Vinomakon/6-Axis-Robotarm/Arbeitsjournal.docx

Datum | Zeitaufwand | Abteil | Beschreibung
04.02.2025 | 60 min. | O | - Erstellung eines (Zeit-)Plans für die Durchführung der Arbeit
04.02.2025 | 90 min. | I | - Recherche nach einem passendem Microcontroller
07.02.2025 | 180 min. | D, P | - Testierung und Implementierung eines Motor-Treibers (TMC2130)
07.02.2025 | 180 min. | D | - Programmierung des ESP32
10.02.2025 | 180 min. | D | - Programmierung des ESP32
11.02.2025 | 240 min. | D | - Programmierung des ESP32 - Programmierung von einer Verbindung zwischen PC und ESP32
12.02.2025 | 180 min. | D, P | - Programmierung des ESP32 - Programmierung einer Funktionalität, um die Motoren per PC kontrollieren zu können (Siehe Video (https://youtu.be/VOz3QwY5qU8?si=MYe8dEC4yiWHyUO3))
14.02.2025 | 120 min. | D, P | - Programmierung des ESP32
20.02.2025 | 120 min. | D, P | - Testierung von grösseren Motoren mit einem Getriebegehäuse - Programmierung des ESP32
24.02.2025 | 120 min. | D, P | - Programmierung des ESP32 - Entwurf eines PCBs, das alle nötigen Komponenten halten kann
25.02.2025 | 180 min. | D | - Entwurf einer neuen PCB (v2)
26.02.2025 | 180 min. | D | - Finalisierung des PCB (v2)
26.02.2025 | 30 min. | O, I | - Standort-Besprechung
13.04.2025 | 120 min. | D, P | - Testierung und Bau eines Belt-drives
14.04.2025 | 240 min. | D, P | - Testierung und Bau eines Belt-drives
15.04.2025 | 180 min. | D, P | - Testierung und Bau eines Belt-drives
16.04.2025 | 120 min. | D, P | - Kreierung einer Basis, um die Haupt-PCB zu kühlen - Testierung der PCB mit einem neuen Code und des Belt-drives
26.06.2025 | 180 min. | D, P | - Arbeit an dem 3en Teil (3er Motor) des Roboter-Arms - Übertragung des Projektes von Fusion 360 auf Solidworks
08.07.25 | 180 min. | D, P | - Arbeit an dem 3en Teil (3er Motor) des Roboter-Arms - Übertragung des Projektes von Fusion 360 auf Solidworks
09.07.25 | 300 min. | D, P | - Arbeit an dem 3en Teil (3er Motor) des Roboter-Arms - Übertragung des Projektes von Fusion 360 auf Solidworks
14.07.25 | 240 min. | D, P | - Überarbeitung vom 2en Teil des Roboterarms aufgrund von Instabilität und eigener Wunsch an Verbesserung - Übertragung des 3en Teils von Fusion 360 in Solidworks - Weitere Arbeit am 3en Teil
15.07.2025 | 300 min. | D, P | - Überarbeitung vom 2en Teil des Roboterarms aufgrund von Instabilität und eigener Wunsch an Verbesserung - Übertragung des 3en Teils von Fusion 360 in Solidworks - Weitere Arbeit am 3en Teil
15.07.2025 | 10 min. | I | - Suche nach einem Namen für den Roboter
18.07.2025 | 60 min. | D, P | - Arbeit am 4en Teil des Roboterarms
20.07.2025 | 300 min. | D, P | - Arbeit am 4en Teil des Roboterarms
21.07.2025 | 180 min. | D, P | - Arbeit am 4en Teil des Roboterarms - Arbeit am 5en Teil des Roboterarms
22.07.2025 | 180 min. | D, P | - Arbeit am 6en Teil des Roboterarms - Testierung aller Teile Zusammen (Ausser der Rotationsbasis) - Troubleshooting mit Übergewichtung (Wechseln auf 24V, mehr Stromstärke)
23.07.2025 | 120 min. | D | - Verbesserung des Codes zuständig für die Kontrolle des Roboters (UI, Config Load/Save, Grössere Anzahl an verstellbaren Einstellungen)
24.07.2025 | 180 min. | D | - Verbesserung des Codes zuständig für die Kontrolle des Roboters (UI, Config Load/Save, Grössere Anzahl an verstellbaren Einstellungen, bessere und überblickbarere Interface) - Verbesserung des Codes vom ESP32 (Optimisierung, Anpassung zu den Veränderungen im Python-Code)
25.07.2025 | 180 min. | D, P | - Troubleshooting an inkorrekter Kommunikation zwischen PC und ESP32 - Troubleshooting an der Limitierung der Stromstärke - Bugfixing
29.07.2025 | 120 min. | D, P | - Arbeit am 2en und 1en Teil des Roboters
02.08.2025 | 180 min. | D, P | - Arbeit am 2en und 1en Teil des Roboters - Verbesserung vom 4en Teil vom Roboterarm
03.08.2025 | 300 min. | D, P | - Arbeit am 2en und 1en Teil des Roboters - Weitere Verbesserungen an jeglichen Teilen des Roboterarms - Zusammenstellung einer digitalen Konstruktion von allen Modellen und Teilen in eine übersichtliche und effektive Visualisierung des ganzen Roboterarms
05.08.2025 | 180 min. | D, P | - Überarbeitung des 3en Teils des Roboterarms - Löten und Anfertigung von einer neuen Platte
06.08.2025 | 240 min. | D, P | - Überarbeitung des 3en und 4en Teils des Roboterarms
07.08.2025 | 240 min. | D, P | - Überarbeitung des 3en Teils des Roboterarms - Troubleshooting an C++ code - Zusammenstellung des ersten funktionstüchtigen Prototyps aus allen Teilen und kurzes Testen (MEILENSTEIN)
10.08.2025 | 180 min | D, P | - Anfang an der Implementation von IK (Inverse Kinematics) in das Projekt (1. Schritt: Herausfinden, wie die Winkel anhand von einer Position berechnet werden können)
11.08.2025 | 120 min. | D, P | - (Theoretische und praktische Auseinandersetzung, dazu auch das Verstehen, wie so ein Prozess abläuft) - Programmierung von einem Test-Programm, um das IK-Prinzip vorerst zu testen (Eigene Class «Vector», «Euler’sche» Rotationsmatrix)
12.08.2025 | 90 min. | D, P | - Weiterführung an der Implementation von IK - Programmierung von einem Test-Programm, um das IK-Prinzip vorerst zu testen
14.08.2025 | 40 min. | D, P | - Einsetzung und Testierung des Homings
15.08.2025 | 90 min. | D, P | - Programmierung der Homing-Sequenz und praktische Testung des Homings auf dem Roboter - Überarbeitung des 5en Teils für die Verkabelung
16.08.2025 | 60 min. | D, P | - Überarbeitung des 6en Teils für die Verkabelung
17.08.2025 | 60 min. | D, P | - Zusammensetzung des Roboters mit der besseren Verkabelung - Bessere Verkabelung für eine bessere visuelle Ansicht - Löten der Limit-Switches und deren Anbringung an den Roboter
21.08.2025 | 120 min. | D | - Implementation von des erstellten IK-Porgramms in den UI und in den C++ Code (Kein Praktisches Testen aufgrund von Zusammenbruch vom Labornetzgerät)

Organisation, Informationsbeschaffung, Digitale Arbeit, Praktische Arbeit, Auswertung
