Vinomakon/6-Axis-Robotarm/Documents/Dokumentation/LaTeX Dokumentation/images/KiCAD/Driver Carrier v2_Page_2 cropped.png

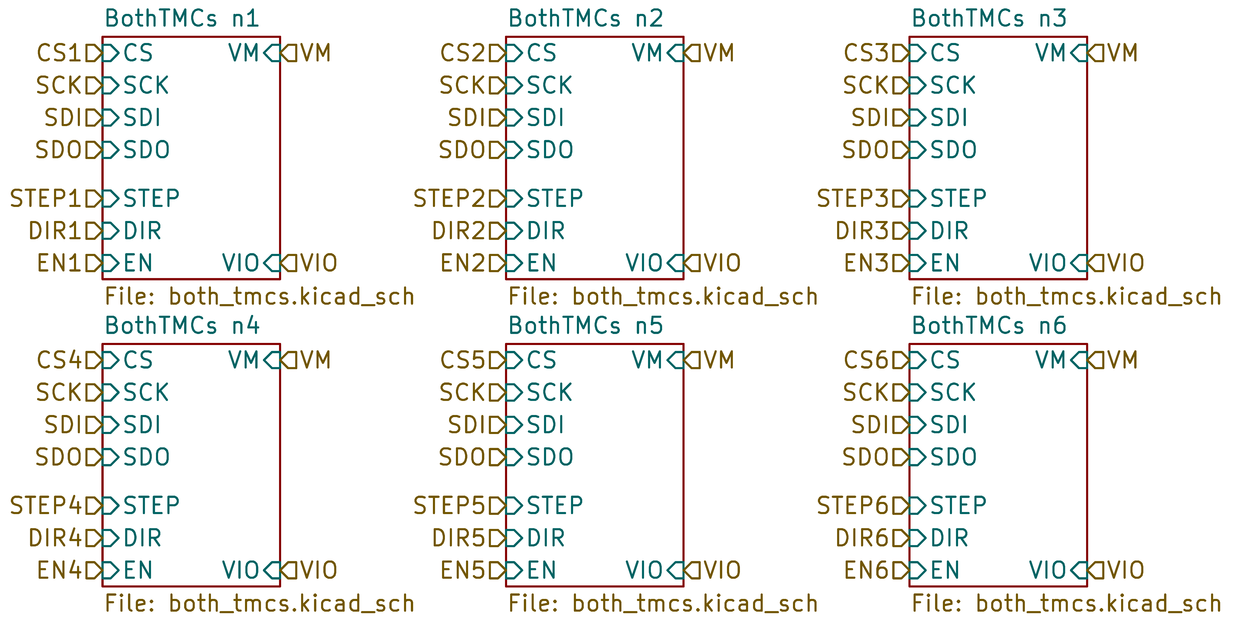
Documents/Dokumentation/LaTeX Dokumentation/images/KiCAD/Driver Carrier v2_Page_2 cropped.png
