Vinomakon/6-Axis-Robotarm/Documents/Dokumentation/LaTeX Dokumentation/images/Online/Phase Stepping.png

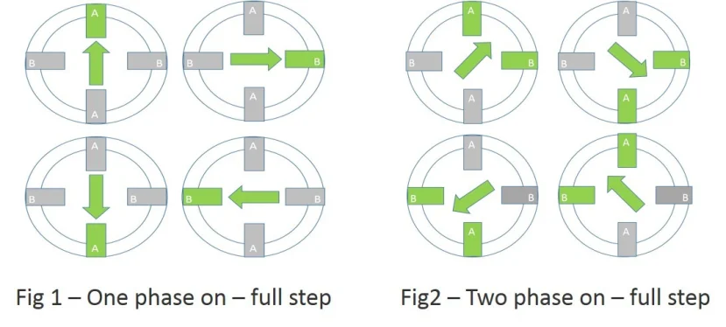
Documents/Dokumentation/LaTeX Dokumentation/images/Online/Phase Stepping.png
