Vinomakon/6-Axis-Robotarm/Documents/Dokumentation/LaTeX Dokumentation/images/Solidworks/Arm1_v3 Front.PNG

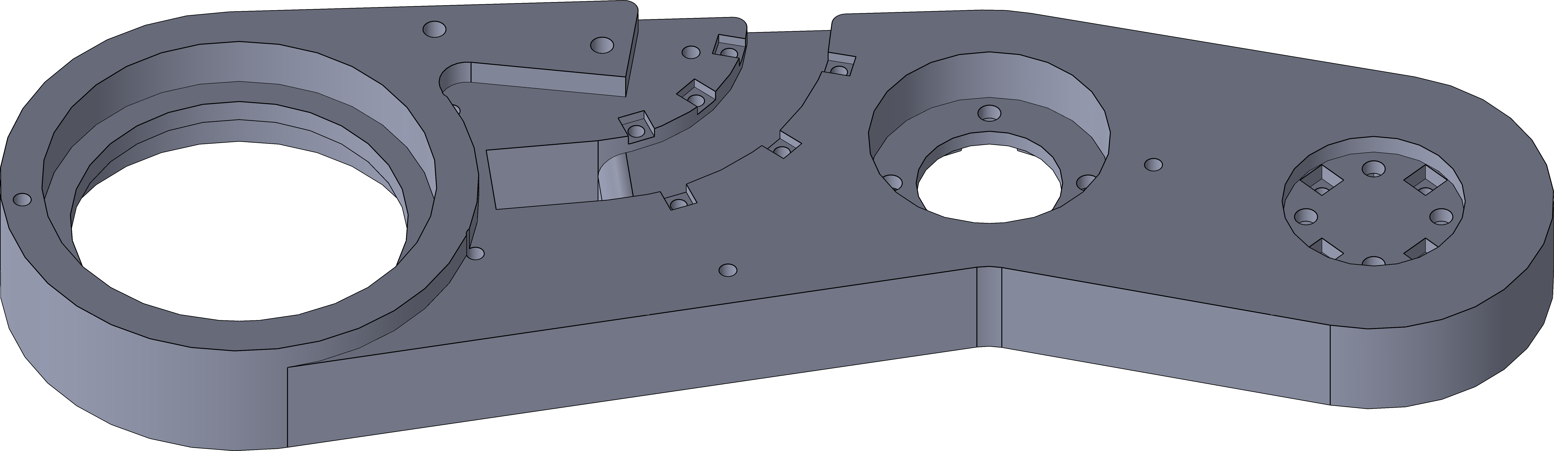
Documents/Dokumentation/LaTeX Dokumentation/images/Solidworks/Arm1_v3 Front.PNG
