Vinomakon/6-Axis-Robotarm/Documents/Dokumentation/LaTeX Dokumentation/images/Solidworks/Arm1Pulley1_v2.PNG

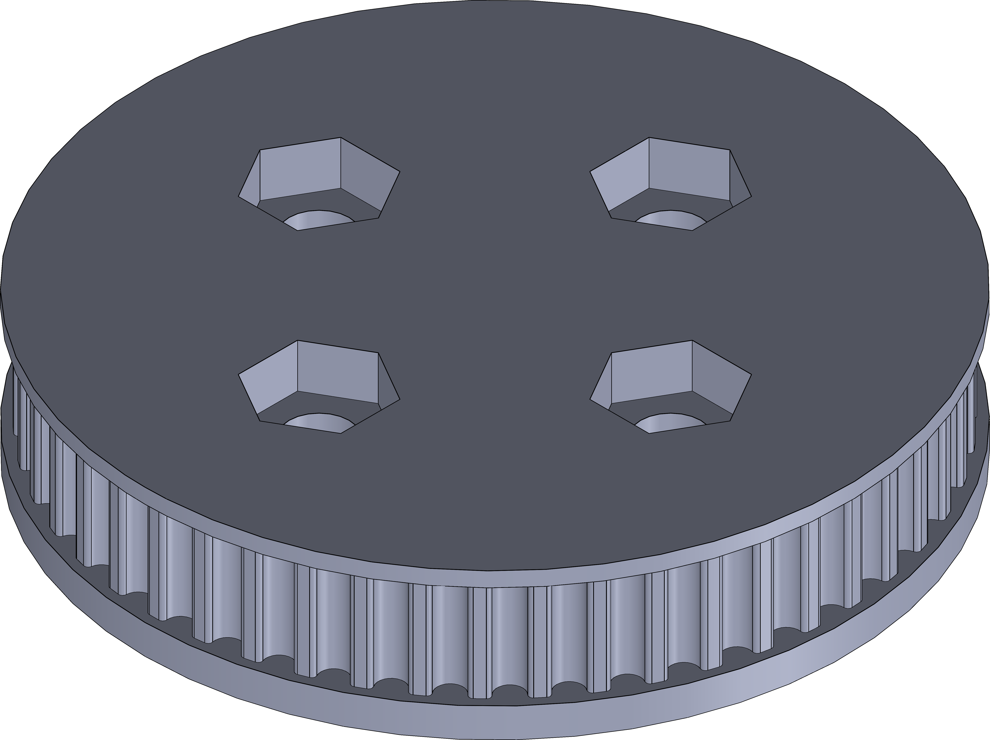
Documents/Dokumentation/LaTeX Dokumentation/images/Solidworks/Arm1Pulley1_v2.PNG
