Vinomakon/6-Axis-Robotarm/Documents/Dokumentation/LaTeX Dokumentation/images/Solidworks/Arm1Pulley2_v1 Front.PNG

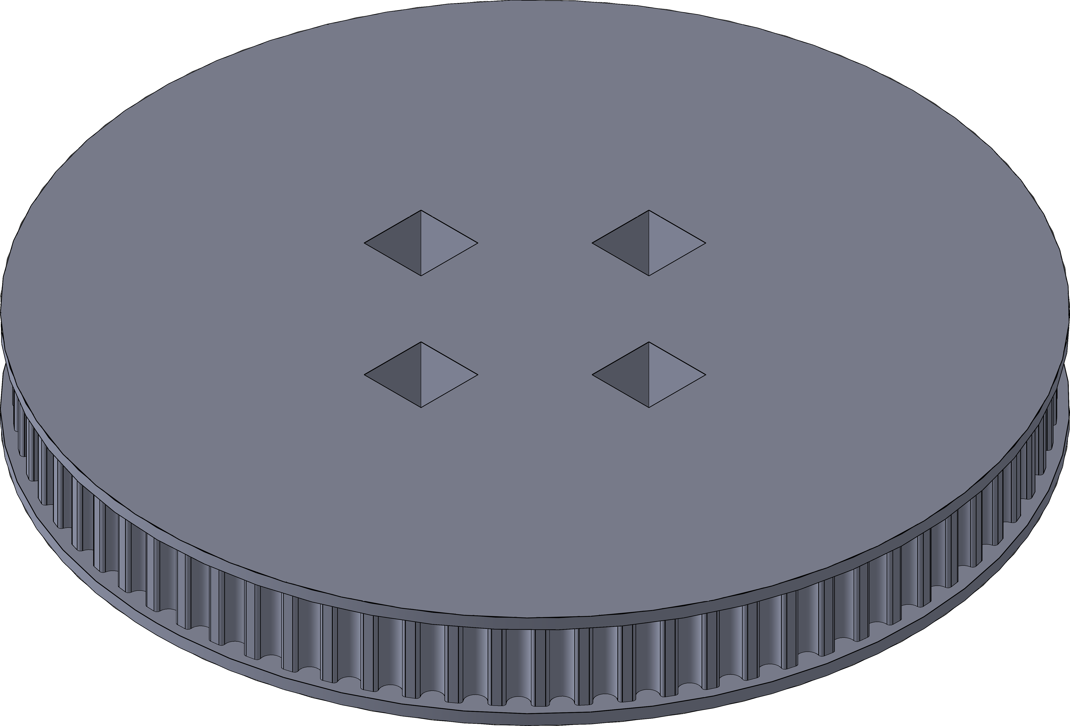
Documents/Dokumentation/LaTeX Dokumentation/images/Solidworks/Arm1Pulley2_v1 Front.PNG
