Vinomakon/6-Axis-Robotarm/Documents/Dokumentation/LaTeX Dokumentation/images/Solidworks/Arm2_v1 Back.PNG

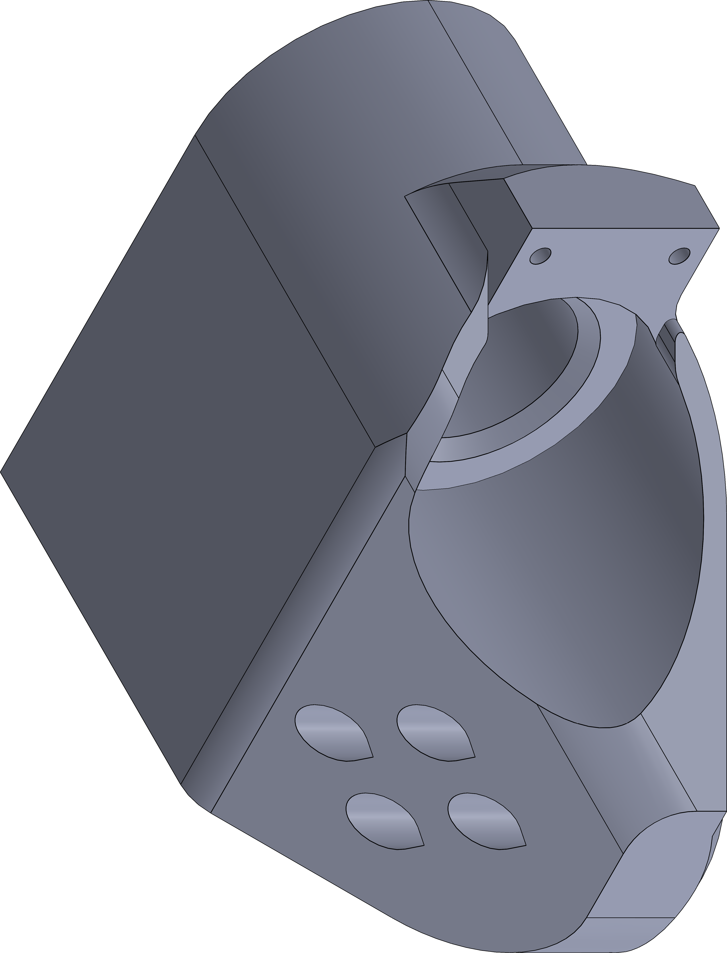
Documents/Dokumentation/LaTeX Dokumentation/images/Solidworks/Arm2_v1 Back.PNG
