Vinomakon/6-Axis-Robotarm/Documents/Dokumentation/LaTeX Dokumentation/images/Solidworks/Arm2_v2 Back.PNG

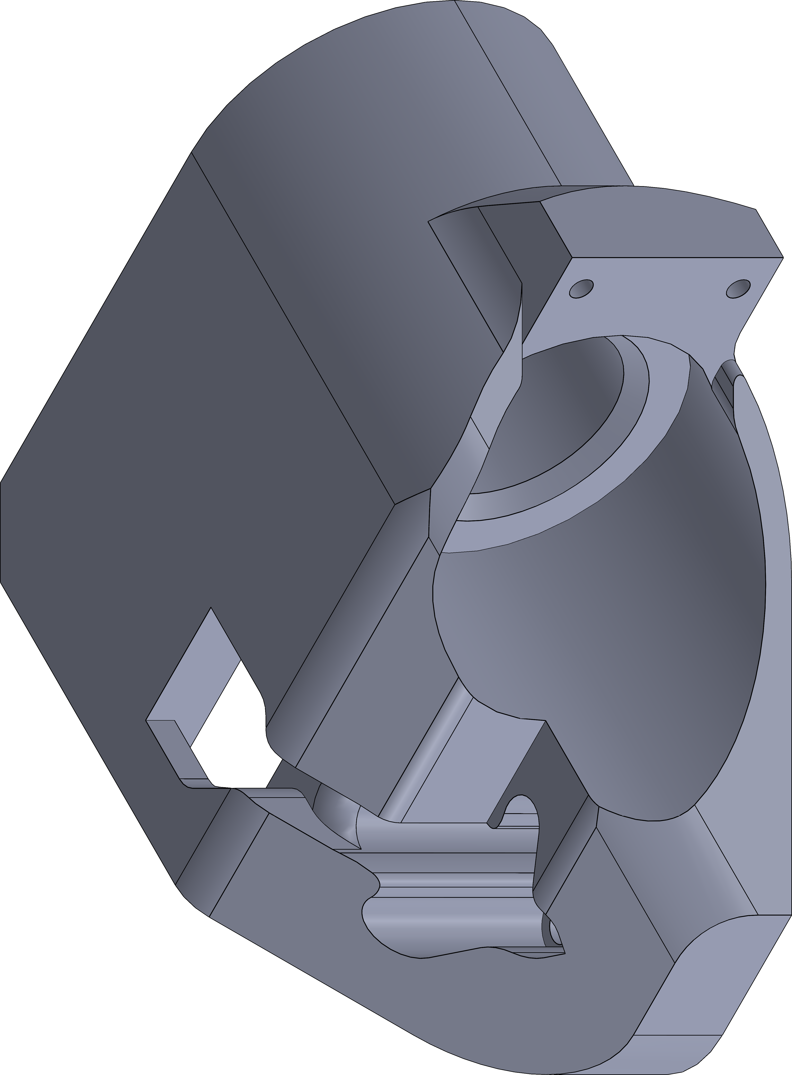
Documents/Dokumentation/LaTeX Dokumentation/images/Solidworks/Arm2_v2 Back.PNG
