Vinomakon/6-Axis-Robotarm/Documents/Dokumentation/LaTeX Dokumentation/images/Solidworks/Arm3_v2 Front.PNG

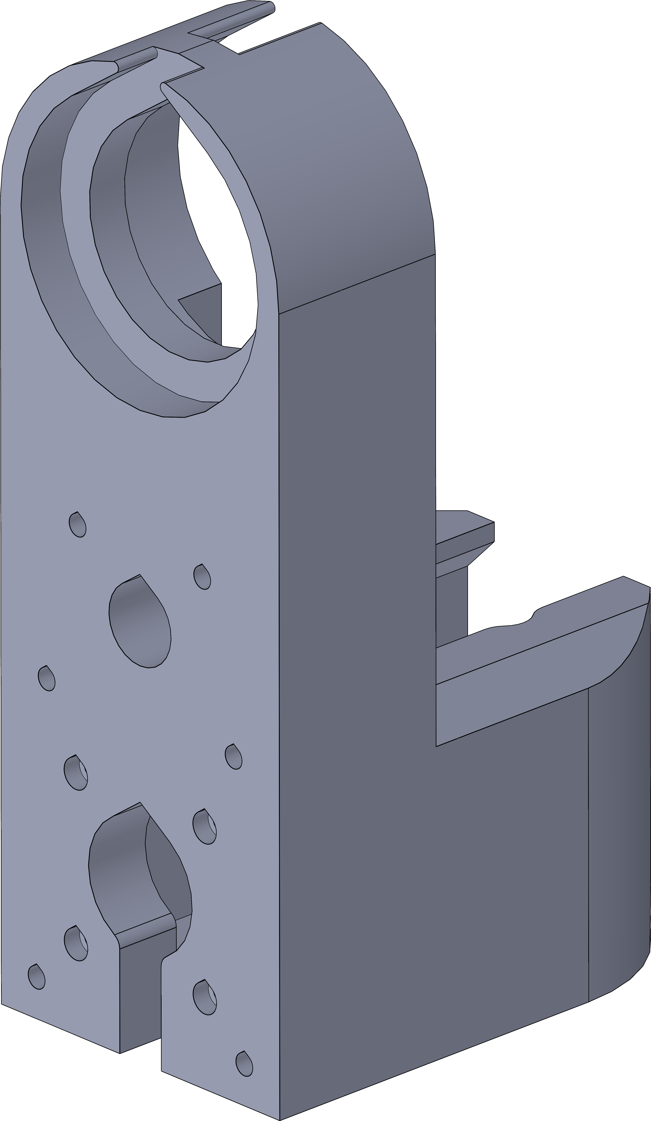
Documents/Dokumentation/LaTeX Dokumentation/images/Solidworks/Arm3_v2 Front.PNG
