Vinomakon/6-Axis-Robotarm/Documents/Dokumentation/LaTeX Dokumentation/images/Solidworks/Arm3Pulley_v1.PNG

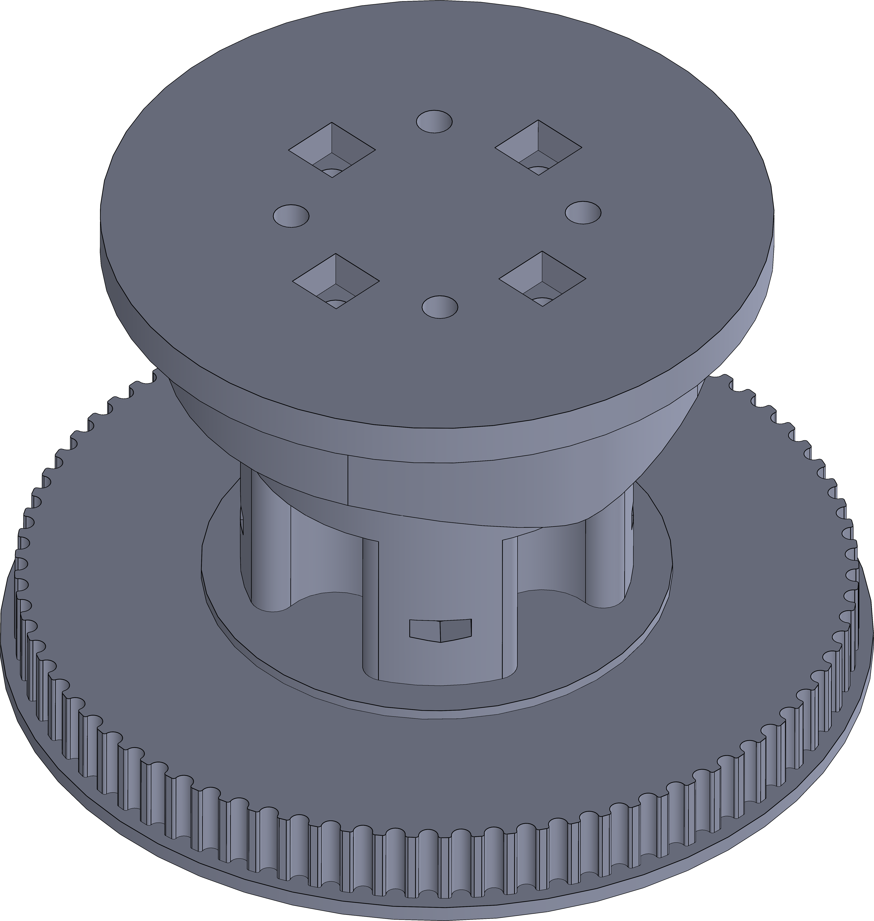
Documents/Dokumentation/LaTeX Dokumentation/images/Solidworks/Arm3Pulley_v1.PNG
