Vinomakon/6-Axis-Robotarm/Documents/Dokumentation/LaTeX Dokumentation/images/Solidworks/Arm4_v2.PNG

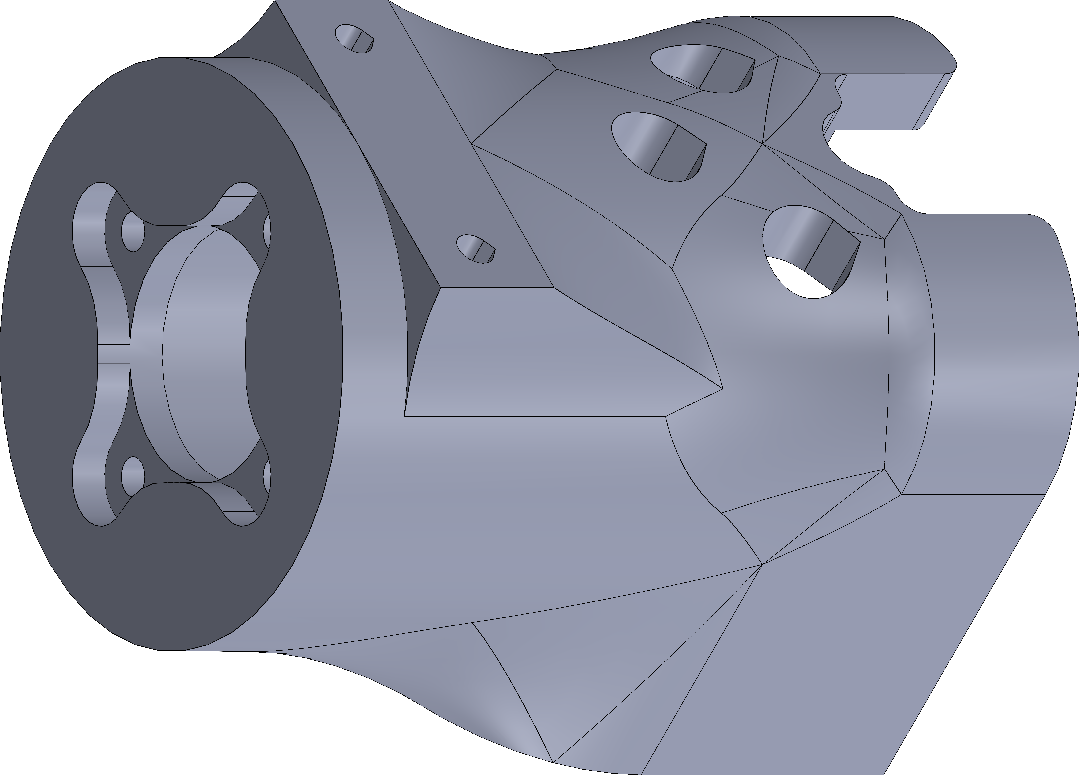
Documents/Dokumentation/LaTeX Dokumentation/images/Solidworks/Arm4_v2.PNG
