Vinomakon/6-Axis-Robotarm/Documents/Dokumentation/LaTeX Dokumentation/images/Solidworks/Base_v1.PNG

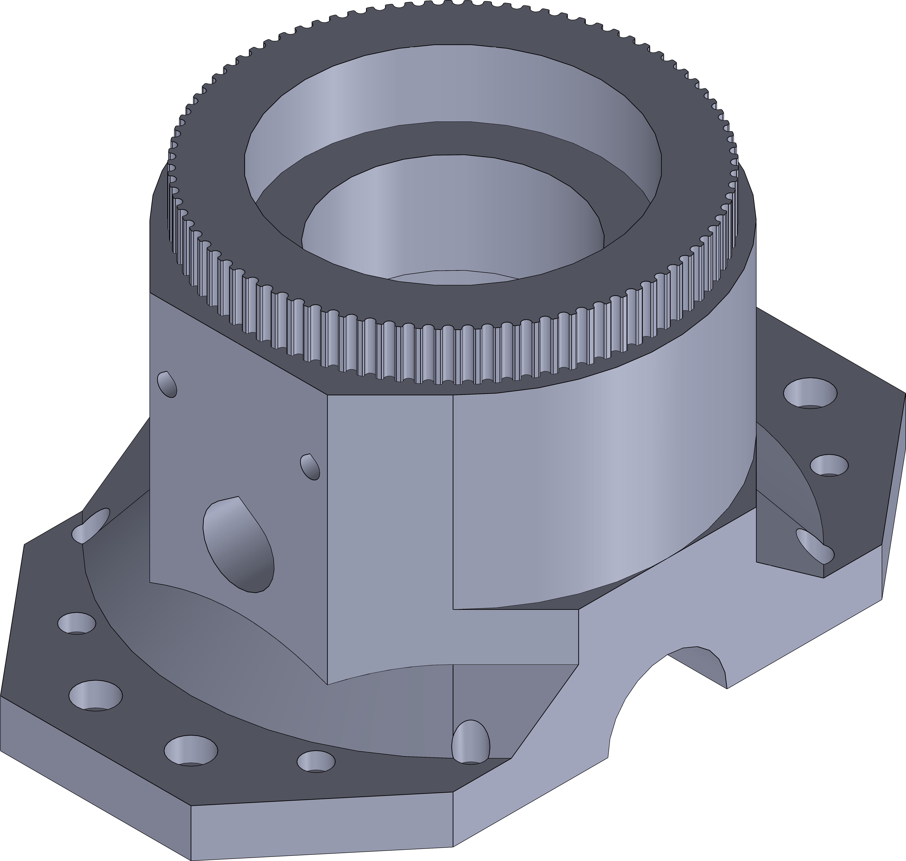
Documents/Dokumentation/LaTeX Dokumentation/images/Solidworks/Base_v1.PNG
