Vinomakon/6-Axis-Robotarm/Pictures/Screenshot 2025-06-26 232931.png

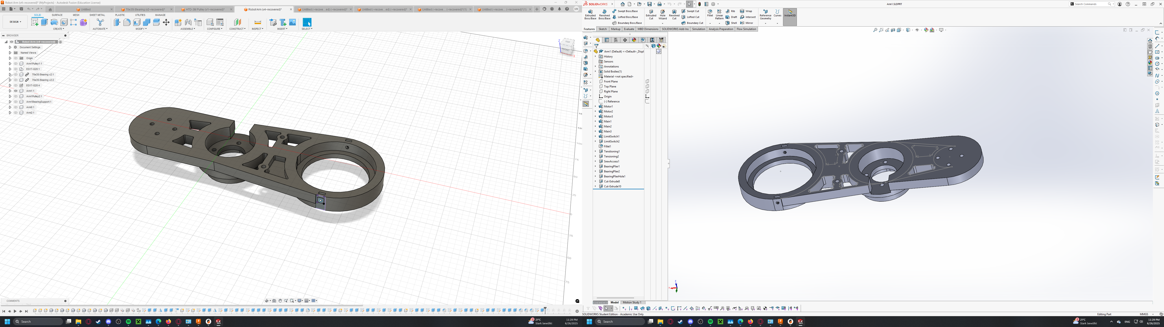
Pictures/Screenshot 2025-06-26 232931.png
