Vinomakon/6-Axis-Robotarm/Pictures/Screenshot 2025-07-10 113203.png

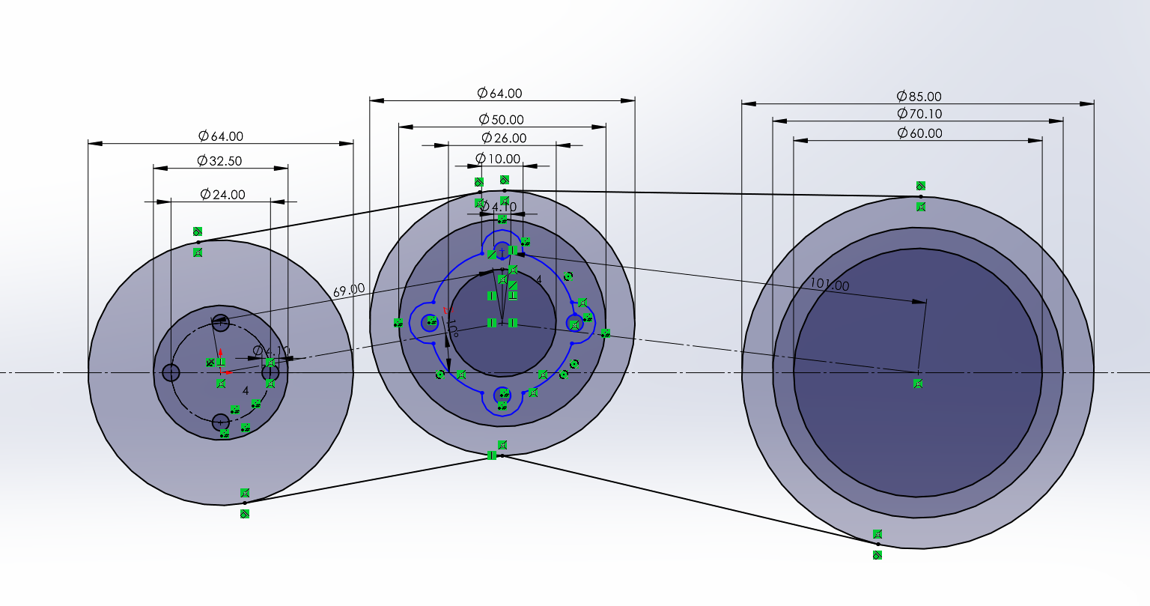
Pictures/Screenshot 2025-07-10 113203.png
