Vinomakon/6-Axis-Robotarm/Pictures/Screenshot 2025-07-20 194154.png

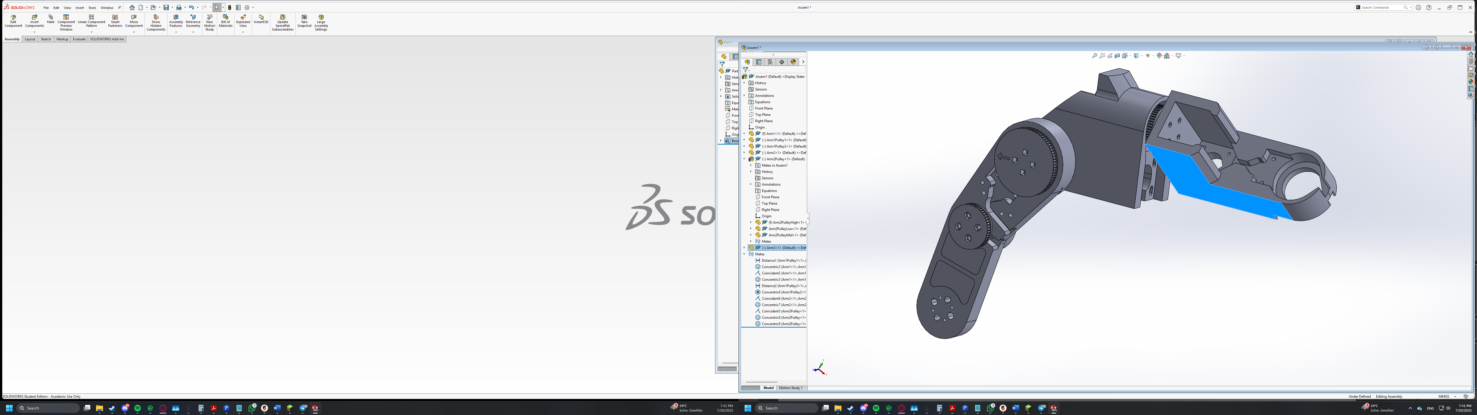
Pictures/Screenshot 2025-07-20 194154.png
