Vinomakon/6-Axis-Robotarm/Pictures/Screenshot 2025-07-26 214147.png

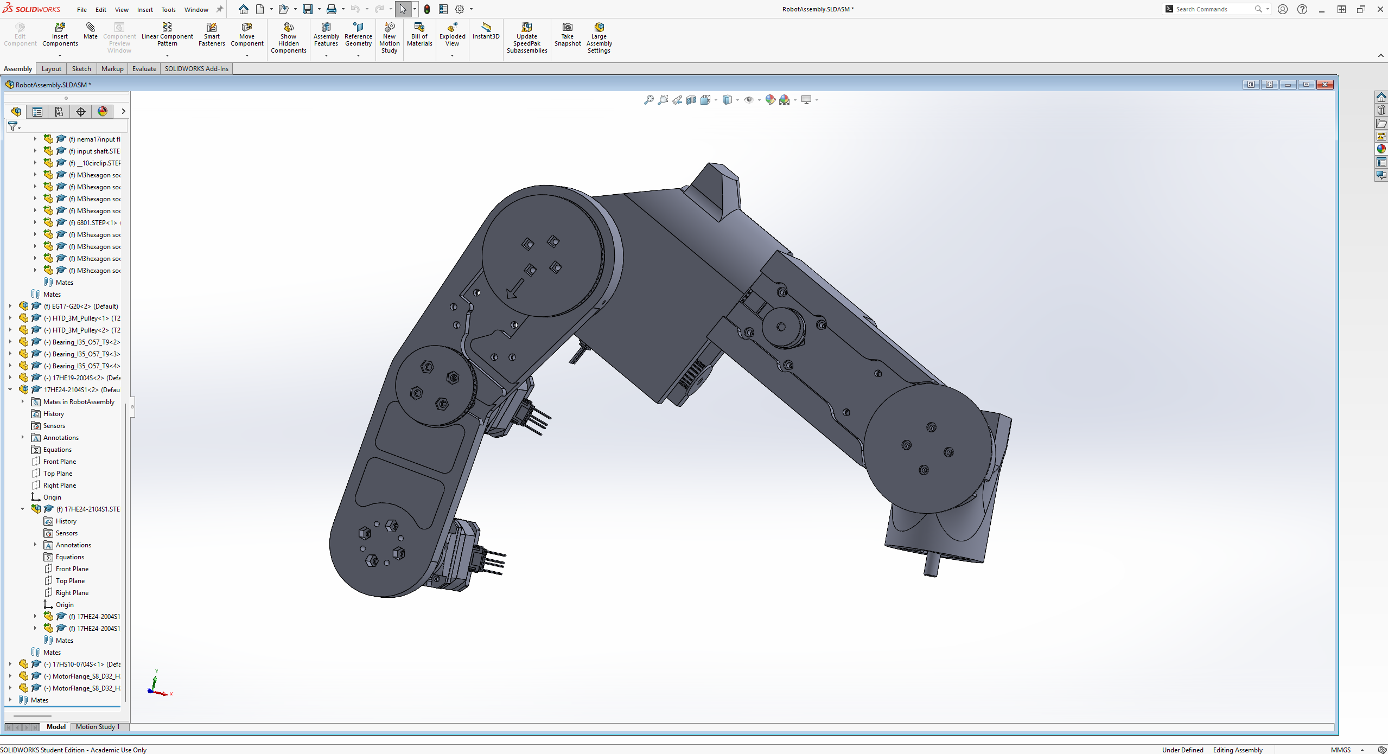
Pictures/Screenshot 2025-07-26 214147.png
