Vinomakon/6-Axis-Robotarm/Pictures/Screenshot 2025-07-31 211233.png

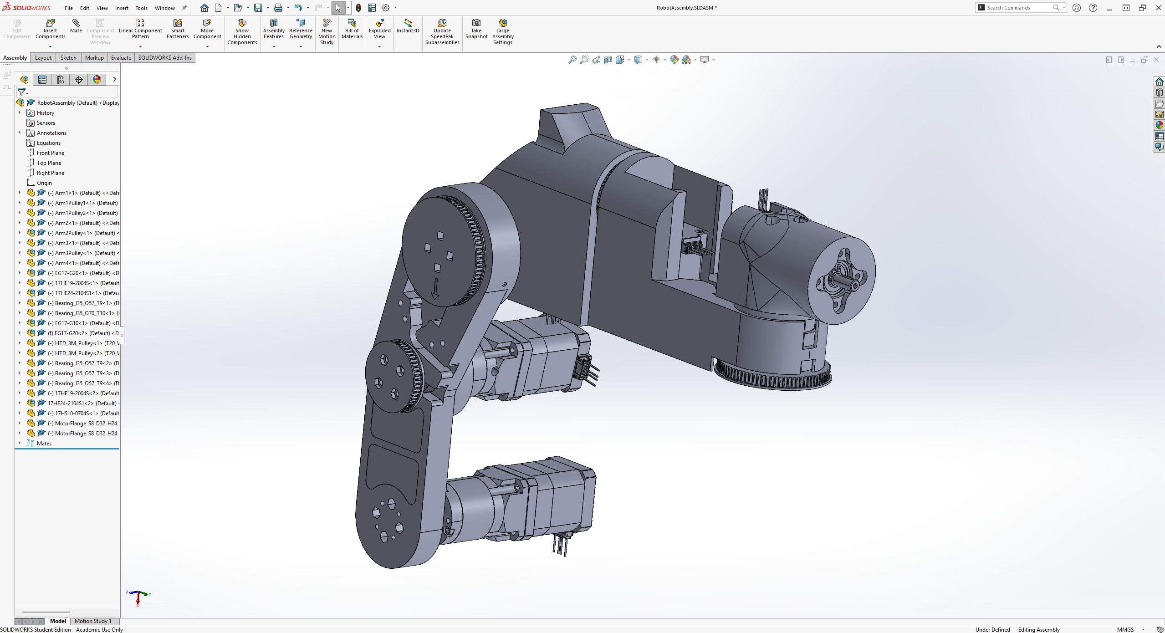
Pictures/Screenshot 2025-07-31 211233.png
