Vinomakon/6-Axis-Robotarm/Pictures/Screenshot 2025-07-31 211432.png

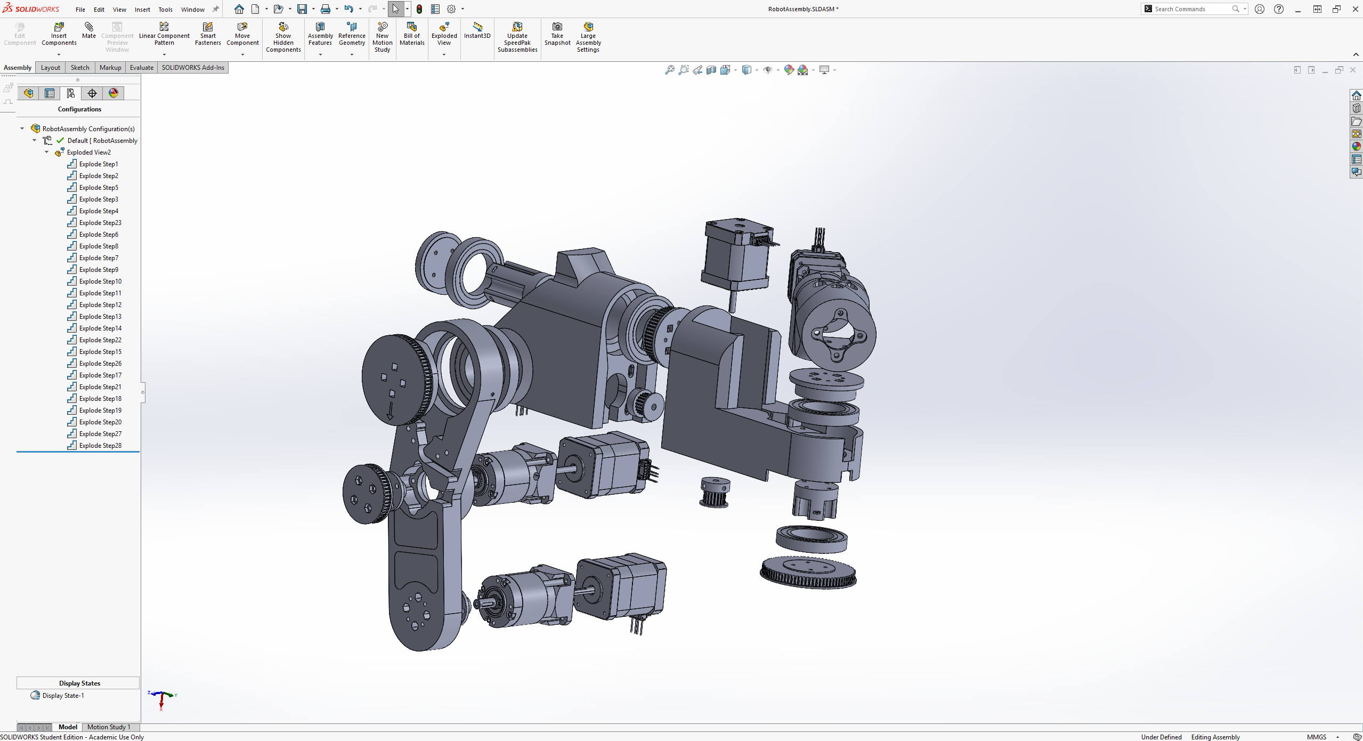
Pictures/Screenshot 2025-07-31 211432.png
