Vinomakon/6-Axis-Robotarm/Poster/Images/EndEffectorRotation.png

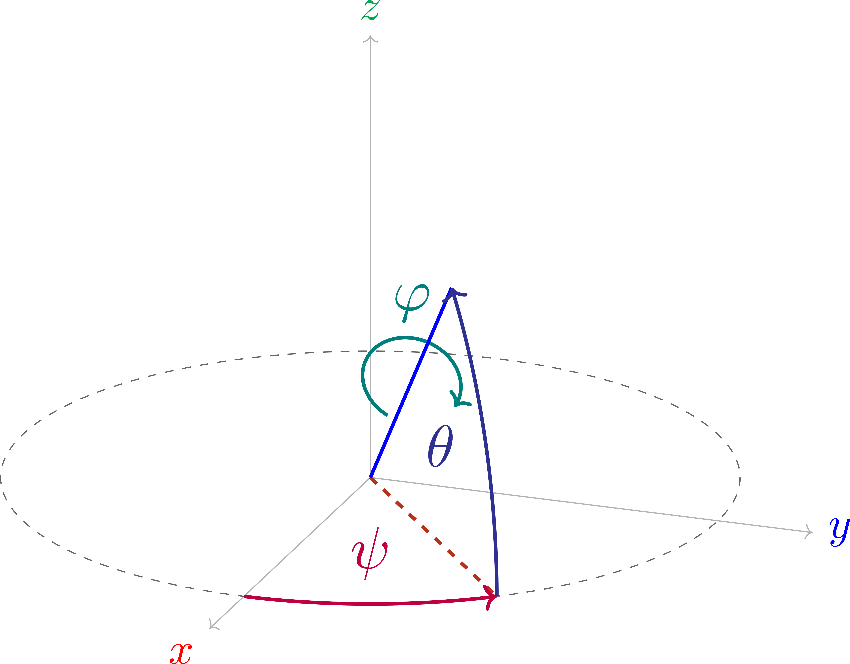
Poster/Images/EndEffectorRotation.png
