Vinomakon/6-Axis-Robotarm/Poster/Tex/FK1.png

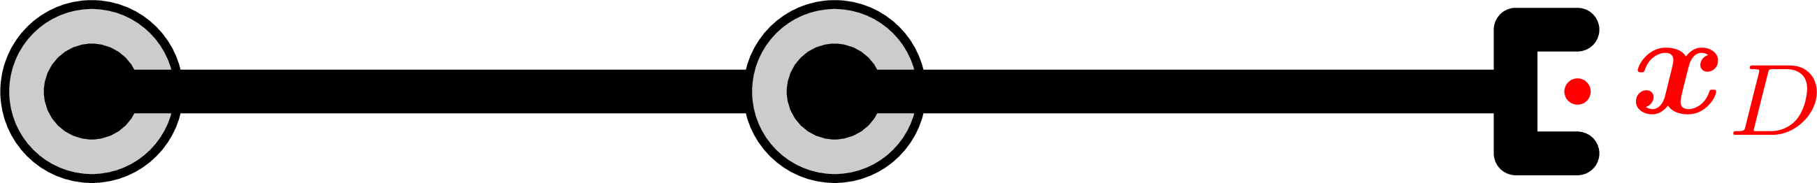
Poster/Tex/FK1.png
