Vinomakon/6-Axis-Robotarm/Poster/Tex/FK2.png

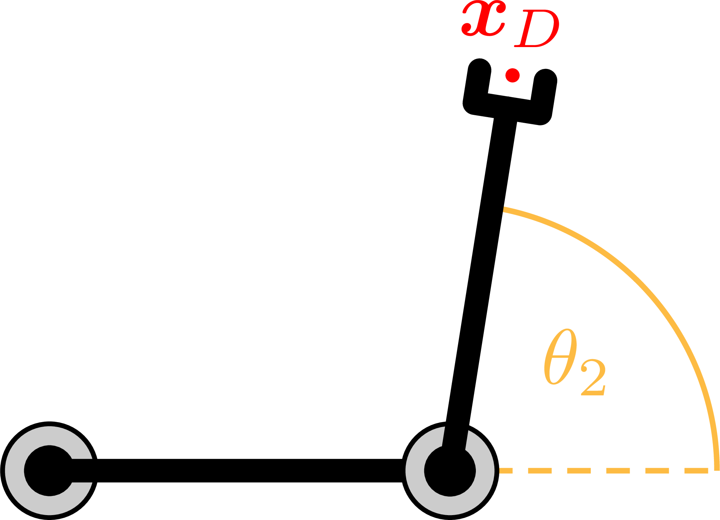
Poster/Tex/FK2.png
