Vinomakon/6-Axis-Robotarm/Poster/Tex/FK3.png

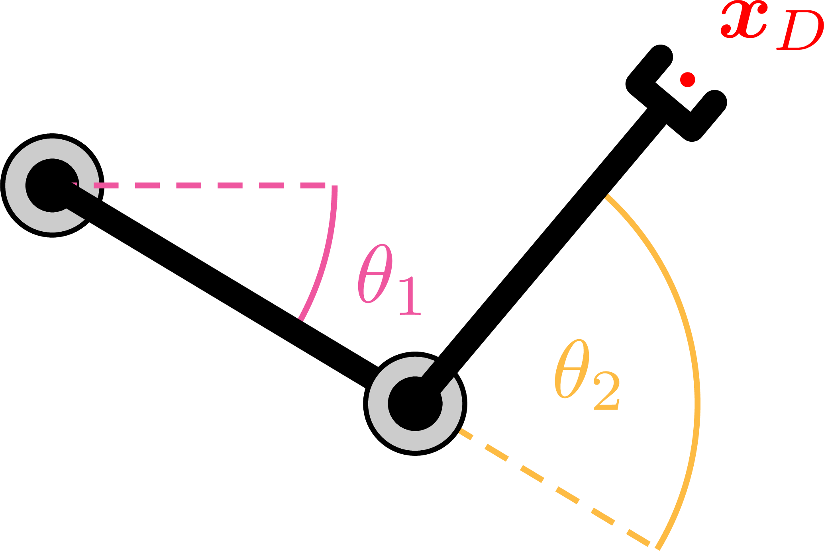
Poster/Tex/FK3.png
