Vinomakon/6-Axis-Robotarm/Poster/Tex/IK1.png

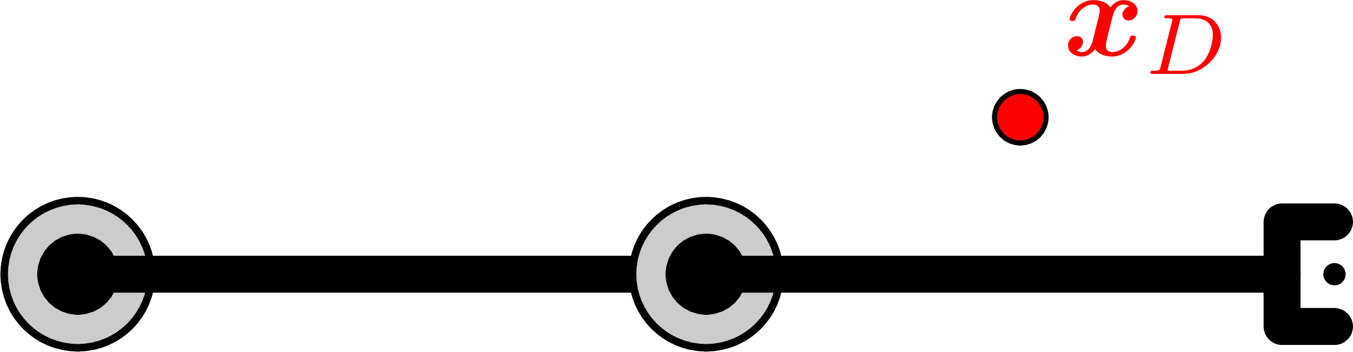
Poster/Tex/IK1.png
