Vinomakon/6-Axis-Robotarm/Poster/Tex/IK2.png

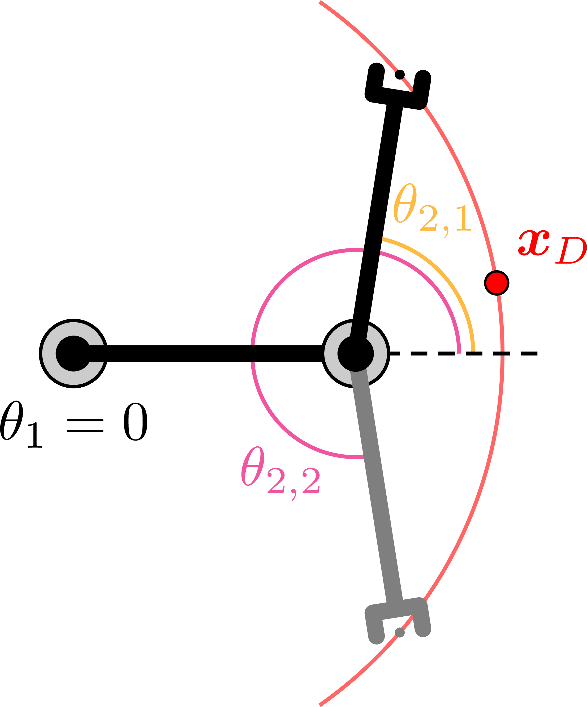
Poster/Tex/IK2.png
