Vinomakon/6-Axis-Robotarm/Poster/Tex/IK3.png

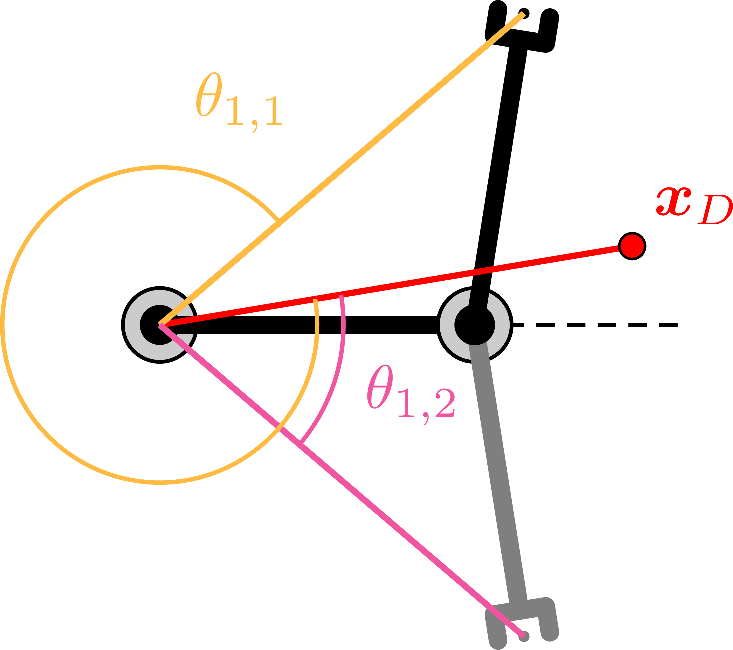
Poster/Tex/IK3.png
