Vinomakon/6-Axis-Robotarm/Poster/Tex/position0.png

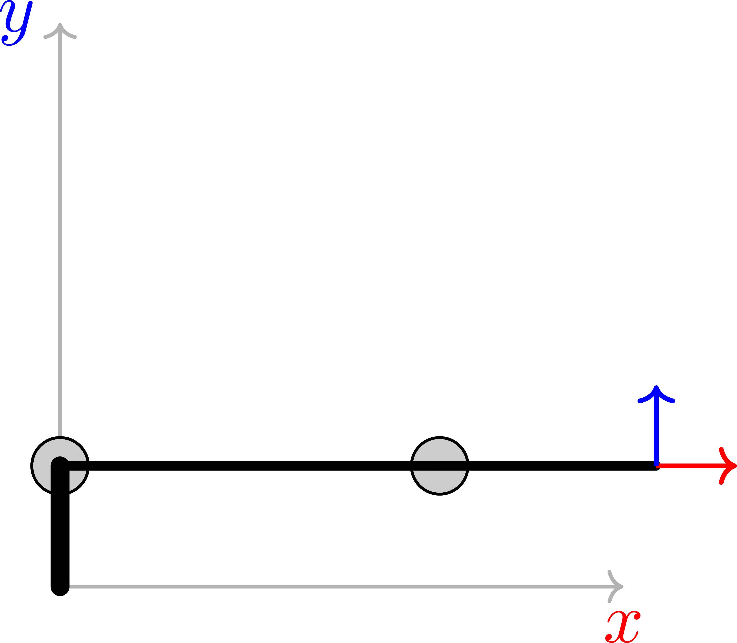
Poster/Tex/position0.png
