Vinomakon/6-Axis-Robotarm/Poster/Tex/position1.png

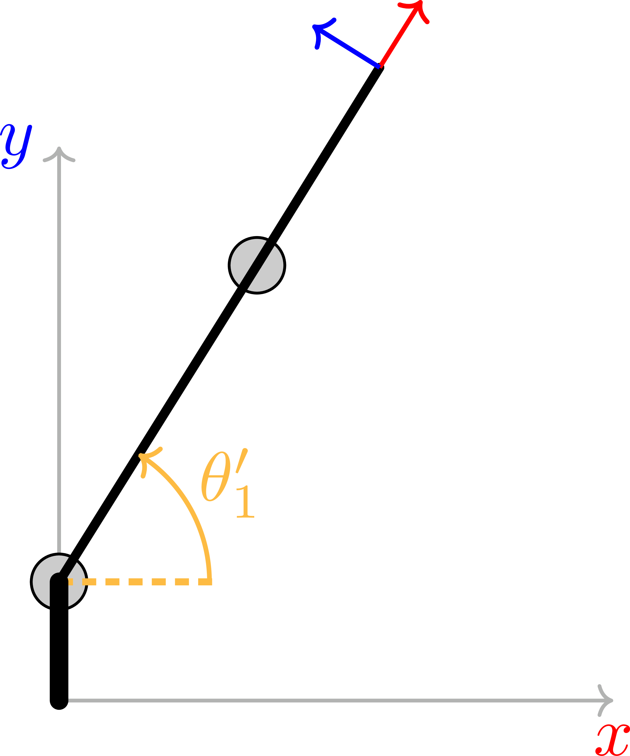
Poster/Tex/position1.png
