Vinomakon/6-Axis-Robotarm/Poster/Tex/position2.png

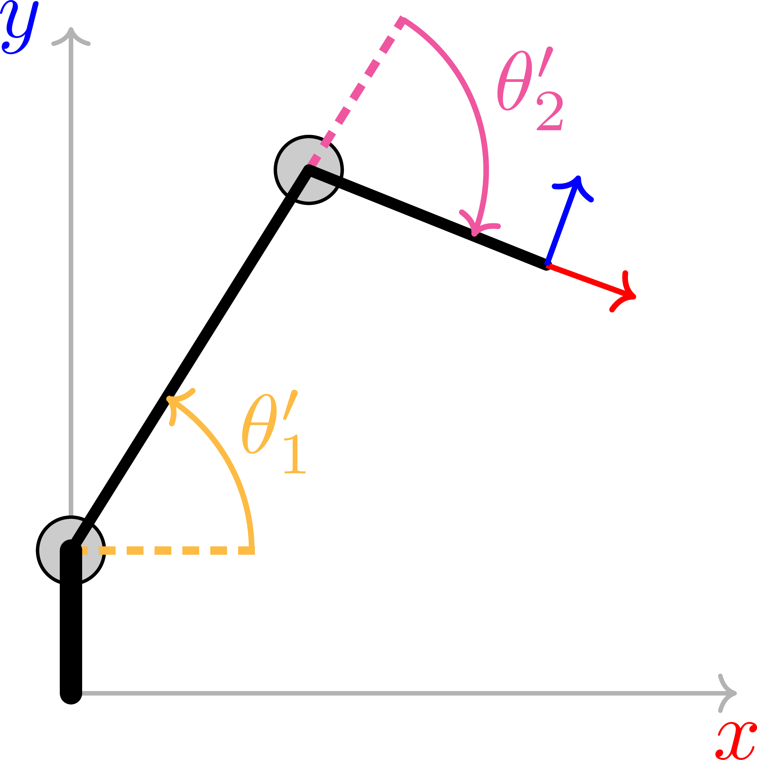
Poster/Tex/position2.png
