Vinomakon/6-Axis-Robotarm/Poster/Tex/position3.png

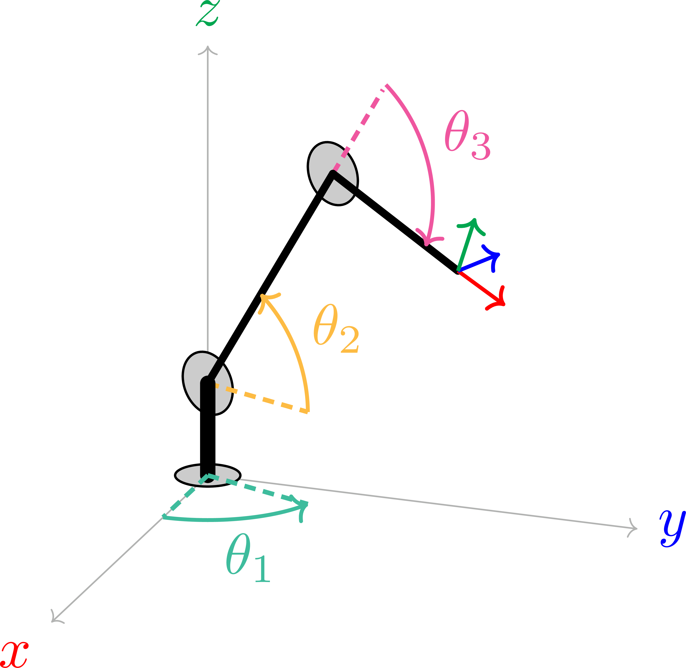
Poster/Tex/position3.png
