Vinomakon/6-Axis-Robotarm/Poster/Tex/rotation1.png

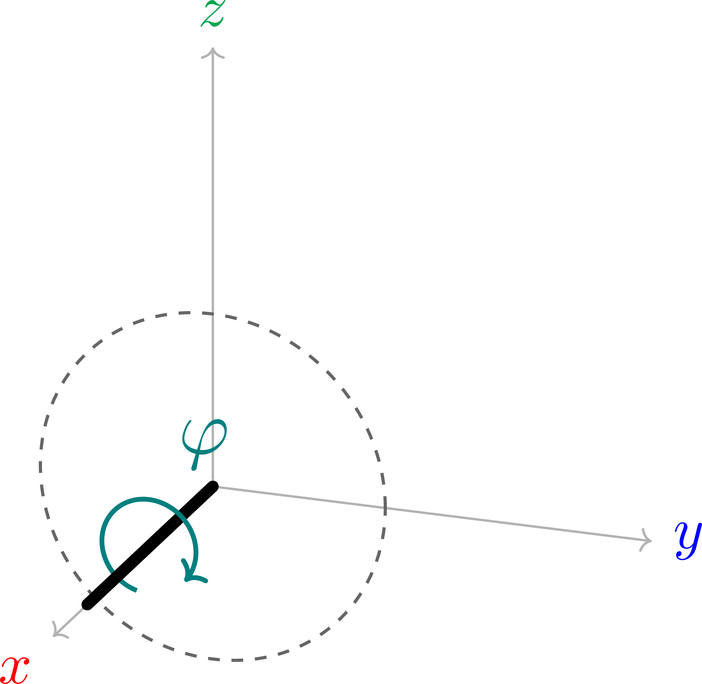
Poster/Tex/rotation1.png
