Vinomakon/6-Axis-Robotarm/Poster/Tex/rotation2.png

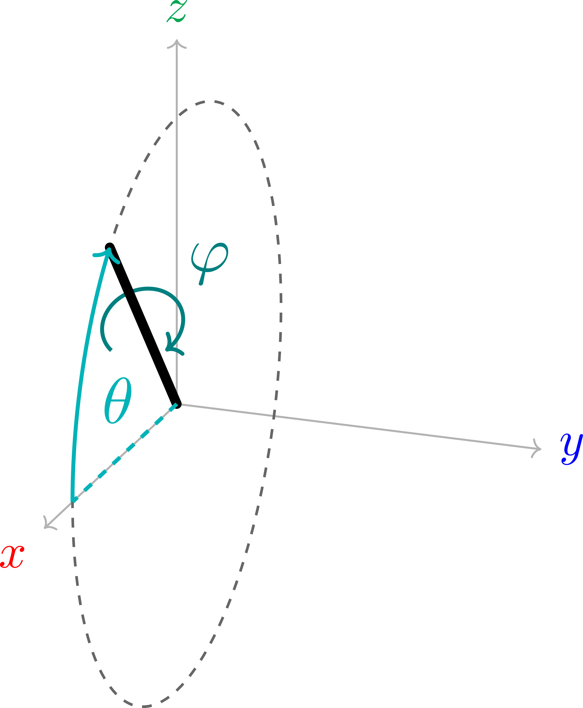
Poster/Tex/rotation2.png
