Vinomakon/6-Axis-Robotarm/Poster/Tex/rotation3.png

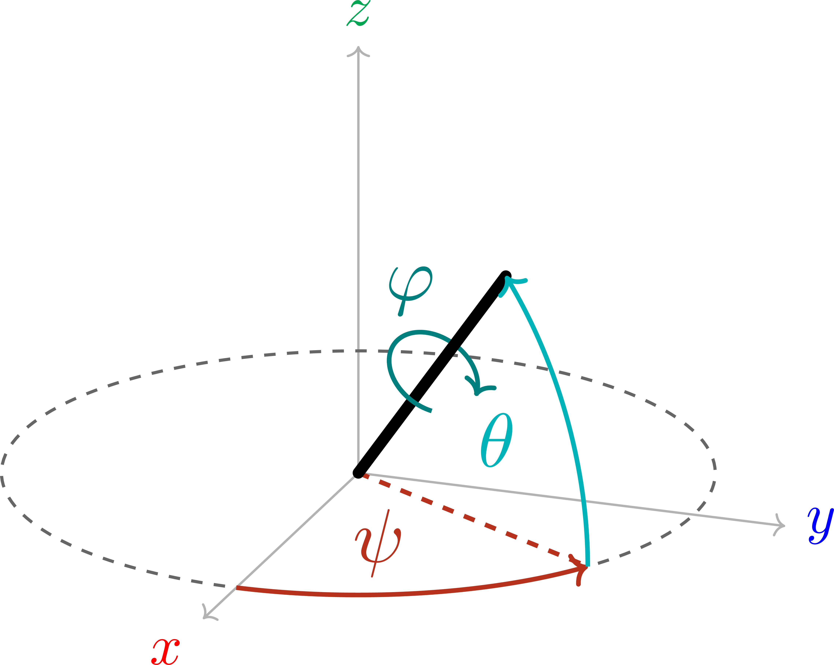
Poster/Tex/rotation3.png
