Vinomakon/6-Axis-Robotarm/Documents/BOM.xlsx

Alternate Name | Type | Quantity | Description | Link | Price pp | Price | Converted Price
NEMA 17 Stepper 23mm | 17HE08-1004S | 1 | E Series Nema 17 Bipolar 1.8deg 17Ncm(24.07oz.in) 1A 42x42x23mm 4 Wires | omc-stepperonline.com (https://www.omc-stepperonline.com/e-series-nema-17-bipolar-1-8deg-17ncm-24-07oz-in-1a-42x42x23mm-4-wires-17he08-1004s) | 4.34 € | 4.34 € | CHF 4.19 | #VALUE! | 0.97 CHF
NEMA 17 Stepper 48mm | 17HE19-2004S | 3 | E Series Nema 17 Bipolar 55Ncm(77.88oz.in) 2A 42x42x48mm 4 Wires w/ 1m Cable & Connector | omc-stepperonline.com (https://www.omc-stepperonline.com/e-series-nema-17-bipolar-55ncm-77-88oz-in-2a-42x48mm-4-wires-w-1m-cable-connector-17he19-2004s) | 6.23 € | 18.69 € | CHF 18.06 | #VALUE! | 0.92 CHF
NEMA 17 Stepper 60mm | 17HE24-2104S1 | 2 | E Series Nema 17 Bipolar 60Ncm(84.97oz.in) 2.1A 42x42x60mm 4 Wires w/ 1m Cable & Connector | omc-stepperonline.com (https://www.omc-stepperonline.com/e-series-nema-17-bipolar-60ncm-84-97oz-in-2-1a-42x42x60mm-4-wires-w-1m-cable-connector-17he24-2104s1) | 8.79 € | 17.58 € | CHF 16.98
Gearbox 10:1 | EG17-G10 | 1 | EG Series Planetary Gearbox Gear Ratio 10:1 Backlash 15arc-min for Nema 17 Stepper Motor | omc-stepperonline.com (https://www.omc-stepperonline.com/eg-series-planetary-gearbox-gear-ratio-10-1-backlash-15-arc-min-for-nema-17-stepper-motor-eg17-g10) | 23.60 € | 23.60 € | CHF 22.80
Gearbox 20:1 | EG17-G20 | 2 | EG Series Planetary Gearbox Gear Ratio 20:1 Backlash 20arc-min for Nema 17 Stepper Motor | omc-stepperonline.com (https://www.omc-stepperonline.com/eg-series-planetary-gearbox-gear-ratio-20-1-backlash-20-arc-min-for-nema-17-stepper-motor-eg17-g20) | 29.32 € | 58.64 € | CHF 56.65
HTD 3M Belt 10mm 396mm | 10mm 3M 396(Teeth132) | 1 | aliexpress.com (https://de.aliexpress.com/item/1005004916376607.html) | aliexpress.com (https://de.aliexpress.com/item/1005004916376607.html) | 4.36 CHF | 4.36 CHF | CHF 4.36
Rolling Limit Switch | ZW12-3 | 1 | aliexpress.com (https://de.aliexpress.com/item/1005002844903085.html) | aliexpress.com (https://de.aliexpress.com/item/1005002844903085.html) | 4.02 CHF | 4.02 CHF | CHF 4.02
 | 8mm Flange | 1 | aliexpress.com (https://de.aliexpress.com/item/4000208248034.html) | aliexpress.com (https://de.aliexpress.com/item/4000208248034.html) | 1.46 CHF | 1.46 CHF | CHF 1.46
3x10x4mm Bearing | 623ZZ | 1 | aliexpress.com (https://de.aliexpress.com/item/560947729.html) | aliexpress.com (https://de.aliexpress.com/item/560947729.html) | 4.84 CHF | 4.84 CHF | CHF 4.84
HTD 3M Belt 6mm 396mm | 6mm 3M 396(Teeth132) | 2 | aliexpress.com (https://de.aliexpress.com/item/1005004916376607.html) | aliexpress.com (https://de.aliexpress.com/item/1005004916376607.html) | 4.99 CHF | 9.98 CHF | CHF 9.98
 | Braid Sleeving 10m 12mm | 1 | aliexpress.com (https://de.aliexpress.com/item/1005007486025295.html) | aliexpress.com (https://de.aliexpress.com/item/1005007486025295.html) | 3.59 CHF | 3.59 CHF | CHF 3.59
 | Braid Sleeving 10m 16mm | 1 | aliexpress.com (https://de.aliexpress.com/item/1005007486025295.html) | aliexpress.com (https://de.aliexpress.com/item/1005007486025295.html) | 5.45 CHF | 5.45 CHF | CHF 5.45
Timing Pulley 5mm with 20 Teeth | Timing Pulley 8mm 10mm 16 Teeth | 1 | aliexpress.com (https://de.aliexpress.com/item/1005006454716533.html) | aliexpress.com (https://de.aliexpress.com/item/1005006454716533.html) | 3.11 CHF | 3.11 CHF | CHF 3.11
Timing Pulley 8mm with 16 Teeth | 3 x Timing Pulley 6mm 10mm 20 Teeth | 1 | aliexpress.com (https://de.aliexpress.com/item/1005007599104994.html) | aliexpress.com (https://de.aliexpress.com/item/1005007599104994.html) | 7.99 CHF | 7.99 CHF | CHF 7.99
HTD 3M Belt 10mm 228mm | 228mm-3M-(66 Teeth) | 1 | aliexpress.com (https://de.aliexpress.com/item/1005007574092279.html) | aliexpress.com (https://de.aliexpress.com/item/1005007574092279.html) | 3.91 CHF | 3.91 CHF | CHF 3.91
Ball Bearing 35x62x14 mm | 6007 2RS C2 ZV3 P5 GS 35x62x14 mm | 4 | Präzisions-Rillenkugellager 6007 2RS C2 ZV3 P5 GS 35x62x14 mm | kugellager-express.de (https://www.kugellager-express.de/praezisions-rillenkugellager-6007-2rs-c2-zv3-p5-gs-35x62x14-mm) | 0.74 € | 2.96 € | CHF 2.86
Ball Bearing 3x10x4 mm | 623 ZZ / 2Z 3x10x4 mm | 4 | Miniatur Kugellager 623 ZZ / 2Z 3x10x4 mm | kugellager-express.de (https://www.kugellager-express.de/miniatur-kugellager-623-zz-3x10x4-mm) | 7.33 € | 29.32 € | CHF 28.33
Big Ball Bearing |  | 2 | Received from school, estimated price 5.- |  | 5.00 CHF | 10.00 CHF | CHF 10.00
Small Ball Bearing |  | 2 | Received from school, estimated price 7.- |  | 7.00 CHF | 14.00 CHF | CHF 14.00
 |  |  |  |  |  | 0.00 CHF
 |  |  |  |  |  | 0.00 CHF
 |  |  |  |  |  | 0.00 CHF
 |  |  |  |  |  | 0.00 CHF
 |  |  |  |  |  | 0.00 CHF
 |  |  |  |  |  | 0.00 CHF
 |  |  |  |  |  | 0.00 CHF
 |  |  |  |  |  | 0.00 CHF
 |  |  |  |  |  | 0.00 CHF
 |  |  |  |  |  | 0.00 CHF
 |  |  |  |  |  | 0.00 CHF
 |  |  |  |  |  | 0.00 CHF
 |  |  |  |  |  | 0.00 CHF
 |  |  |  |  |  | 0.00 CHF
 |  |  |  |  |  | 0.00 CHF
 |  |  |  |  |  | 0.00 CHF
 |  |  |  |  |  | 0.00 CHF
 |  |  |  |  |  | 0.00 CHF
 |  |  |  |  |  | 0.00 CHF
 |  |  |  |  |  |  | CHF 222.58
