Vinomakon/6-Axis-Robotarm/Documents/Driver Carrier Shopping List 21.07.2025.xlsx

Part | Part-number | Link | Amount | Price pP | Price Total | Total Price | Total Price with VAT
100uF 50V Capacitor | EEU-FM1H101 | digikey.ch (https://www.digikey.ch/en/products/detail/panasonic-electronic-components/EEU-FM1H101/613753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) | 10 | 0.241 | 2.41 | 70.01 | 75.68081
Terminal Block 1x02 | 1984617 | digikey.ch (https://www.digikey.ch/en/products/detail/phoenix-contact/1984617/950849?s=N4IgTCBcDaIIwE4AcAWAbHA7CAugXyA) | 3 | 0.7 | 2.1
Male Pin Header 1x04 | G800W304018EU | digikey.ch (https://www.digikey.ch/en/products/detail/amphenol-cs-commercial-products/G800W304018EU/13682993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) | 10 | 0.053 | 0.53
Male Pin Header 1x02 | M20-9990245 | digikey.ch (https://www.digikey.ch/en/products/detail/harwin-inc/M20-9990245/3728225) | 5 | 0.1 | 0.5
Female Socket Header 1x08 | PPTC081LFBN-RC | digikey.ch (https://www.digikey.ch/en/products/detail/sullins-connector-solutions/PPTC081LFBN-RC/810147) | 20 | 0.352 | 7.04
Male Pin Header 1x03 | 61300311121 | digikey.ch (https://www.digikey.ch/en/products/detail/würth-elektronik/61300311121/4846825) | 10 | 0.083 | 0.83
Female Pin Header 1x22 | PPPC221LFBN-RC | digikey.ch (https://www.digikey.ch/en/products/detail/sullins-connector-solutions/PPPC221LFBN-RC/810194) | 2 | 1 | 2
Driver TMC5160 | TMC5160SILENTSTEPSTICK | digikey.ch (https://www.digikey.ch/en/products/detail/analog-devices-inc-maxim-integrated/TMC5160SILENTSTEPSTICK/9990281) | 5 | 10.38 | 51.9
Driver Heatsink | 201835 | digikey.ch (https://www.digikey.ch/en/products/detail/watterott-electronic-gmbh/201835/10071146) | 3 | 0.9 | 2.7
 |  |  |  |  | 0
 |  |  |  |  | 0
 |  |  |  |  | 0
 |  |  |  |  | 0
 |  |  |  |  | 0
 |  |  |  |  | 0
 |  |  |  |  | 0
 |  |  |  |  | 0
 |  |  |  |  | 0
 |  |  |  |  | 0
 |  |  |  |  | 0
 |  |  |  |  | 0
 |  |  |  |  | 0
 |  |  |  |  | 0
