Vinomakon/6-Axis-Robotarm/Documents/Driver Carrier Shopping List 26.02.2025.xlsx

Part | Part-number | Link | Amount | Price pP | Price Total | Total Price | Total Price with VAT
CANbus Transceiver | 5708 | digikey.ch (https://www.digikey.ch/en/products/detail/adafruit-industries-llc/5708/18716420) | 2 | 3.56 | 7.12 | 32.73 | 35.38113
100uF 50V Capacitor | EEU-FM1H101 | digikey.ch (https://www.digikey.ch/en/products/detail/panasonic-electronic-components/EEU-FM1H101/613753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) | 20 | 0.254 | 5.08
Terminal Block 1x02 | 1984617 | digikey.ch (https://www.digikey.ch/en/products/detail/phoenix-contact/1984617/950849?s=N4IgTCBcDaIIwE4AcAWAbHA7CAugXyA) | 3 | 0.56 | 1.68
Male Pin Header 1x04 | G800W304018EU | digikey.ch (https://www.digikey.ch/en/products/detail/amphenol-cs-commercial-products/G800W304018EU/13682993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) | 20 | 0.059 | 1.18
Male Pin Header 1x02 | M20-9990245 | digikey.ch (https://www.digikey.ch/en/products/detail/harwin-inc/M20-9990245/3728225) | 5 | 0.11 | 0.55
Female Socket Header 1x08 | PPTC081LFBN-RC | digikey.ch (https://www.digikey.ch/en/products/detail/sullins-connector-solutions/PPTC081LFBN-RC/810147) | 20 | 0.428 | 8.56
Male Pin Header 1x03 | 61300311121 | digikey.ch (https://www.digikey.ch/en/products/detail/würth-elektronik/61300311121/4846825) | 20 | 0.092 | 1.84
Female Pin Header 1x22 | PPPC221LFBN-RC | digikey.ch (https://www.digikey.ch/en/products/detail/sullins-connector-solutions/PPPC221LFBN-RC/810194) | 6 | 1.12 | 6.72
 |  |  |  |  | 0
 |  |  |  |  | 0
 |  |  |  |  | 0
 |  |  |  |  | 0
 |  |  |  |  | 0
 |  |  |  |  | 0
 |  |  |  |  | 0
 |  |  |  |  | 0
 |  |  |  |  | 0
 |  |  |  |  | 0
 |  |  |  |  | 0
 |  |  |  |  | 0
 |  |  |  |  | 0
 |  |  |  |  | 0
 |  |  |  |  | 0
 |  |  |  |  | 0
