Vinomakon/6-Axis-Robotarm/Documents/Shopping List 12.02.2025 .xlsx

Part | Part-number | Link | Amount | Price pP | Price pP with VAT | Price Total | Total Price | Total Price with VAT
Driver Heatsink | 201835 | digikey.com (https://www.digikey.ch/en/products/detail/watterott-electronic-gmbh/201835/10071146) | 6 | 1 | 1.081 | 6 | 30.25 | 32.70025
Driver TMC5160 | TMC5160SILENTSTEPSTICK | digikey.com (https://www.digikey.ch/en/products/detail/analog-devices-inc-maxim-integrated/TMC5160SILENTSTEPSTICK/9990281) | 2 | 11.54 | 12.47474 | 23.08
Capacitor 100uF 50V | EEU-FM1H101 | digikey.com (https://www.digikey.ch/en/products/detail/panasonic-electronic-components/EEU-FM1H101/613753) | 3 | 0.39 | 0.42159 | 1.17
Part | Link | Amount | Price (in $) | Price |  | Price Total
Stepper Motor 60Ncm | omc-stepperonline.com (https://www.omc-stepperonline.com/e-series-nema-17-bipolar-60ncm-84-97oz-in-2-1a-42x42x60mm-4-wires-w-1m-cable-connector-17he24-2104s1) | 3 | 8.97 | 8.073 |  | 35.001
Gearbox 20:1 Nema 17 | www.omc-stepperonline.com (https://www.omc-stepperonline.com/eg-series-planetary-gearbox-gear-ratio-20-1-backlash-20-arc-min-for-nema-17-stepper-motor-eg17-g20) | 1 | 29.92 | 26.928
