Vinomakon/6-Axis-Robotarm/Documents/TMC-Carrier-Board 03.02.2025 .xlsx

Part | Amount | Part-number | Price pP | Price Total | Total Price
Terminal Block 1x02 | 4 | 1984617 (https://www.digikey.ch/de/products/detail/phoenix-contact/1984617/950849?s=N4IgTCBcDaIIwE4AcAWAbHA7CAugXyA) | 0.56 | 2.24 | 29.97
Male Pin Headers 1x04 | 7 | G800W304018EU (https://www.digikey.ch/de/products/detail/amphenol-cs-commercial-products/G800W304018EU/13682993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) | 0.09 | 0.63
Male Pin Headers 2x04 | 7 | PR20204VBDN (https://www.digikey.ch/en/products/detail/metz-connect-usa-inc/PR20204VBDN/12342882) | 0.11 | 0.77
Male Pin Headers 1x02 | 3 | M20-9990245 (https://www.digikey.ch/en/products/detail/harwin-inc/M20-9990245/3728225) | 0.11 | 0.33
Female Socket Headers 1x08 | 15 | PPTC081LFBN-RC (https://www.digikey.ch/en/products/detail/sullins-connector-solutions/PPTC081LFBN-RC/810147) | 0.5 | 7.5
TMC2130 Driver | 2 | TMCSILENTSTEPSTICK SPI (https://www.digikey.ch/de/products/detail/analog-devices-inc-maxim-integrated/TMCSILENTSTEPSTICK-SPI/6572861) | 9.25 | 18.5
