Vinomakon/6-Axis-Robotarm/Solidworks/2nd Prototype/Arm2/Arm2Pulley_v1.SLDASM

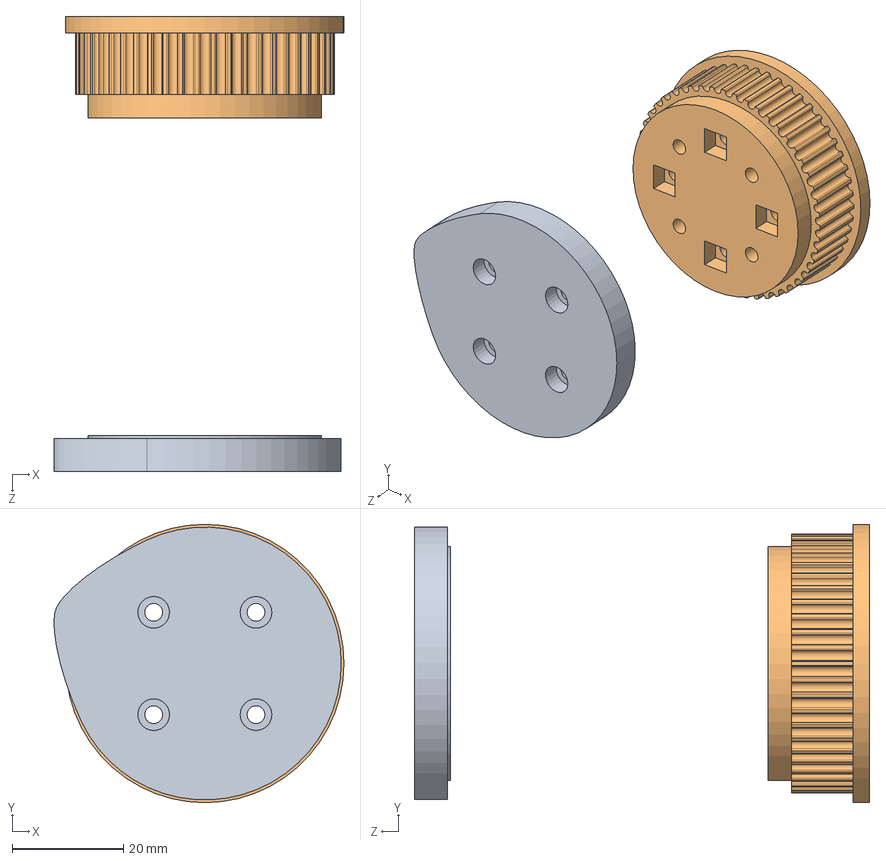
[picture p85: CAD file, 2025-10-08]
Solidworks/2nd Prototype/Arm2/Arm2Pulley_v1.SLDASM
52.1 x 50.0 x 81.8 mm
Arm2PulleyHigh_v1
Arm2PulleyLow_v1
