Vinomakon/6-Axis-Robotarm/Solidworks/2nd Prototype/Arm3/Arm3Pulley_v2.SLDASM

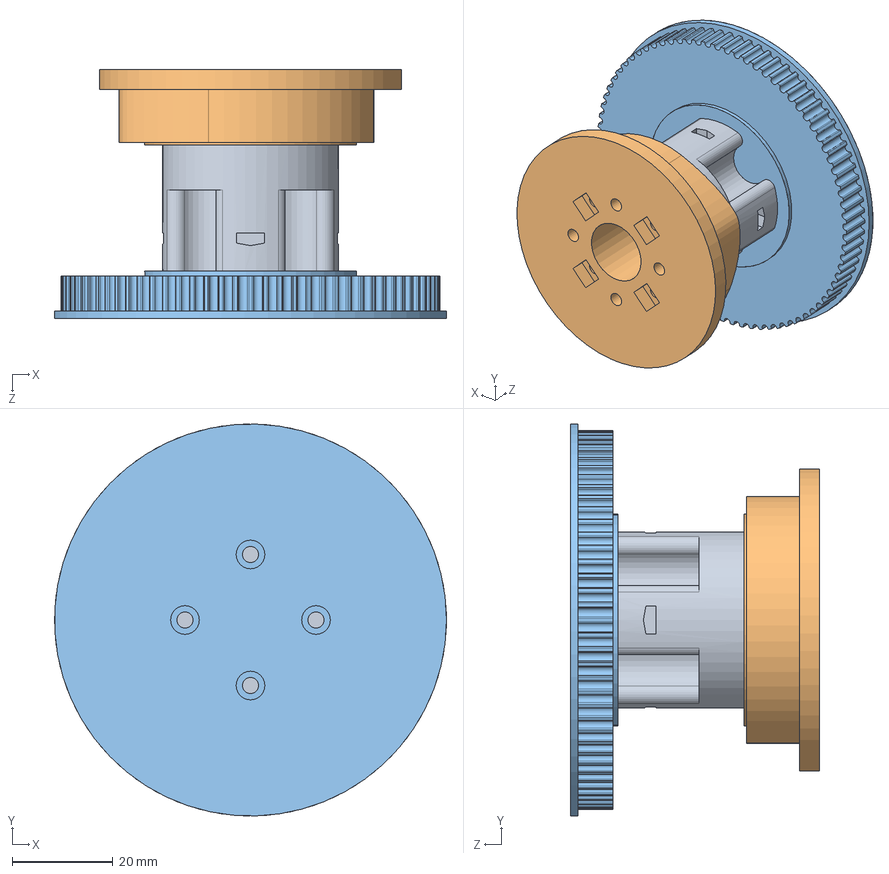
[picture p86: CAD file, 2025-10-08]
Solidworks/2nd Prototype/Arm3/Arm3Pulley_v2.SLDASM
77.8 x 77.7 x 49.5 mm
Arm3PulleyHigh_v2
Arm3PulleyLow_v2
Arm3PulleyMid_v2
