Vinomakon/6-Axis-Robotarm/Solidworks/Arm2/Arm2Pulley_v2.SLDASM

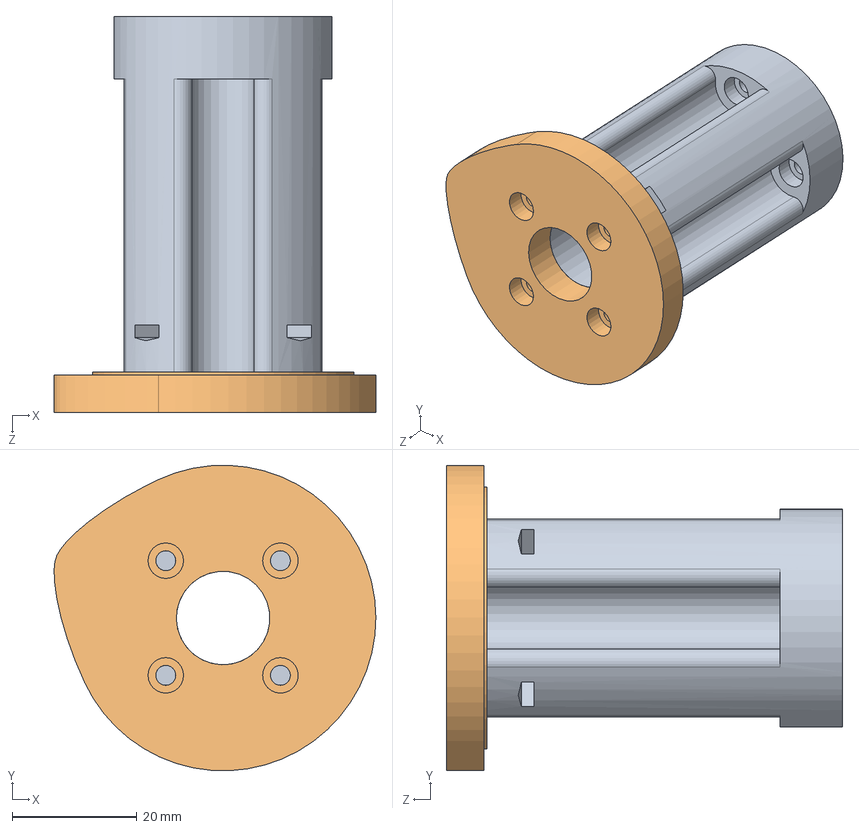
[picture p87: CAD file, 2025-10-10]
Solidworks/Arm2/Arm2Pulley_v2.SLDASM
51.6 x 49.0 x 63.5 mm
Arm2PulleyLow_v2
Arm2PulleyMid_v2
