Vinomakon/6-Axis-Robotarm/Solidworks/2nd Prototype/Arm0/Arm0_v1.SLDPRT

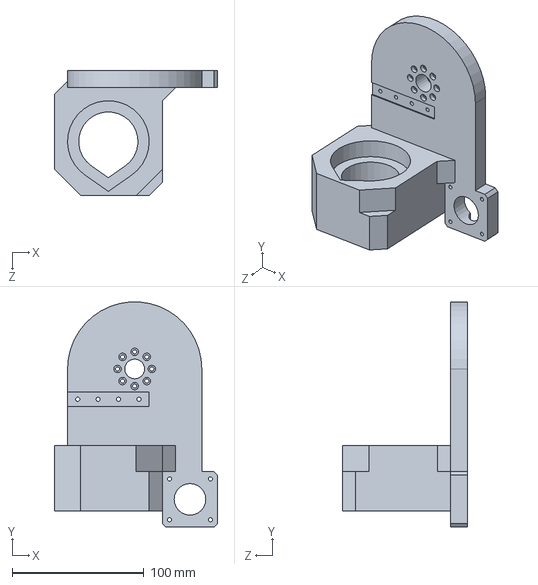
[picture p88: CAD file, 2025-07-31]
Solidworks/2nd Prototype/Arm0/Arm0_v1.SLDPRT
124.0 x 170.9 x 95.0 mm
