Vinomakon/6-Axis-Robotarm/Solidworks/2nd Prototype/Arm2/Arm2PulleyAssembly/Arm2PulleyLow_v1.SLDPRT

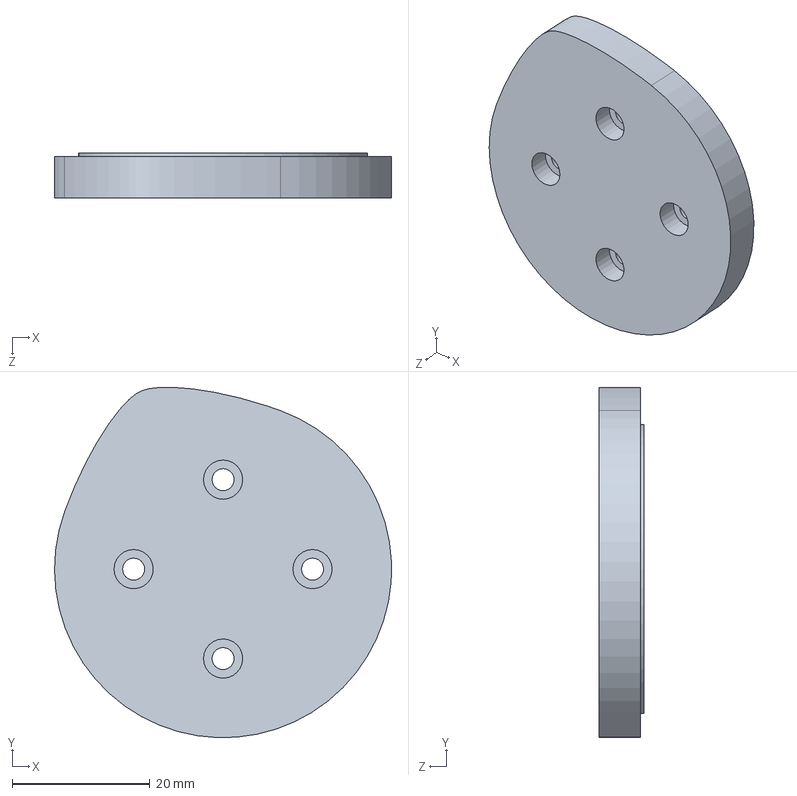
[picture p89: CAD file, 2025-07-22]
Solidworks/2nd Prototype/Arm2/Arm2PulleyAssembly/Arm2PulleyLow_v1.SLDPRT
49.0 x 50.9 x 6.50 mm
