Vinomakon/6-Axis-Robotarm/Solidworks/2nd Prototype/Arm3/Arm3Pulley_v1/Arm3PulleyMid_v2.SLDPRT

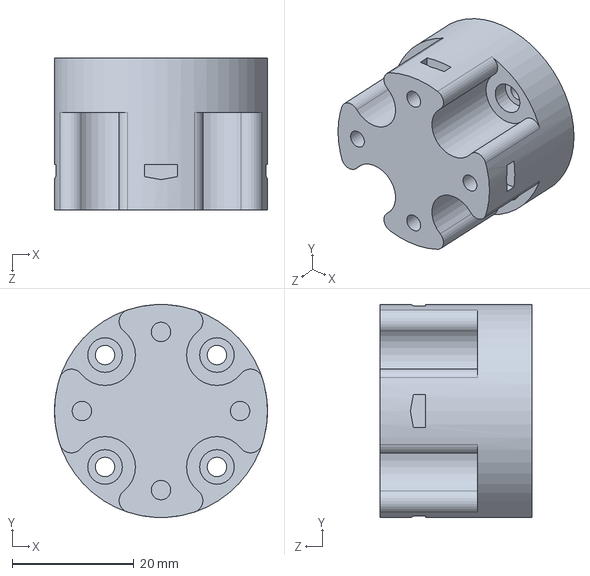
[picture p90: CAD file, 2025-07-22]
Solidworks/2nd Prototype/Arm3/Arm3Pulley_v1/Arm3PulleyMid_v2.SLDPRT
35.0 x 35.0 x 25.0 mm
