Vinomakon/6-Axis-Robotarm/Solidworks/2nd Prototype/Arm4/Arm4_v2.SLDPRT

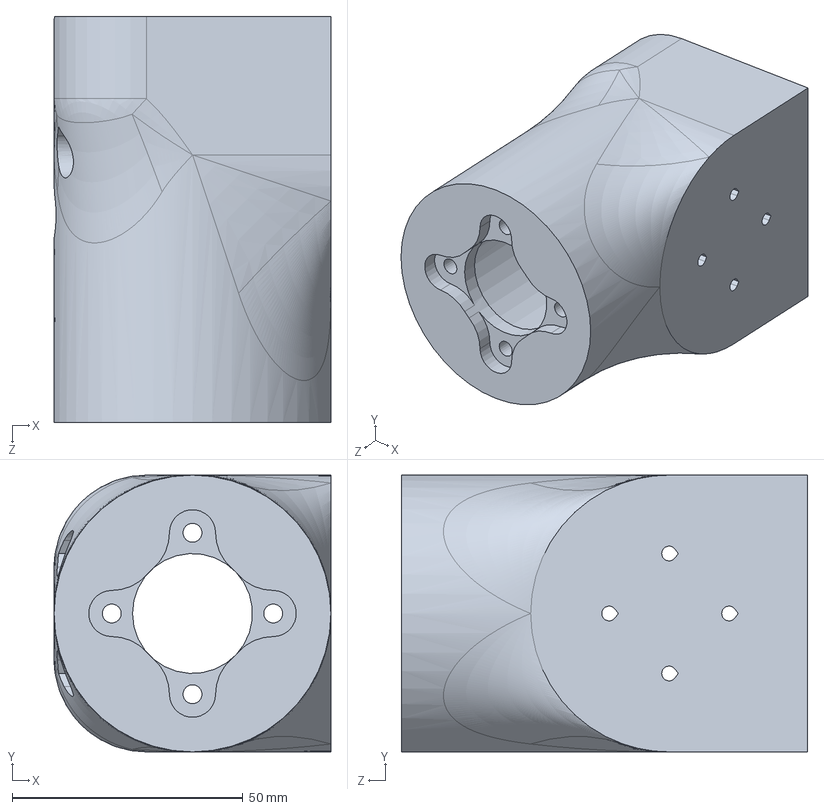
[picture p91: CAD file, 2025-07-31]
Solidworks/2nd Prototype/Arm4/Arm4_v2.SLDPRT
60.0 x 60.0 x 88.0 mm
