Vinomakon/6-Axis-Robotarm/Solidworks/2nd Prototype/General/M3_SquareNut.SLDPRT

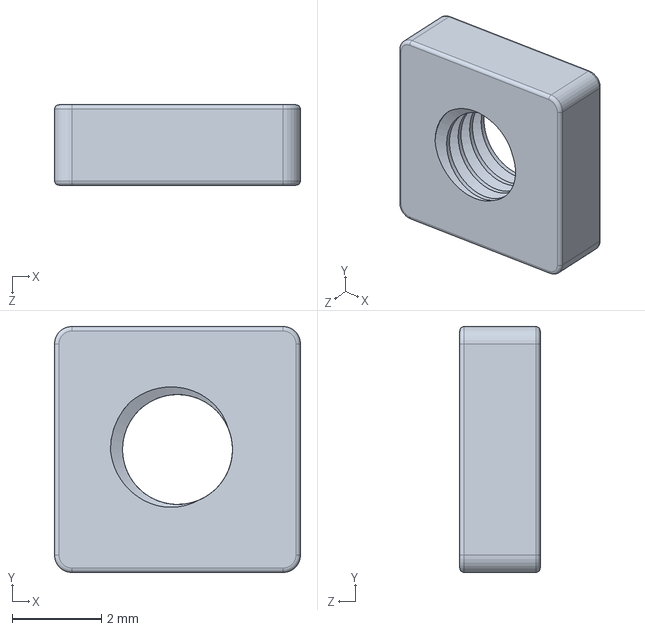
[picture p92: CAD file, 2025-07-31]
Solidworks/2nd Prototype/General/M3_SquareNut.SLDPRT
5.50 x 5.50 x 1.80 mm
