Vinomakon/6-Axis-Robotarm/Solidworks/3rd Prototype/Arm1/Arm1CableHolder_v3.SLDPRT

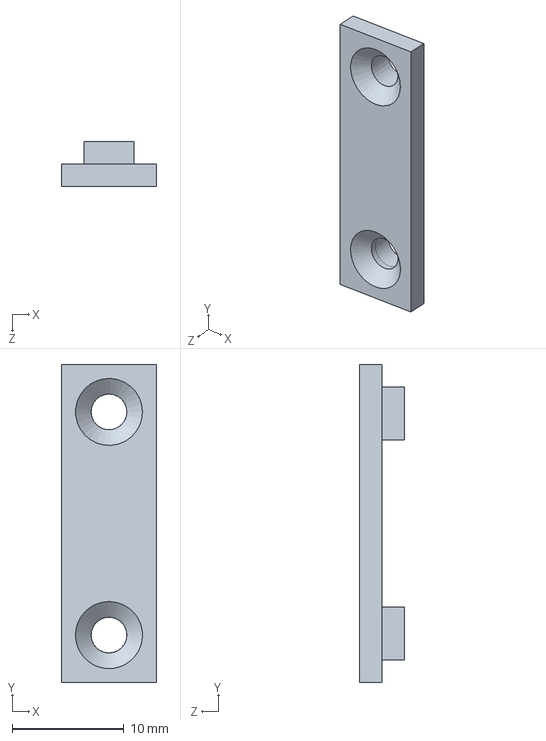
[picture p93: CAD file, 2025-08-18]
Solidworks/3rd Prototype/Arm1/Arm1CableHolder_v3.SLDPRT
8.50 x 28.5 x 4.00 mm
