Vinomakon/6-Axis-Robotarm/Solidworks/3rd Prototype/Arm2/Arm2PulleyAssembly/Arm2PulleyHigh.STEP

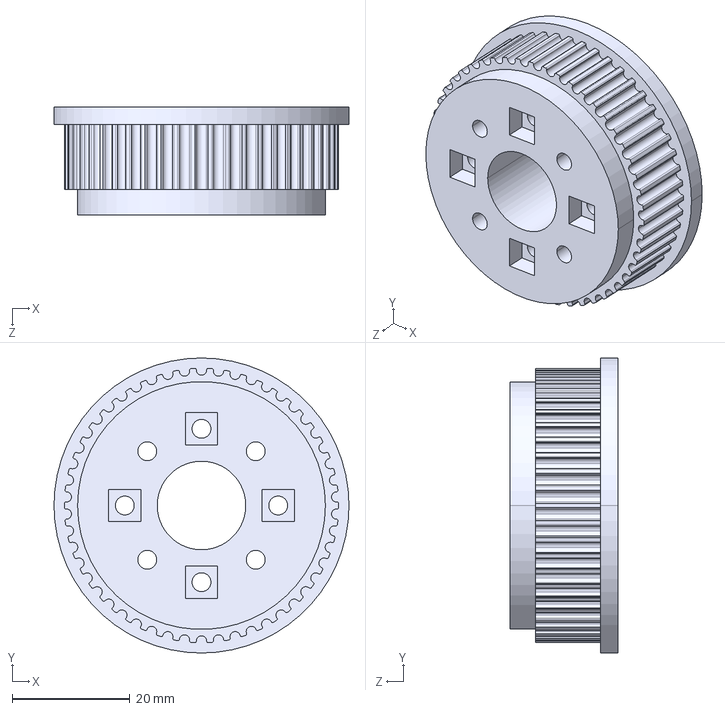
[picture p94: CAD file, 2025-09-21]
Solidworks/3rd Prototype/Arm2/Arm2PulleyAssembly/Arm2PulleyHigh.STEP
50.0 x 50.0 x 18.3 mm
