Vinomakon/6-Axis-Robotarm/Solidworks/3rd Prototype/Arm3/Arm3Pulley/Arm3PulleyHigh_v3.SLDPRT

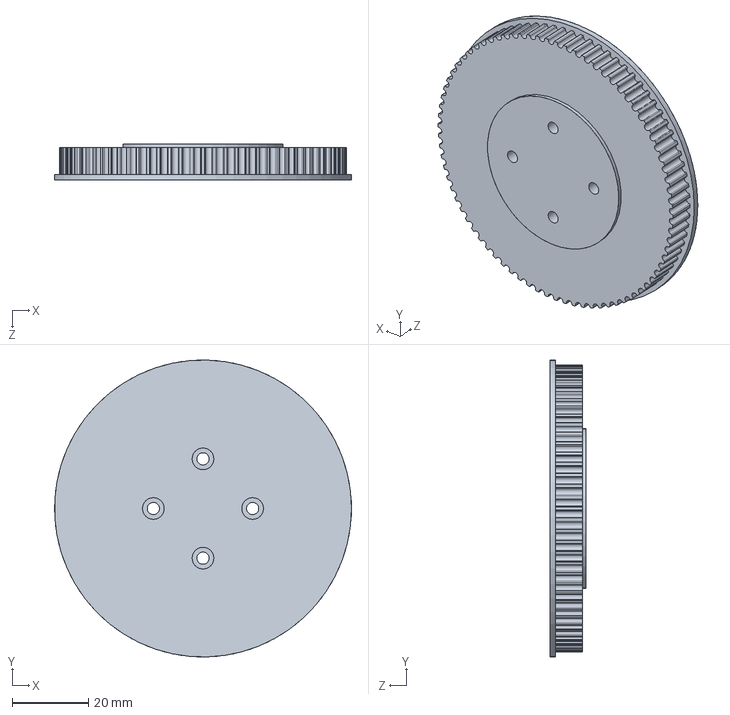
[picture p95: CAD file, 2025-07-22]
Solidworks/3rd Prototype/Arm3/Arm3Pulley/Arm3PulleyHigh_v3.SLDPRT
77.8 x 77.7 x 9.50 mm
