Vinomakon/6-Axis-Robotarm/Solidworks/Arm0/Arm0SwitchActuator_v1.SLDPRT

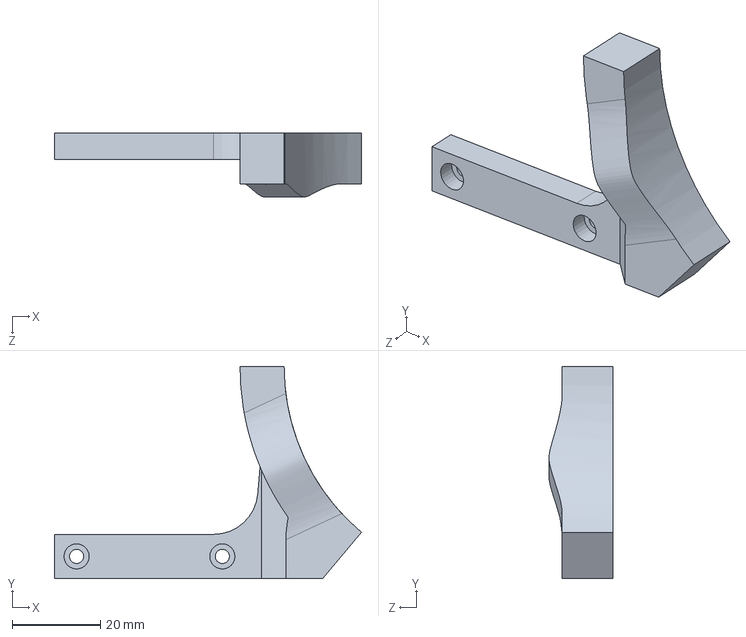
[picture p96: CAD file, 2025-10-08]
Solidworks/Arm0/Arm0SwitchActuator_v1.SLDPRT
69.5 x 48.0 x 14.5 mm
