Vinomakon/6-Axis-Robotarm/Solidworks/Arm1/Arm1_v3.SLDPRT

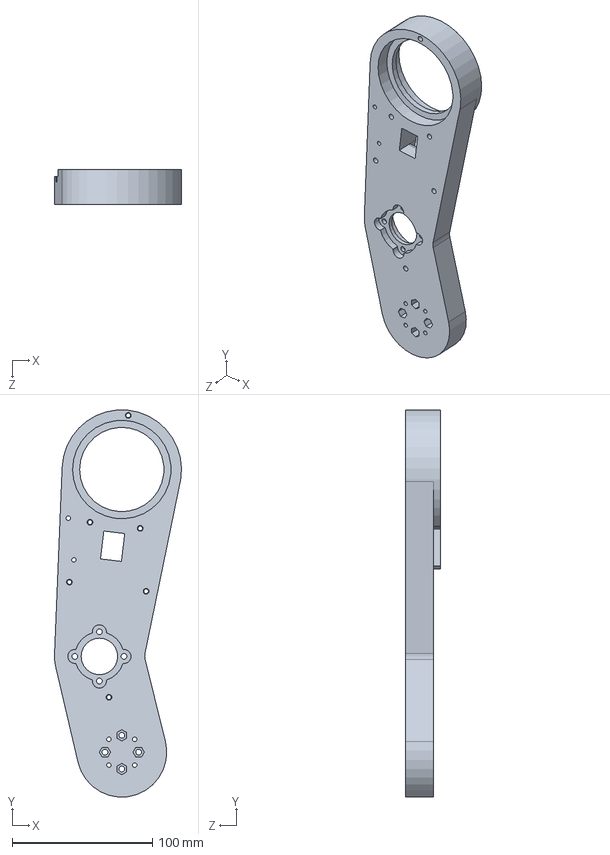
[picture p97: CAD file, 2026-01-07]
Solidworks/Arm1/Arm1_v3.SLDPRT
90.4 x 275.5 x 25.0 mm
