Vinomakon/6-Axis-Robotarm/Solidworks/Arm3/Arm3CableCrimp.SLDPRT

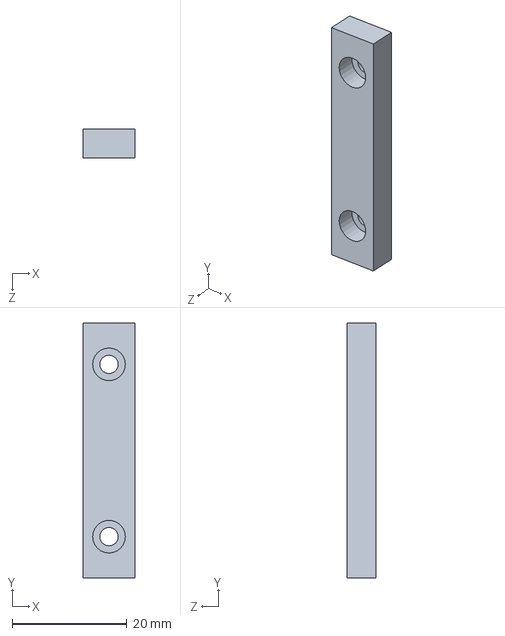
[picture p98: CAD file, 2025-10-08]
Solidworks/Arm3/Arm3CableCrimp.SLDPRT
9.00 x 44.4 x 5.00 mm
