Vinomakon/6-Axis-Robotarm/Solidworks/Arm3/Arm3Pulley_v2/Arm3PulleyMid_v2.SLDPRT

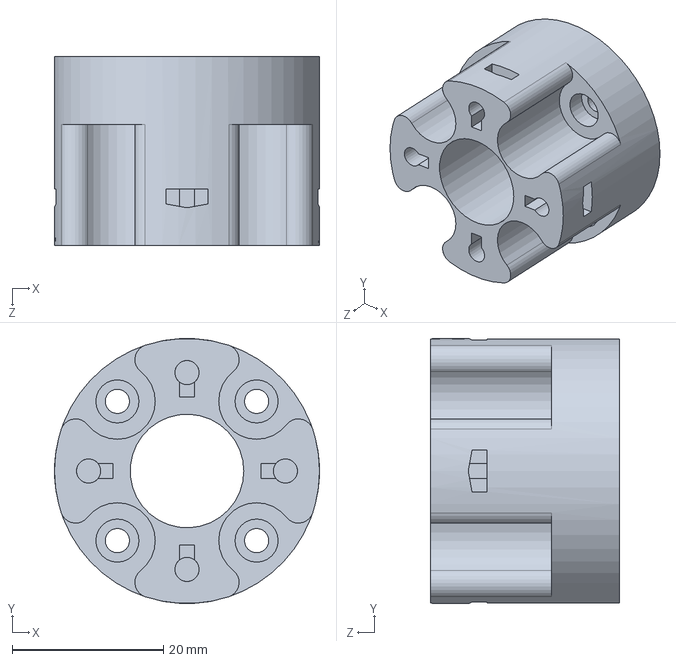
[picture p99: CAD file, 2025-10-08]
Solidworks/Arm3/Arm3Pulley_v2/Arm3PulleyMid_v2.SLDPRT
35.0 x 35.0 x 25.0 mm
