Vinomakon/6-Axis-Robotarm/Solidworks/Arm4/Arm4_v2.SLDPRT

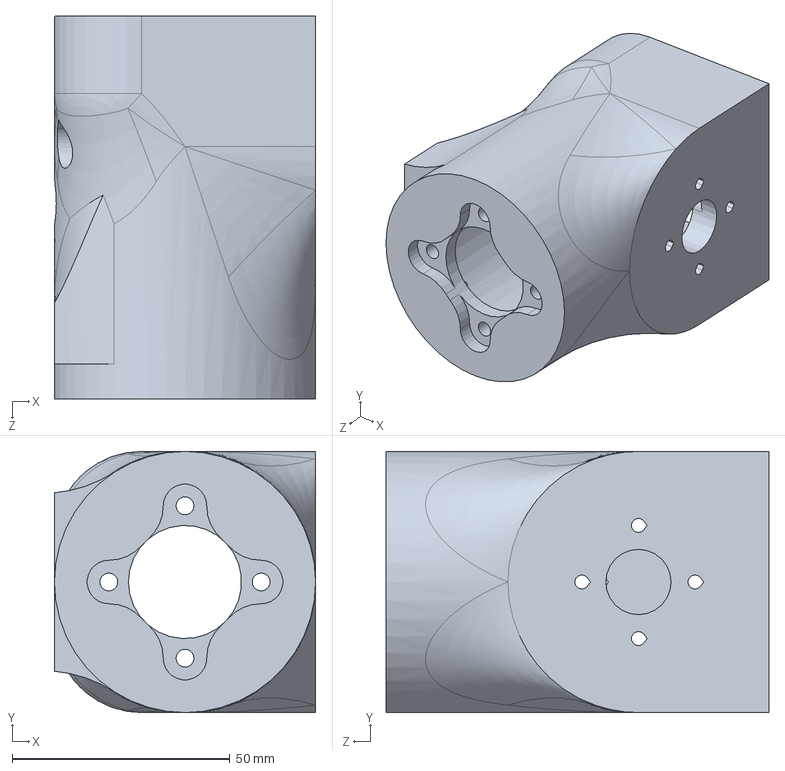
[picture p100: CAD file, 2025-10-08]
Solidworks/Arm4/Arm4_v2.SLDPRT
60.0 x 60.0 x 88.0 mm
