Vinomakon/6-Axis-Robotarm/Solidworks/Attachments/Simple Pen Holder/Cap.SLDPRT

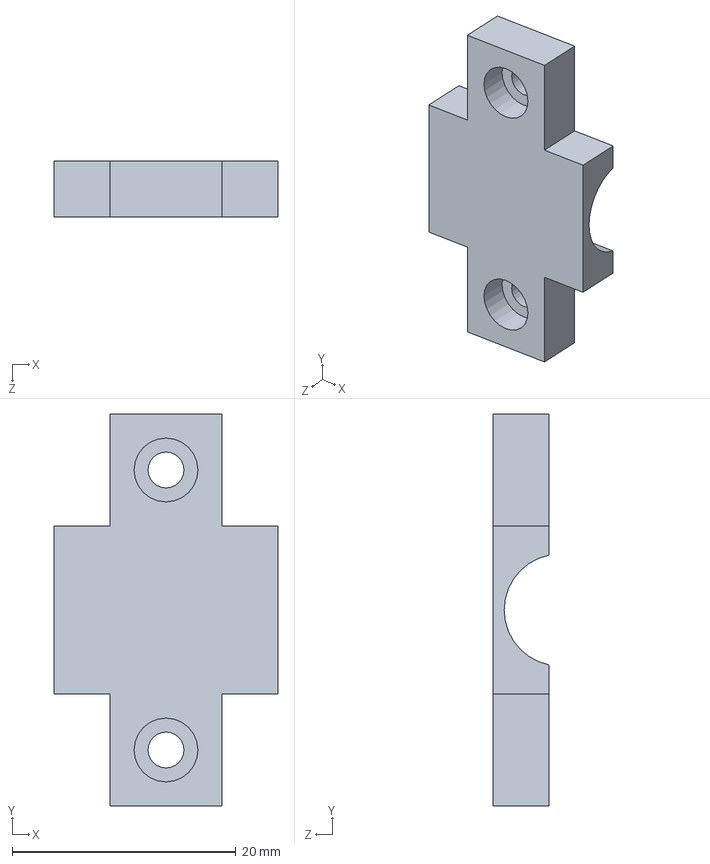
[picture p101: CAD file, 2025-10-10]
Solidworks/Attachments/Simple Pen Holder/Cap.SLDPRT
20.0 x 35.0 x 5.00 mm
