Vinomakon/6-Axis-Robotarm/Solidworks/Base/BaseSideHolder.SLDPRT

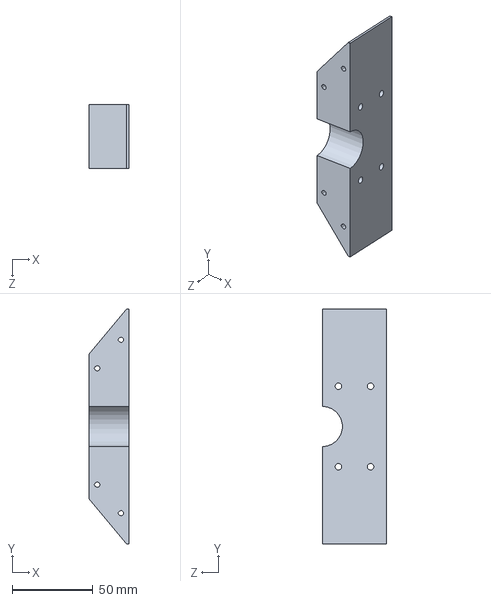
[picture p102: CAD file, 2025-10-08]
Solidworks/Base/BaseSideHolder.SLDPRT
24.8 x 146.0 x 40.0 mm
