Vinomakon/6-Axis-Robotarm/Solidworks/General/LimitSwitchHolder.SLDPRT

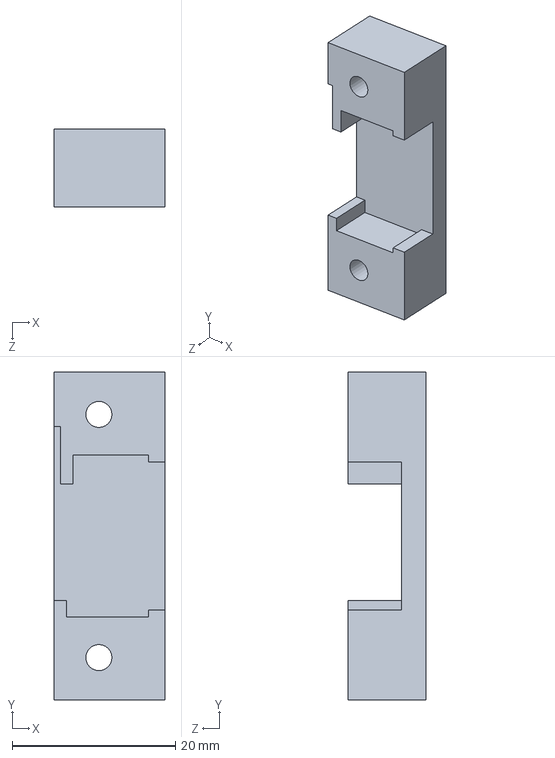
[picture p103: CAD file, 2025-10-08]
Solidworks/General/LimitSwitchHolder.SLDPRT
13.6 x 40.2 x 9.50 mm
