Vinomakon/6-Axis-Robotarm/Solidworks/PCB Holders/V3/DriverCarrierV3_PCBHolder.SLDPRT

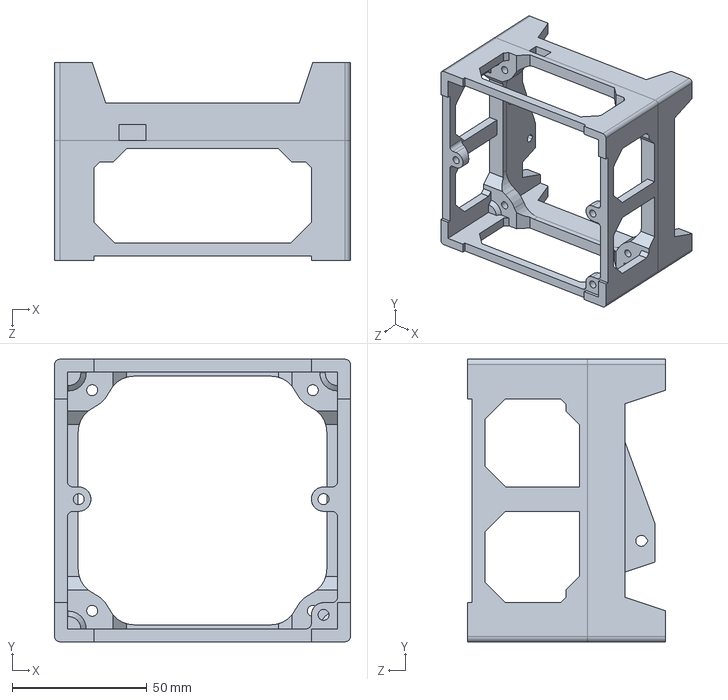
[picture p104: CAD file, 2025-12-26]
Solidworks/PCB Holders/V3/DriverCarrierV3_PCBHolder.SLDPRT
110.0 x 105.0 x 73.6 mm
