Vinomakon/6-Axis-Robotarm/Solidworks/2nd Prototype/Arm0/Arm0MotorHolder_v1.SLDPRT

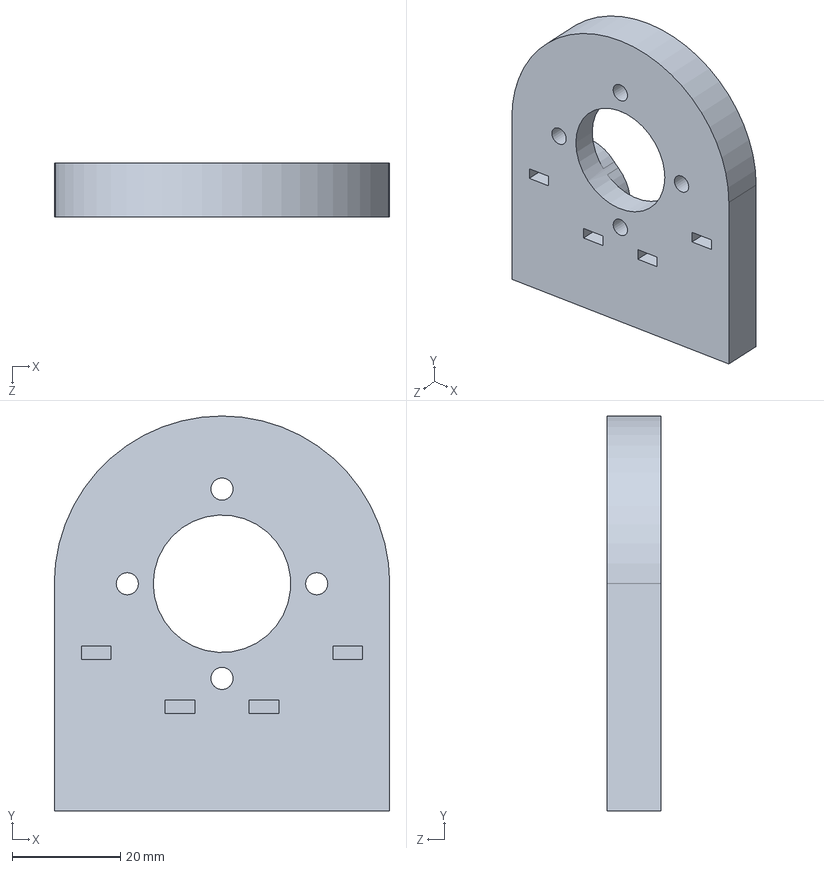
[picture p105: CAD file, 2025-07-31]
Solidworks/2nd Prototype/Arm0/Arm0MotorHolder_v1.SLDPRT
62.0 x 73.0 x 10.0 mm
