Vinomakon/6-Axis-Robotarm/Solidworks/2nd Prototype/Arm2/Arm2_v1.SLDPRT

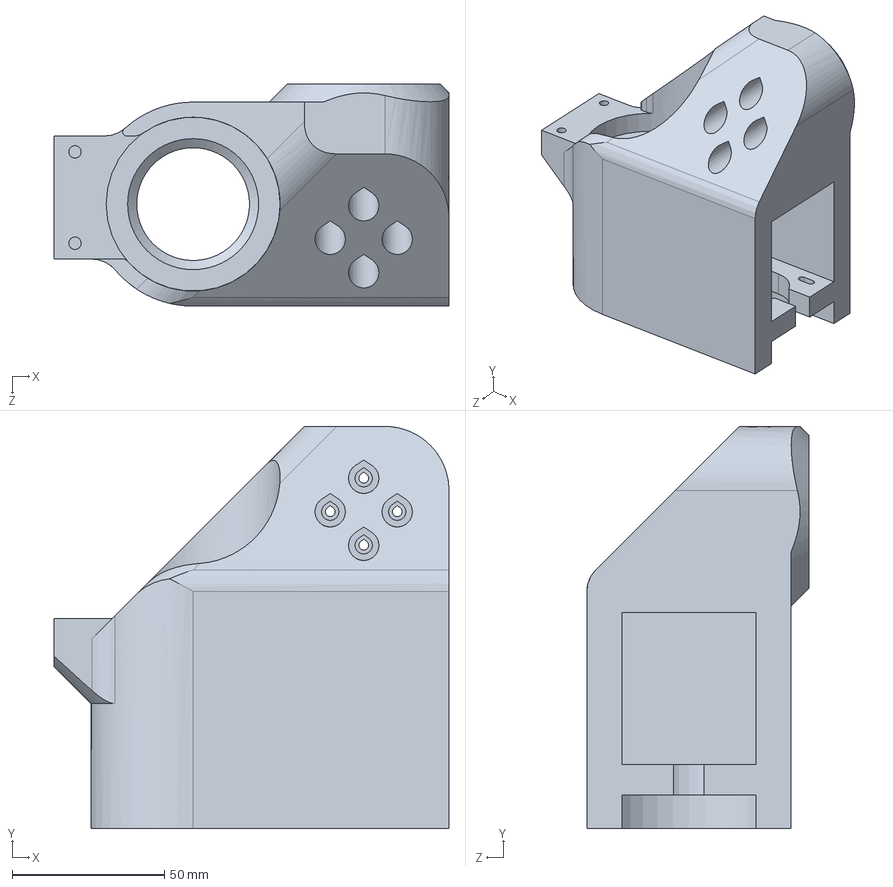
[picture p106: CAD file, 2025-07-31]
Solidworks/2nd Prototype/Arm2/Arm2_v1.SLDPRT
129.7 x 132.0 x 73.0 mm
