Vinomakon/6-Axis-Robotarm/Solidworks/2nd Prototype/Arm2/Arm2PulleyAssembly/Arm2PulleyHigh_v1.SLDPRT

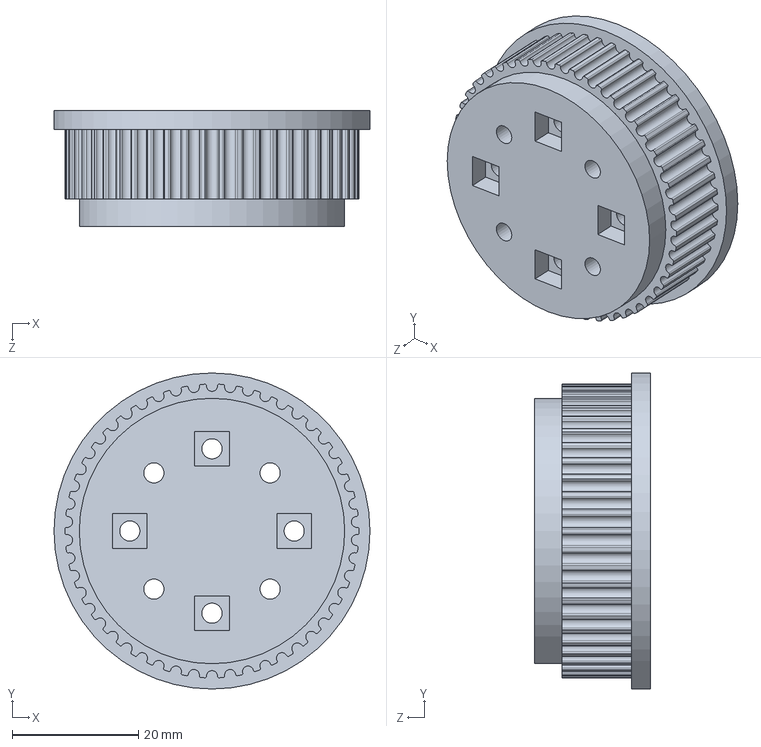
[picture p107: CAD file, 2025-07-22]
Solidworks/2nd Prototype/Arm2/Arm2PulleyAssembly/Arm2PulleyHigh_v1.SLDPRT
50.0 x 50.0 x 18.3 mm
