Vinomakon/6-Axis-Robotarm/Solidworks/2nd Prototype/Arm3/Arm3_v2.SLDPRT

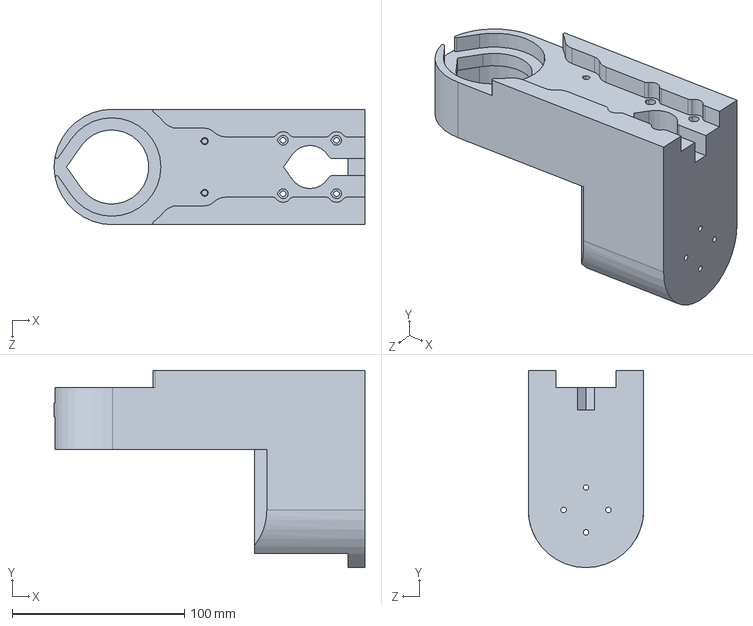
[picture p108: CAD file, 2025-07-22]
Solidworks/2nd Prototype/Arm3/Arm3_v2.SLDPRT
180.5 x 114.5 x 67.0 mm
