Vinomakon/6-Axis-Robotarm/Solidworks/2nd Prototype/General/MotorFlange_S8_D32_H24_.SLDPRT

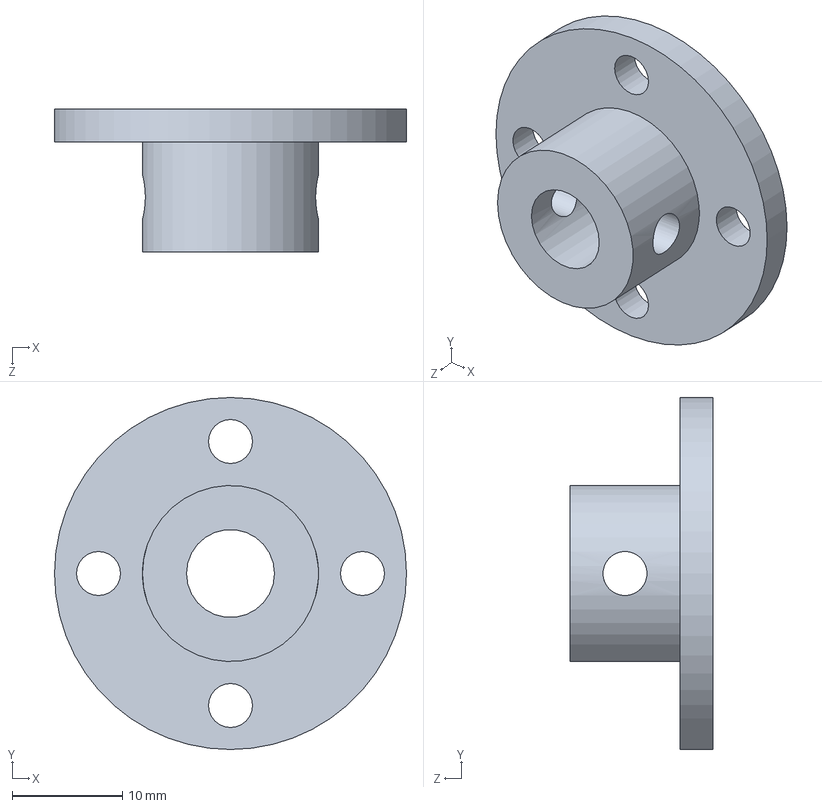
[picture p109: CAD file, 2025-07-31]
Solidworks/2nd Prototype/General/MotorFlange_S8_D32_H24_.SLDPRT
32.0 x 32.0 x 13.0 mm
