Vinomakon/6-Axis-Robotarm/Solidworks/3rd Prototype/Arm1/Arm1_v3.SLDPRT

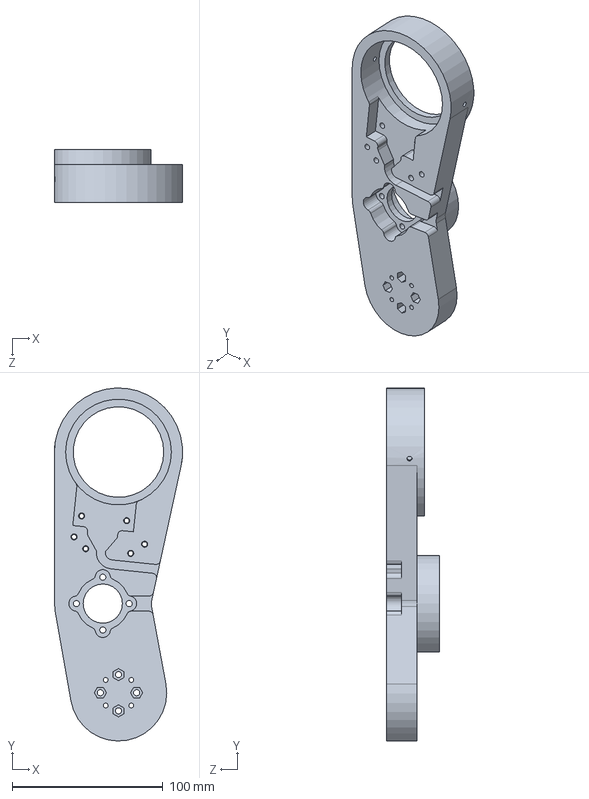
[picture p110: CAD file, 2025-07-31]
Solidworks/3rd Prototype/Arm1/Arm1_v3.SLDPRT
85.0 x 234.0 x 35.0 mm
