Vinomakon/6-Axis-Robotarm/Solidworks/3rd Prototype/Arm3/Arm3_v3.SLDPRT

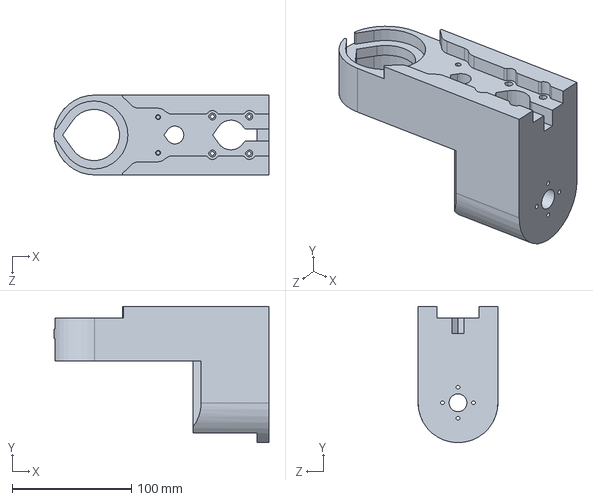
[picture p111: CAD file, 2025-08-18]
Solidworks/3rd Prototype/Arm3/Arm3_v3.SLDPRT
180.5 x 114.5 x 67.0 mm
