Vinomakon/6-Axis-Robotarm/Solidworks/3rd Prototype/General/Bearing_I35_O70_T10.SLDPRT

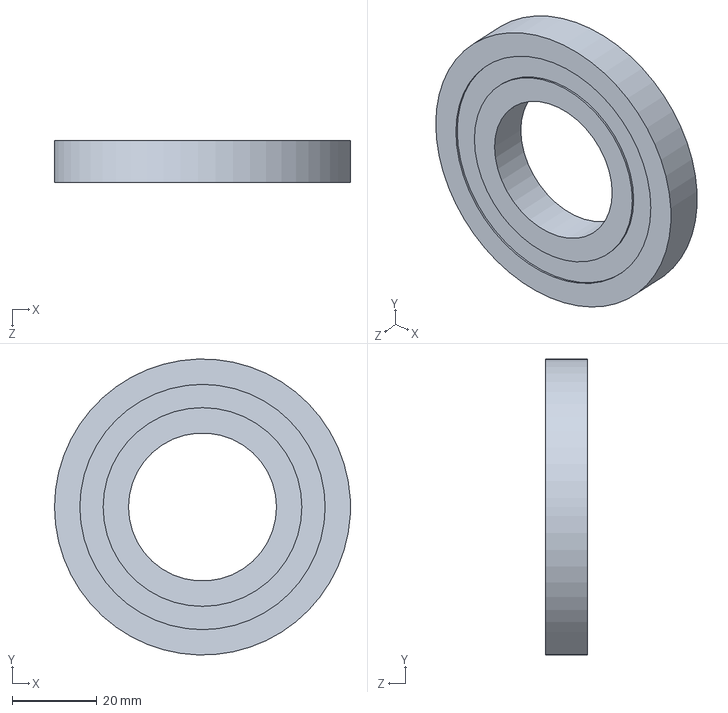
[picture p112: CAD file, 2025-07-31]
Solidworks/3rd Prototype/General/Bearing_I35_O70_T10.SLDPRT
70.0 x 70.0 x 10.0 mm
