Vinomakon/6-Axis-Robotarm/Solidworks/Arm0/Arm0_v1.SLDPRT

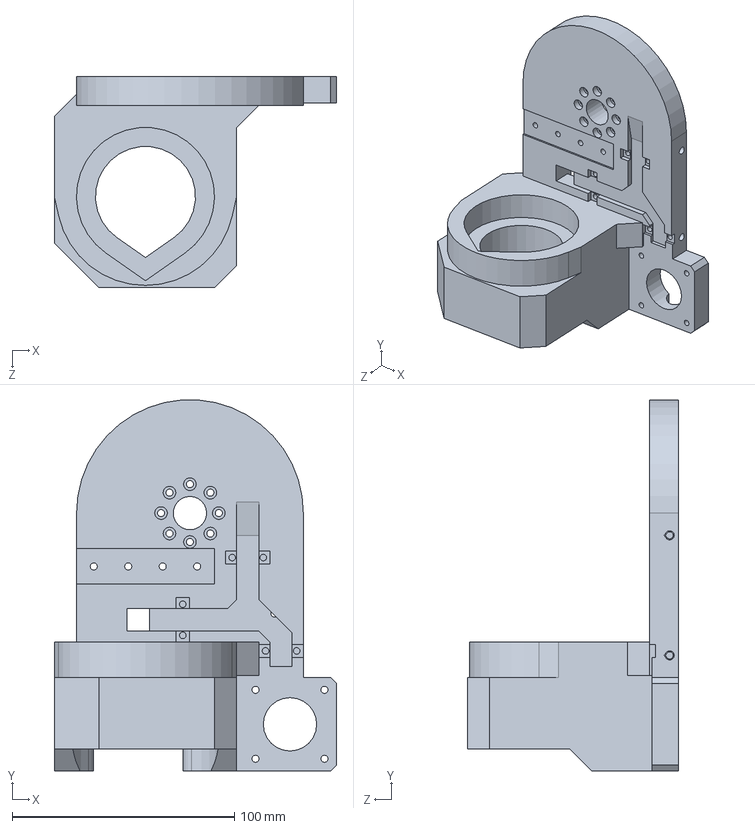
[picture p113: CAD file, 2025-10-08]
Solidworks/Arm0/Arm0_v1.SLDPRT
127.0 x 166.9 x 95.0 mm
