Vinomakon/6-Axis-Robotarm/Solidworks/Arm1/Arm1FlangeSpacer.SLDPRT

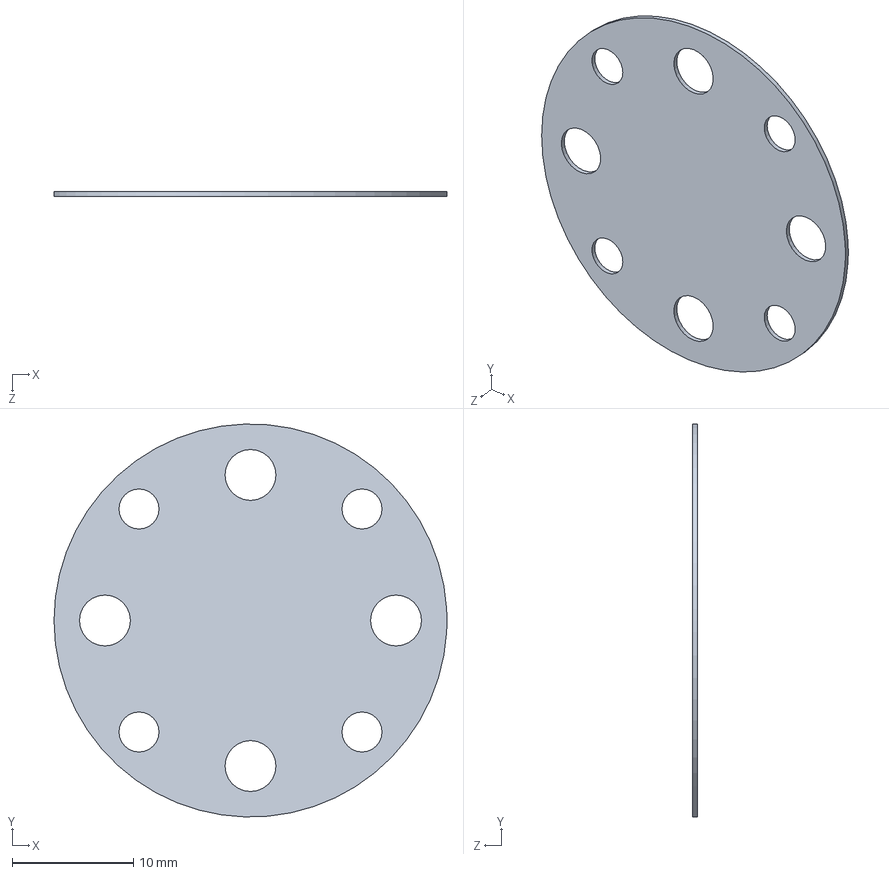
[picture p114: CAD file, 2025-10-08]
Solidworks/Arm1/Arm1FlangeSpacer.SLDPRT
32.4 x 32.4 x 0.4 mm
