Vinomakon/6-Axis-Robotarm/Solidworks/Arm2/Arm2PulleyAssembly_v2/Arm2PulleyMid_v2.SLDPRT

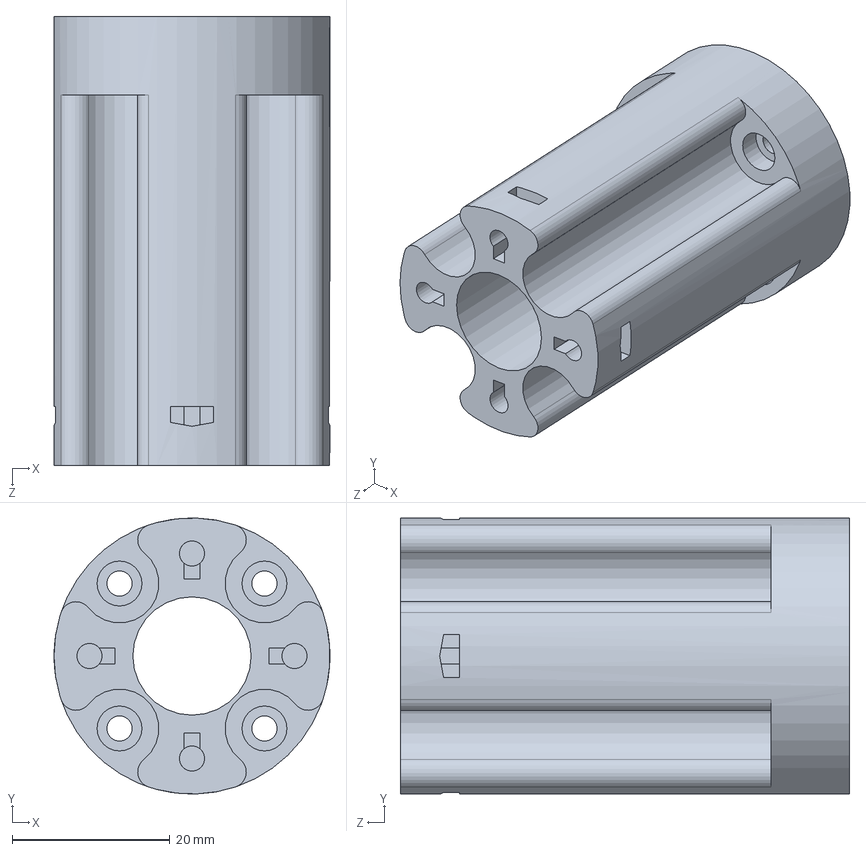
[picture p115: CAD file, 2025-10-08]
Solidworks/Arm2/Arm2PulleyAssembly_v2/Arm2PulleyMid_v2.SLDPRT
35.0 x 35.0 x 57.0 mm
