Vinomakon/6-Axis-Robotarm/Solidworks/Arm2/Arm3MotorSpacer.SLDPRT

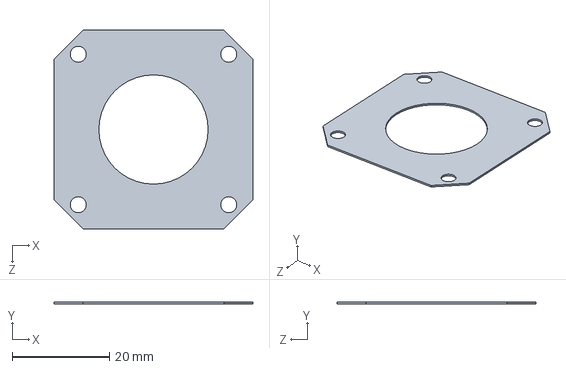
[picture p116: CAD file, 2025-10-08]
Solidworks/Arm2/Arm3MotorSpacer.SLDPRT
41.0 x 0.4 x 41.0 mm
