Vinomakon/6-Axis-Robotarm/Solidworks/Arm3/Arm3_v2.SLDPRT

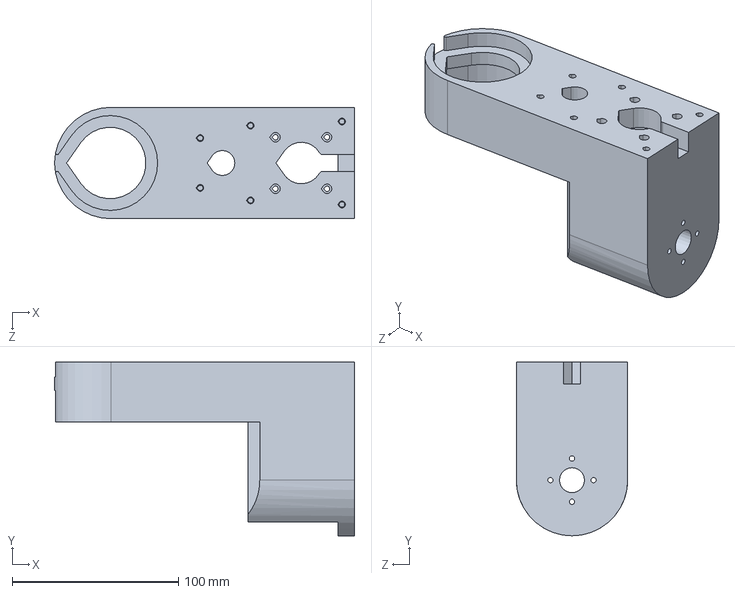
[picture p117: CAD file, 2025-10-08]
Solidworks/Arm3/Arm3_v2.SLDPRT
180.5 x 104.5 x 67.0 mm
