Vinomakon/6-Axis-Robotarm/Solidworks/Arm3/Arm3Pulley_v2/Arm3PulleyLow_v2.SLDPRT

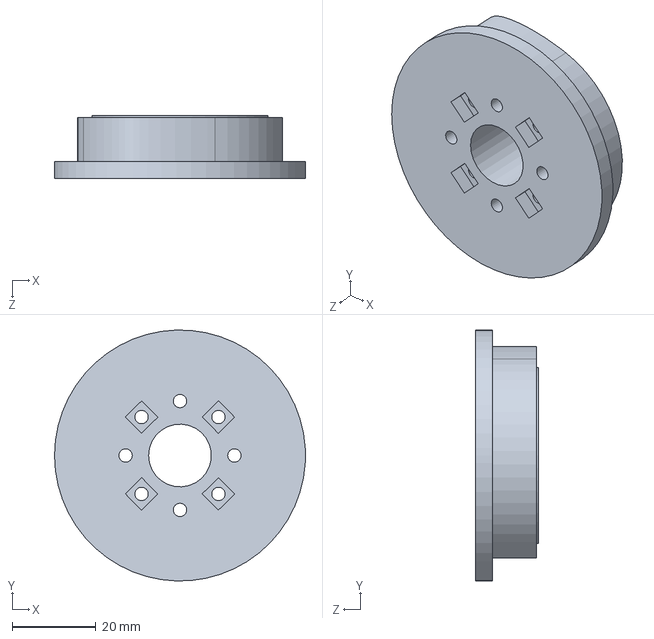
[picture p118: CAD file, 2025-10-08]
Solidworks/Arm3/Arm3Pulley_v2/Arm3PulleyLow_v2.SLDPRT
60.0 x 60.0 x 15.0 mm
