Vinomakon/6-Axis-Robotarm/Solidworks/Attachments/Simple Pen Holder/Base.SLDPRT

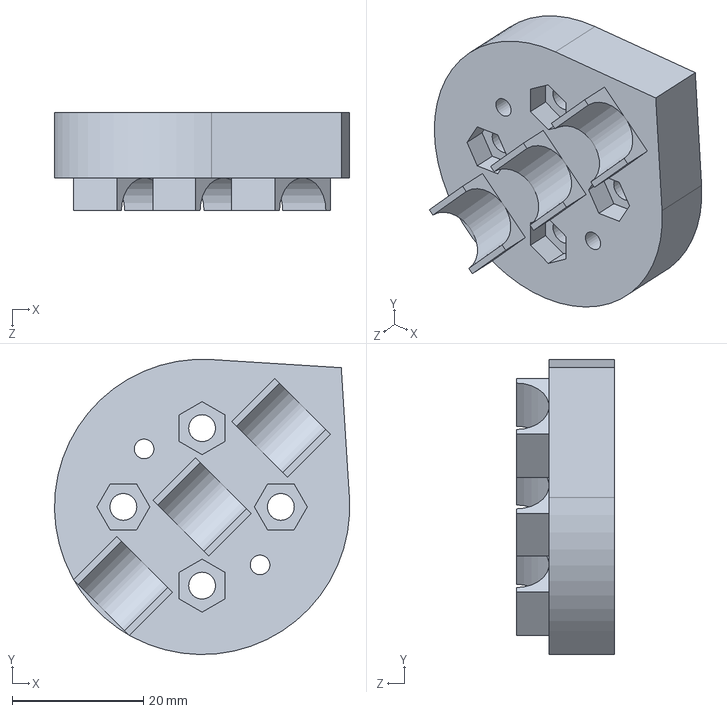
[picture p119: CAD file, 2025-10-10]
Solidworks/Attachments/Simple Pen Holder/Base.SLDPRT
45.0 x 45.0 x 15.0 mm
