Vinomakon/6-Axis-Robotarm/Solidworks/Base/BaseHolderMid_v2.SLDPRT

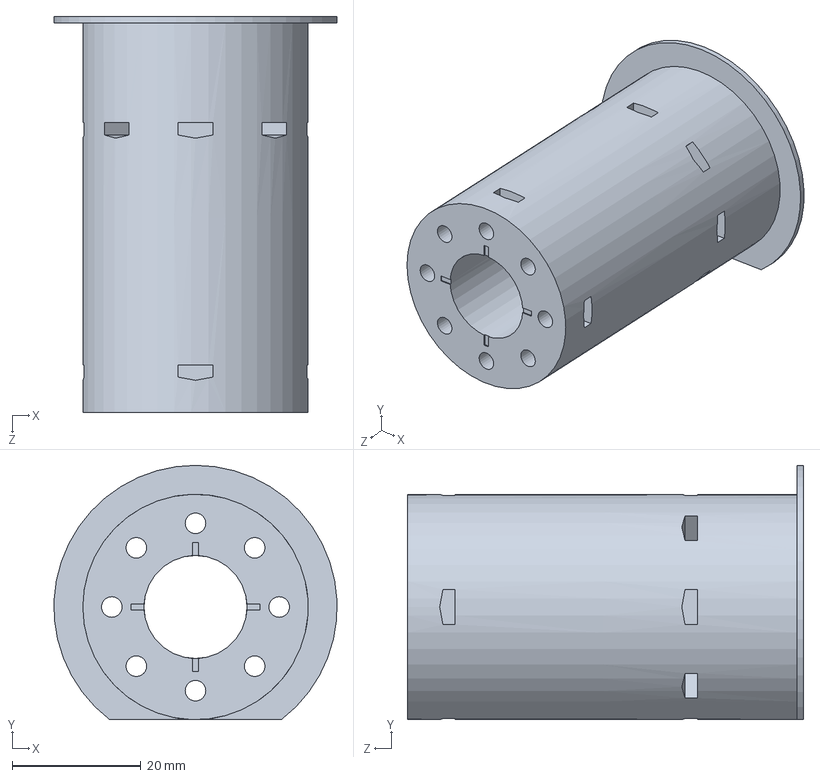
[picture p120: CAD file, 2025-10-08]
Solidworks/Base/BaseHolderMid_v2.SLDPRT
43.9 x 39.5 x 61.5 mm
