Vinomakon/6-Axis-Robotarm/Solidworks/General/HTD_3M_Pulley.SLDPRT

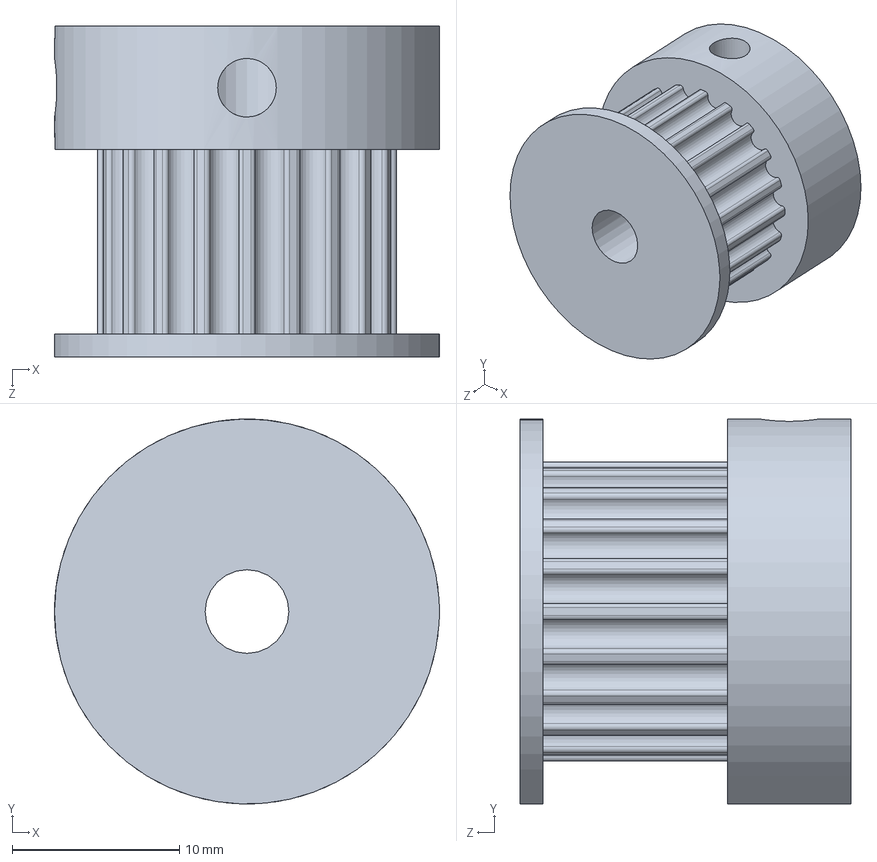
[picture p121: CAD file, 2025-10-08]
Solidworks/General/HTD_3M_Pulley.SLDPRT
23.0 x 23.0 x 19.8 mm
