Vinomakon/6-Axis-Robotarm/Solidworks/2nd Prototype/Arm2/1mmSpacer_fv1.SLDPRT

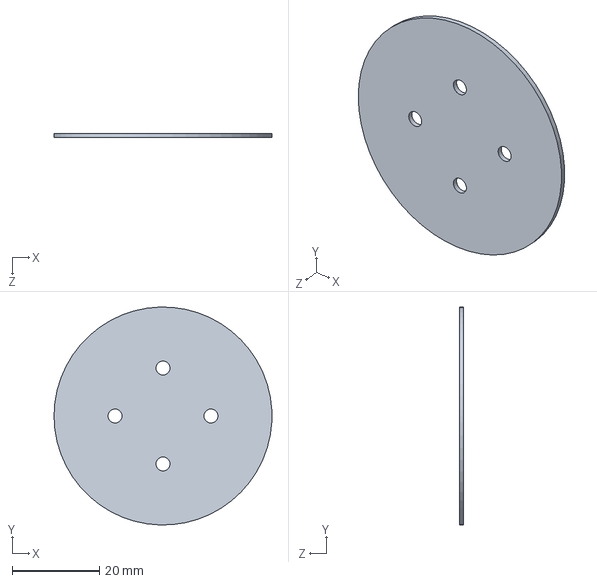
[picture p122: CAD file, 2025-07-22]
Solidworks/2nd Prototype/Arm2/1mmSpacer_fv1.SLDPRT
50.0 x 50.0 x 1.00 mm
