Vinomakon/6-Axis-Robotarm/Solidworks/2nd Prototype/Arm2/Arm2PulleyAssembly/Arm2PulleyMid_v1.SLDPRT

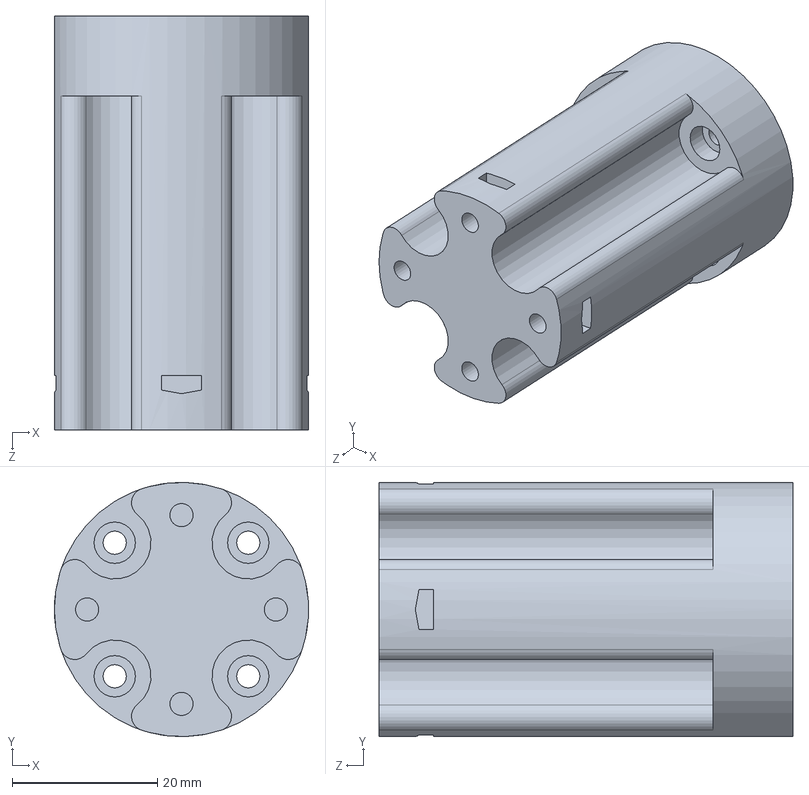
[picture p123: CAD file, 2025-07-22]
Solidworks/2nd Prototype/Arm2/Arm2PulleyAssembly/Arm2PulleyMid_v1.SLDPRT
35.0 x 35.0 x 57.0 mm
