Vinomakon/6-Axis-Robotarm/Solidworks/2nd Prototype/Arm3/Arm3Pulley_v1/Arm3PulleyLow_v2.SLDPRT

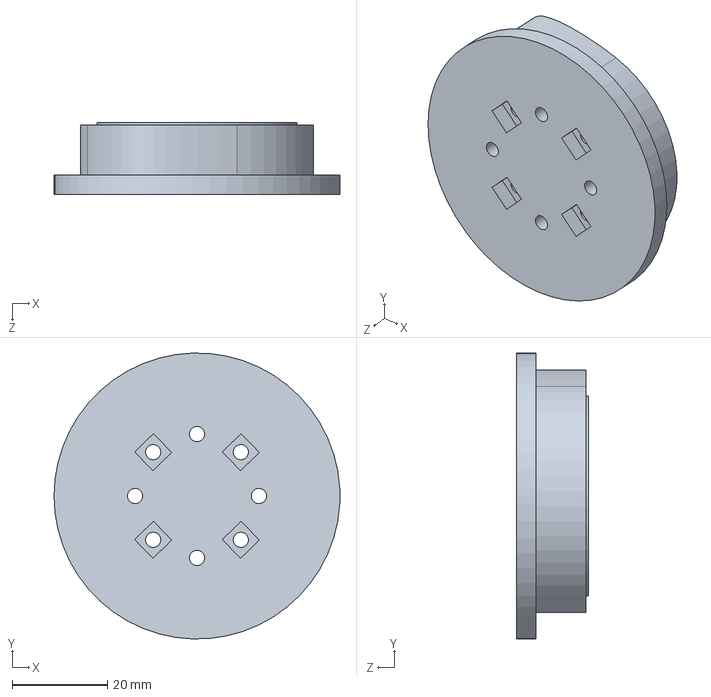
[picture p124: CAD file, 2025-07-22]
Solidworks/2nd Prototype/Arm3/Arm3Pulley_v1/Arm3PulleyLow_v2.SLDPRT
60.0 x 60.0 x 15.0 mm
