Vinomakon/6-Axis-Robotarm/Solidworks/Arm0/Arm0MotorHolder_v1.SLDPRT

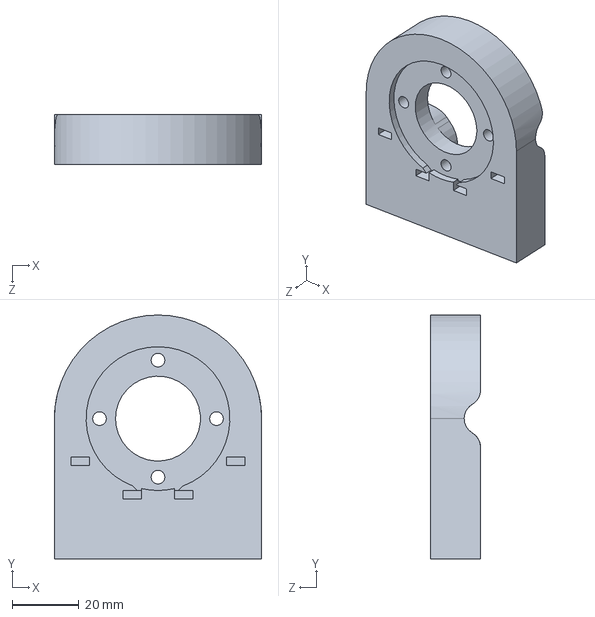
[picture p125: CAD file, 2025-10-08]
Solidworks/Arm0/Arm0MotorHolder_v1.SLDPRT
62.0 x 73.0 x 15.0 mm
