Vinomakon/6-Axis-Robotarm/Solidworks/Arm2/Arm2_v2.SLDPRT

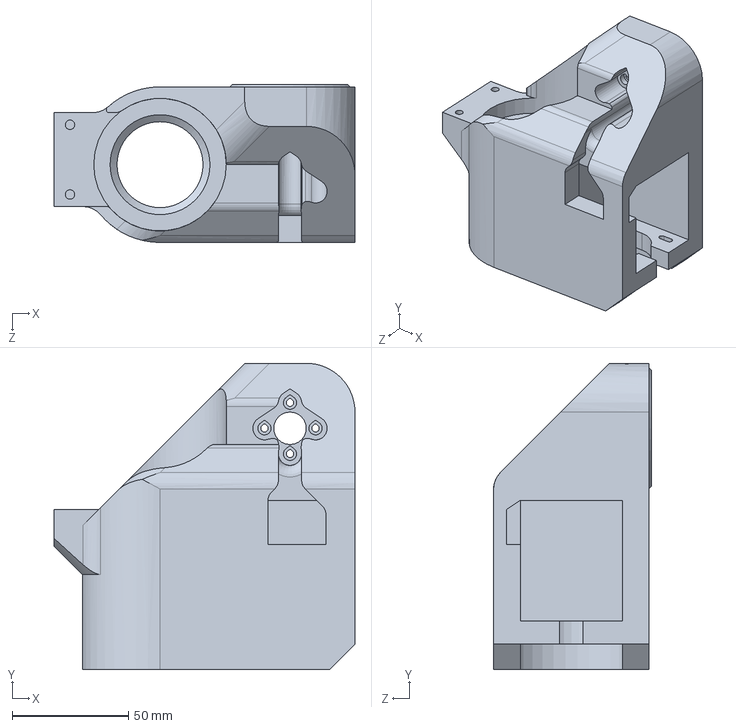
[picture p126: CAD file, 2025-10-08]
Solidworks/Arm2/Arm2_v2.SLDPRT
129.7 x 132.0 x 68.0 mm
