Vinomakon/6-Axis-Robotarm/Solidworks/Base/Base_v2.SLDPRT

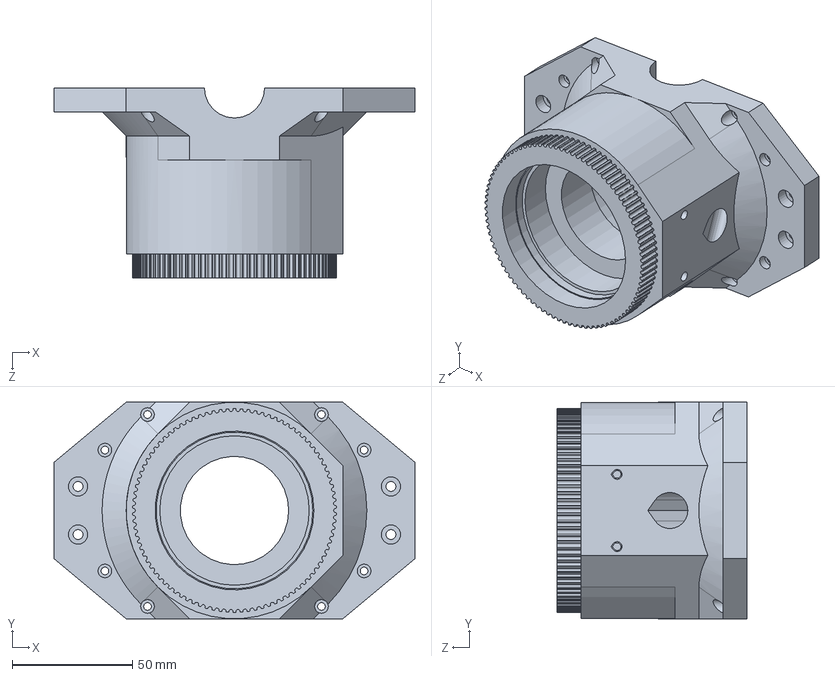
[picture p127: CAD file, 2025-10-08]
Solidworks/Base/Base_v2.SLDPRT
150.0 x 90.0 x 79.0 mm
