Vinomakon/6-Axis-Robotarm/Solidworks/General/AluminiumExtrusion.SLDPRT

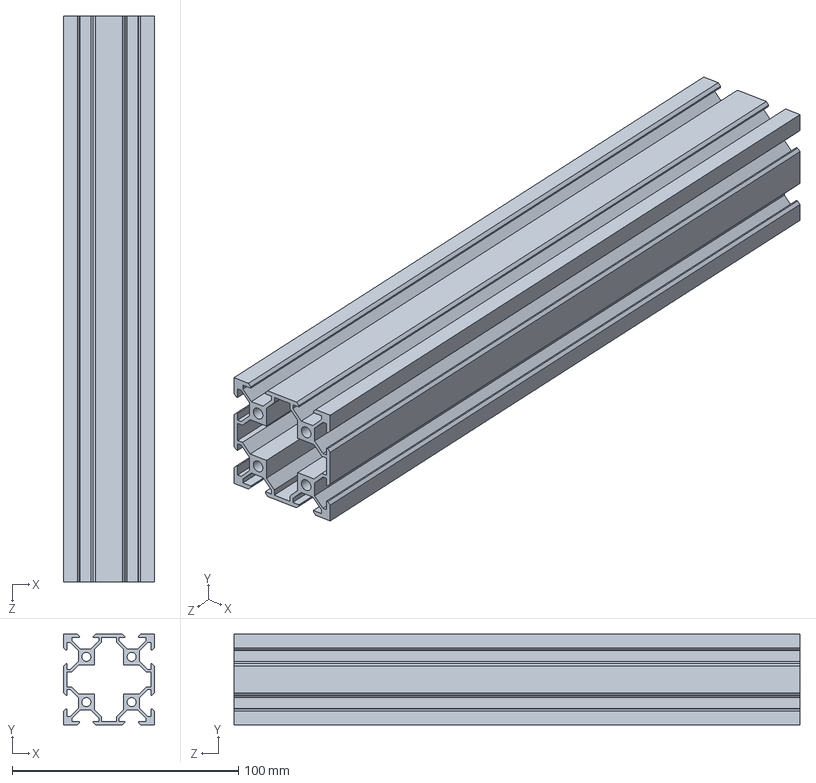
[picture p128: CAD file, 2025-09-03]
Solidworks/General/AluminiumExtrusion.SLDPRT
40.0 x 40.0 x 250.0 mm
