Vinomakon/6-Axis-Robotarm/Solidworks/3rd Prototype/General/Bearing_I35_O62_T14.SLDPRT

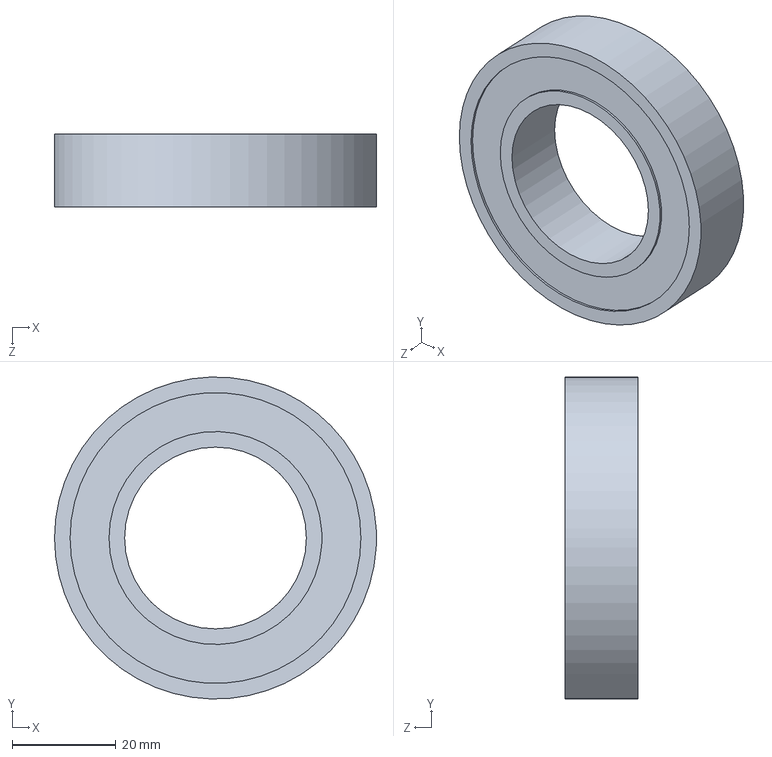
[picture p129: CAD file, 2025-07-31]
Solidworks/3rd Prototype/General/Bearing_I35_O62_T14.SLDPRT
62.0 x 62.0 x 14.0 mm
