Vinomakon/6-Axis-Robotarm/Solidworks/Arm0/Arm0HolderHigh_v1.SLDPRT

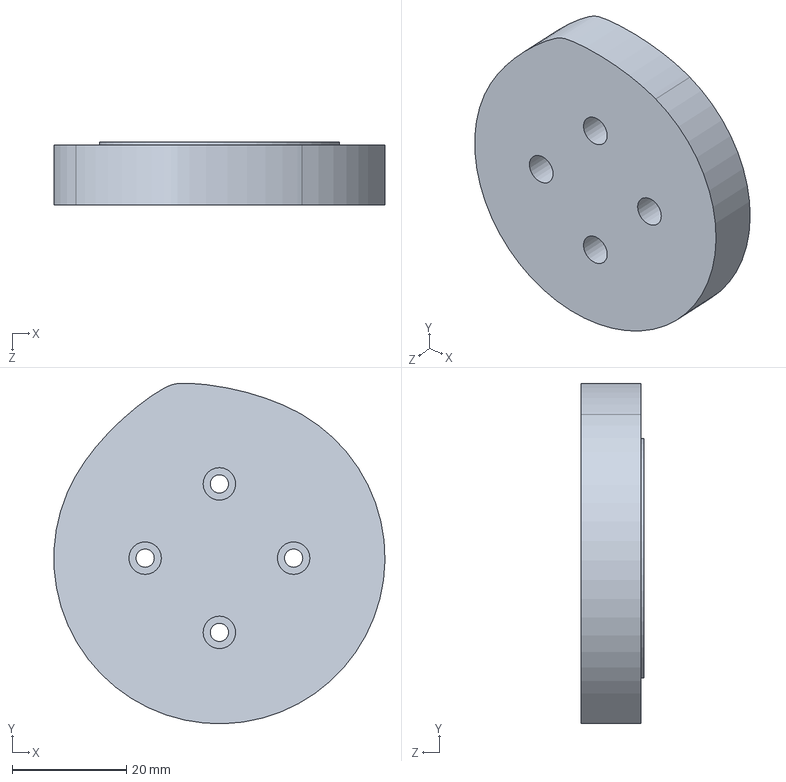
[picture p130: CAD file, 2025-10-08]
Solidworks/Arm0/Arm0HolderHigh_v1.SLDPRT
58.0 x 59.6 x 11.0 mm
