Vinomakon/6-Axis-Robotarm/Solidworks/2nd Prototype/General/17HS10-0704S.SLDPRT

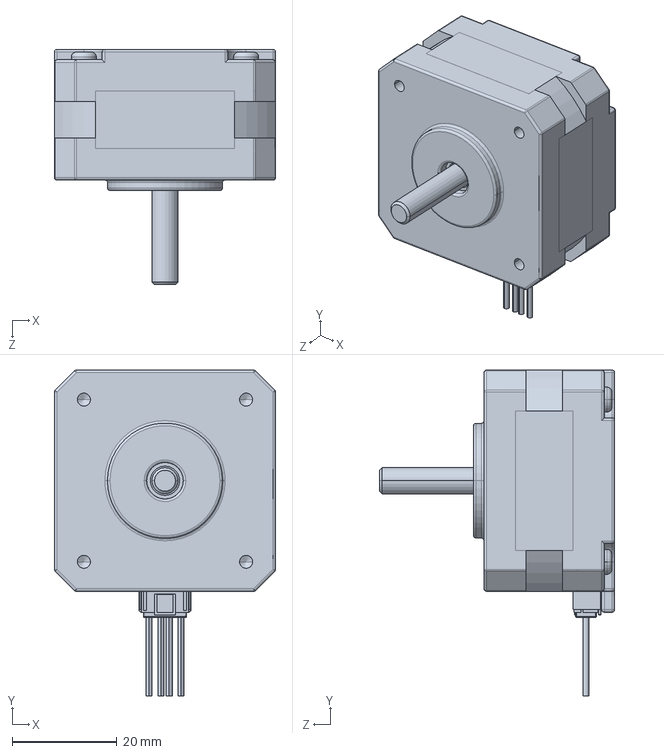
[picture p131: CAD file, 2025-07-31]
Solidworks/2nd Prototype/General/17HS10-0704S.SLDPRT
42.3 x 62.3 x 45.0 mm
