Vinomakon/6-Axis-Robotarm/Solidworks/3rd Prototype/General/17HE19-2004S.SLDPRT

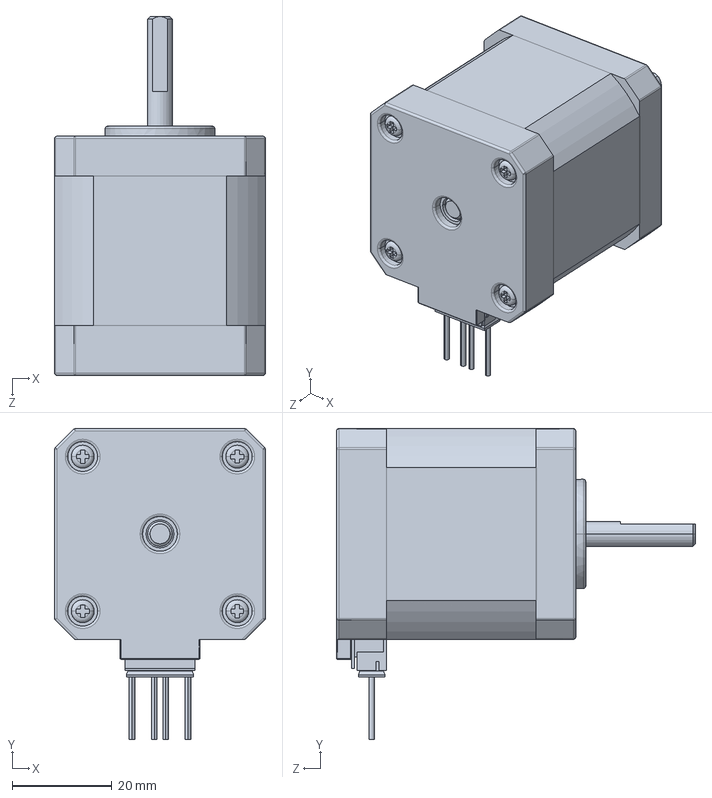
[picture p132: CAD file, 2025-07-31]
Solidworks/3rd Prototype/General/17HE19-2004S.SLDPRT
42.3 x 62.4 x 72.0 mm
