Vinomakon/6-Axis-Robotarm/Solidworks/Arm0/Arm0CableCrimp.SLDPRT

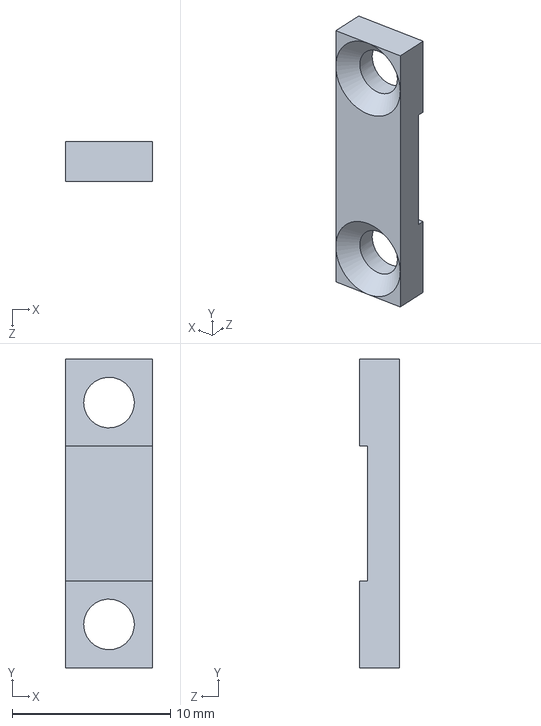
[picture p133: CAD file, 2025-10-08]
Solidworks/Arm0/Arm0CableCrimp.SLDPRT
5.50 x 19.5 x 2.50 mm
