Vinomakon/6-Axis-Robotarm/Solidworks/Arm0/Arm0HolderMid_v1.SLDPRT

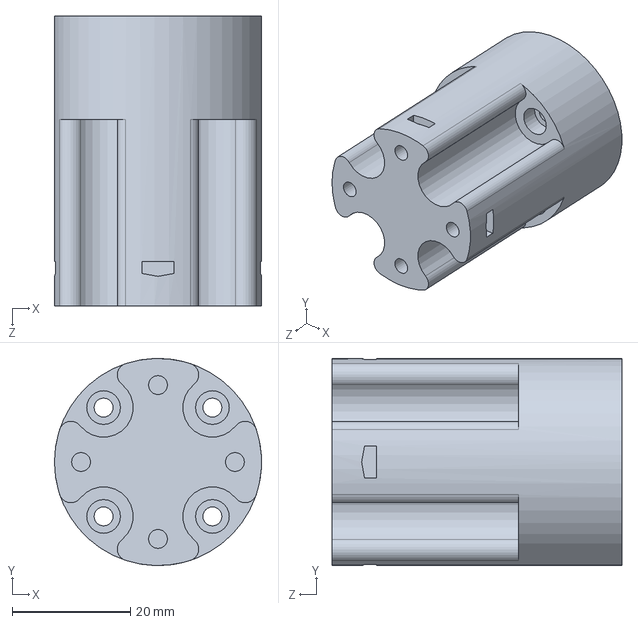
[picture p134: CAD file, 2025-08-08]
Solidworks/Arm0/Arm0HolderMid_v1.SLDPRT
35.0 x 35.0 x 49.0 mm
