Vinomakon/6-Axis-Robotarm/Solidworks/Arm1/Arm1MotorSpacer.SLDPRT

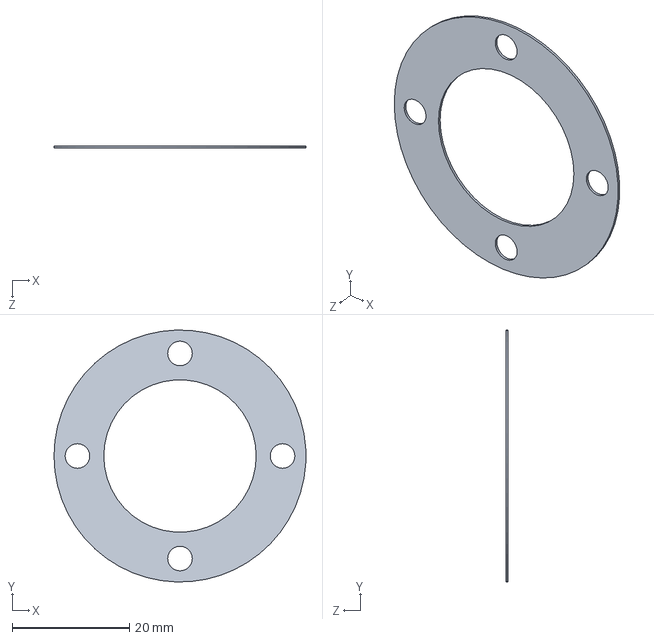
[picture p135: CAD file, 2025-10-08]
Solidworks/Arm1/Arm1MotorSpacer.SLDPRT
43.0 x 43.0 x 0.4 mm
