Vinomakon/6-Axis-Robotarm/Solidworks/Base/BaseHolderCap_v1.SLDPRT

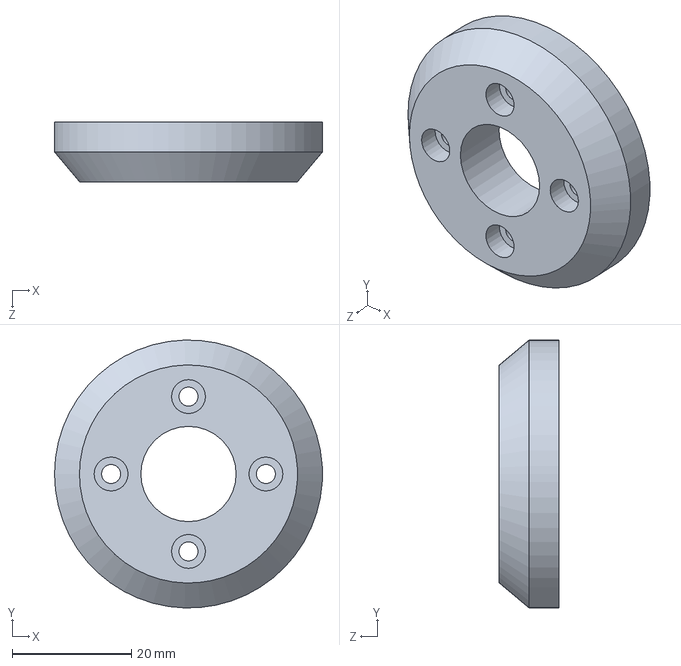
[picture p136: CAD file, 2025-08-08]
Solidworks/Base/BaseHolderCap_v1.SLDPRT
45.0 x 45.0 x 10.0 mm
