Vinomakon/6-Axis-Robotarm/Solidworks/Arm1/Arm1Pulley2_v3.SLDPRT

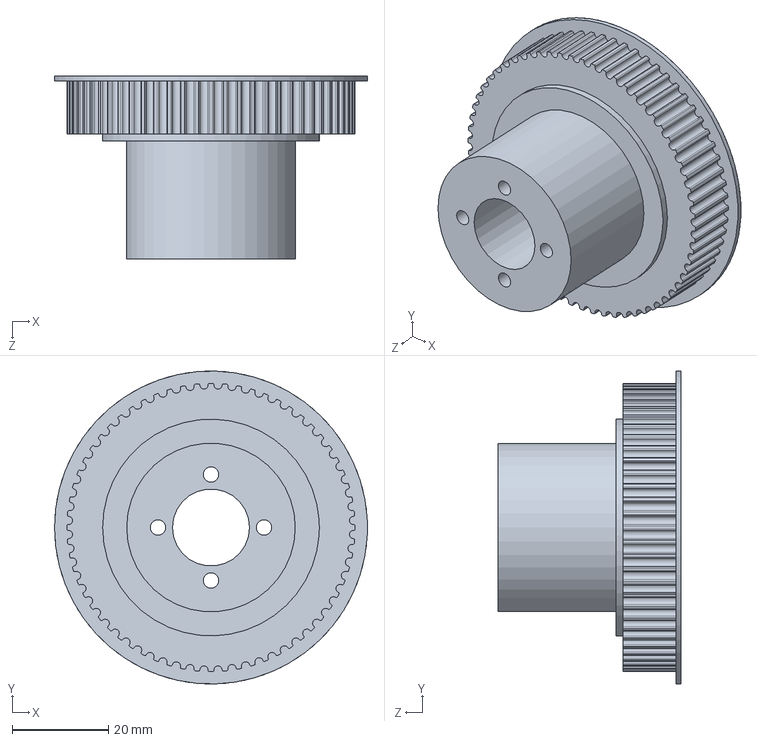
[picture p137: CAD file, 2025-10-08]
Solidworks/Arm1/Arm1Pulley2_v3.SLDPRT
65.0 x 65.0 x 38.0 mm
