Vinomakon/6-Axis-Robotarm/Solidworks/Arm1/Arm1Pulley1_v2.SLDPRT

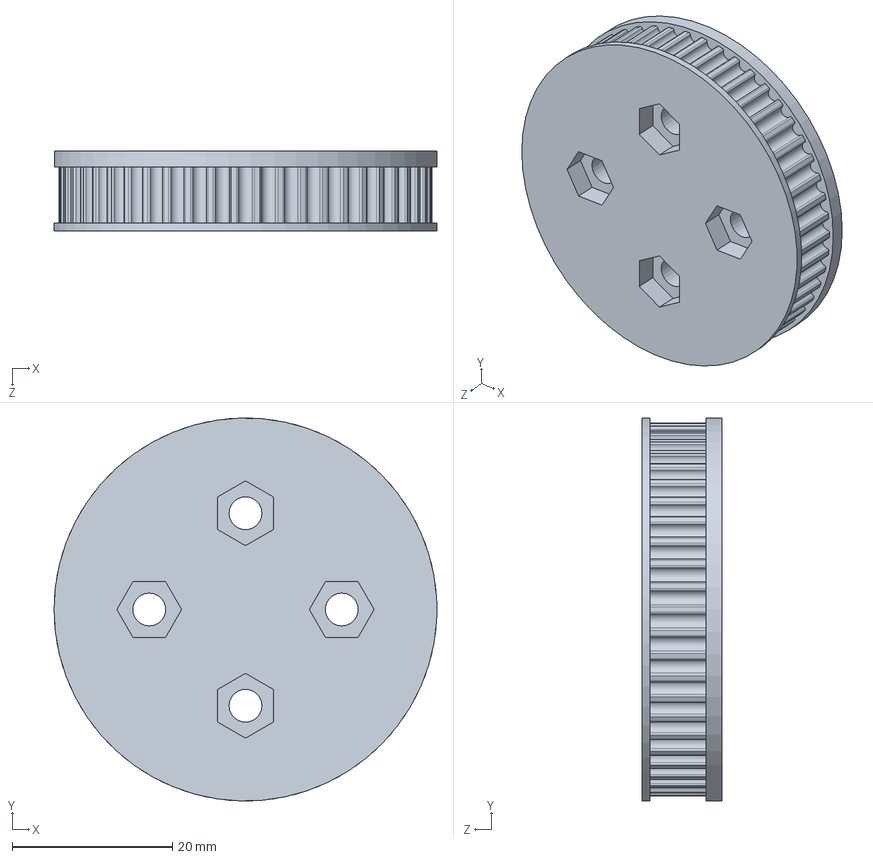
[picture p138: CAD file, 2025-10-08]
Solidworks/Arm1/Arm1Pulley1_v2.SLDPRT
47.8 x 47.7 x 10.0 mm
