Vinomakon/6-Axis-Robotarm/Solidworks/2nd Prototype/General/Bearing_I35_O57_T9.SLDPRT

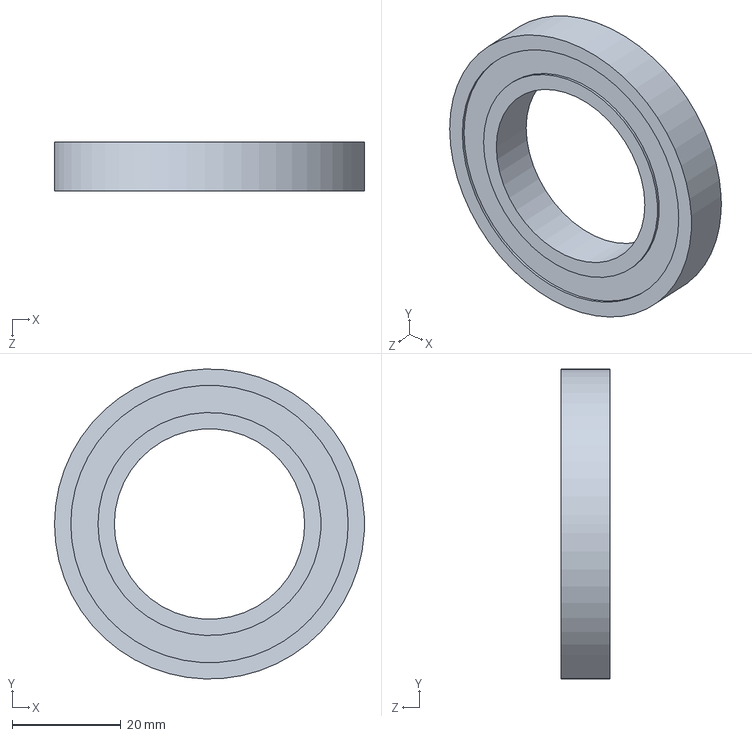
[picture p139: CAD file, 2025-07-31]
Solidworks/2nd Prototype/General/Bearing_I35_O57_T9.SLDPRT
57.0 x 57.0 x 9.00 mm
