Vinomakon/6-Axis-Robotarm/Solidworks/General/BearingSpacer.SLDPRT

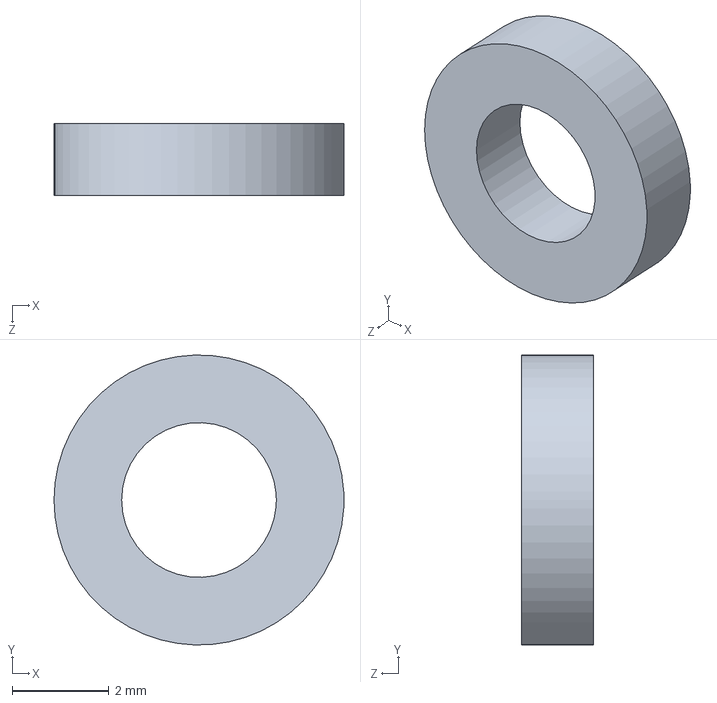
[picture p140: CAD file, 2025-07-22]
Solidworks/General/BearingSpacer.SLDPRT
6.00 x 6.00 x 1.50 mm
