Vinomakon/6-Axis-Robotarm/Solidworks/2nd Prototype/RobotAssembly.SLDASM

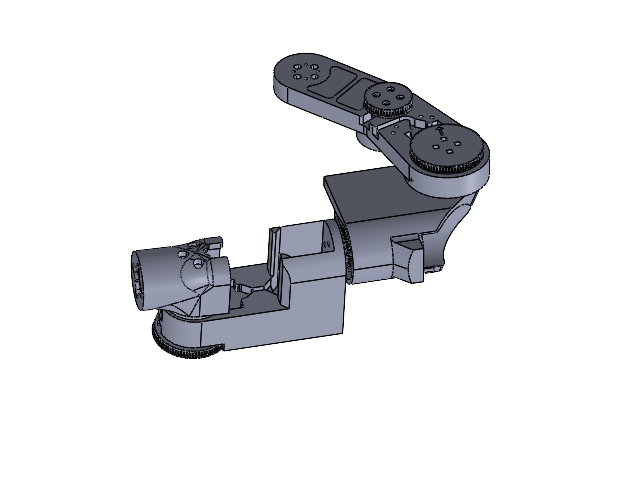
[picture p141: CAD file, 2025-07-23]
Solidworks/2nd Prototype/RobotAssembly.SLDASM
Arm1
Arm1Pulley1
Arm1Pulley2
Arm2
Arm2PulleyHigh
Arm2PulleyLow
Arm2PulleyMid
Arm3
Arm3PulleyHigh
Arm3PulleyLow
Arm3PulleyMid
Arm4
