Vinomakon/6-Axis-Robotarm/Solidworks/3rd Prototype/Arm2/Arm2Pulley_v3.SLDASM

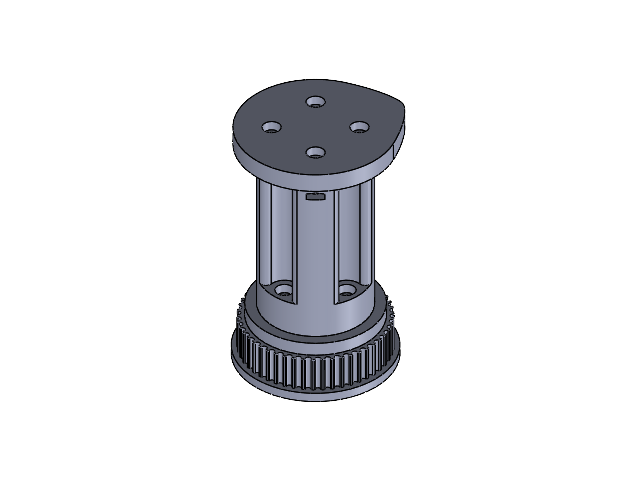
[picture p142: CAD file, 2025-08-18]
Solidworks/3rd Prototype/Arm2/Arm2Pulley_v3.SLDASM
Arm2PulleyHigh
Arm2PulleyLow
Arm2PulleyMid
