Vinomakon/6-Axis-Robotarm/Solidworks/3rd Prototype/General/EG17-G10.SLDASM

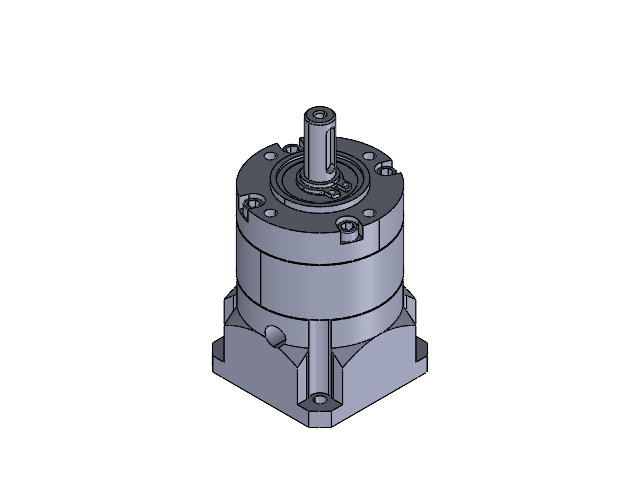
[picture p143: CAD file, 2025-07-31]
Solidworks/3rd Prototype/General/EG17-G10.SLDASM
EG17 shaft.STEP
nema17input flange.STEP
input shaft.STEP
__10circlip.STEP
M3hexagon socket head cap screw.STEP x 8
6801.STEP
