Vinomakon/6-Axis-Robotarm/Solidworks/Full Assemblies/FullAssembly_wo_Fasteners.SLDASM

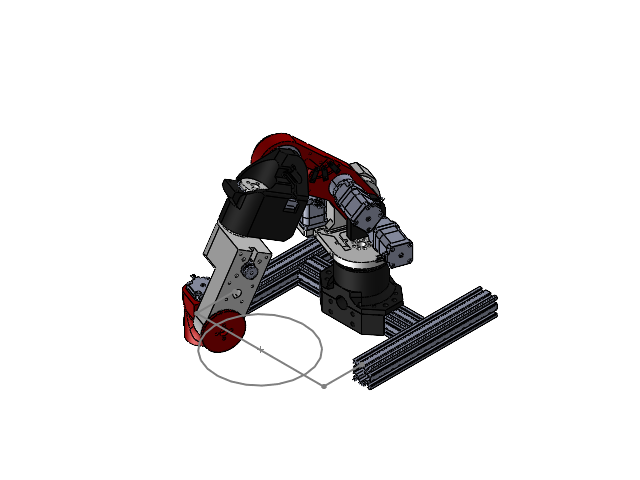
[picture p144: CAD file, 2026-01-07]
Solidworks/Full Assemblies/FullAssembly_wo_Fasteners.SLDASM
AluminiumExtrusion x 3
BaseSideHolder x 2
Base_v1
BaseHolderCap_v1
BaseHolderMid_v1
Bearing_I35_O62_T14 x 4
Arm0_v1
Arm0HolderHigh_v1
Arm0HolderMid_v1
Arm0MotorHolder_v1
Arm0SwitchActuator_v1
17HE24-2004S1(1)_1.STEP x 3
17HE24-2004S1_1.STEP x 3
EG17 shaft-2.STEP x 2
input shaft_1.STEP x 2
__10circlip_1.STEP x 2
M3hexagon socket head cap screw_1.STEP x 16
6801_1.STEP x 2
Arm1_v3
Arm1Pulley2_v3
Arm1CableHolder_v3 x 3
Bearing_I35_O70_T10 x 2
EG17 shaft.STEP
nema17input flange.STEP
input shaft.STEP
__10circlip.STEP
M3hexagon socket head cap screw.STEP x 8
6801.STEP
HTD_3M_Pulley x 4
MotorFlange_S8_D32_H24_
Arm2PulleyHigh_v2
Arm2PulleyLow_v2
Arm2PulleyMid_v2
Arm2_v2
Bearing_I35_O57_T9 x 4
17HE19-2004S x 2
Arm3_v2
Arm3PulleyLow_v2
Arm3PulleyMid_v2
Arm3PulleyHigh_v2
Arm4_v2
17HS10-0704S
