Vinomakon/6-Axis-Robotarm/Solidworks/Full Assemblies/BareBonesAssembly.SLDASM

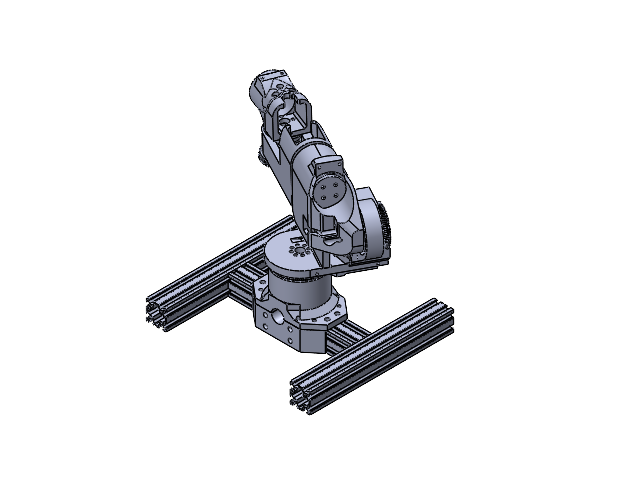
[picture p145: CAD file, 2025-10-08]
Solidworks/Full Assemblies/BareBonesAssembly.SLDASM
AluminiumExtrusion x 3
BaseSideHolder x 2
Base_v1
BaseHolderCap_v1
BaseHolderMid_v1
Arm0_v1
Arm0HolderHigh_v1
Arm0HolderMid_v1
Arm0MotorHolder_v1
Arm0SwitchActuator_v1
Arm1_v3
Arm1Pulley2_v3
Arm1CableHolder_v3 x 3
Arm2PulleyHigh_v2
Arm2PulleyLow_v2
Arm2PulleyMid_v2
Arm2_v2
Arm3_v2
Arm3PulleyLow_v2
Arm3PulleyMid_v2
Arm3PulleyHigh_v2
Arm4_v2
