Vinomakon/6-Axis-Robotarm/Solidworks/2nd Prototype/General/EG17-G20.SLDASM

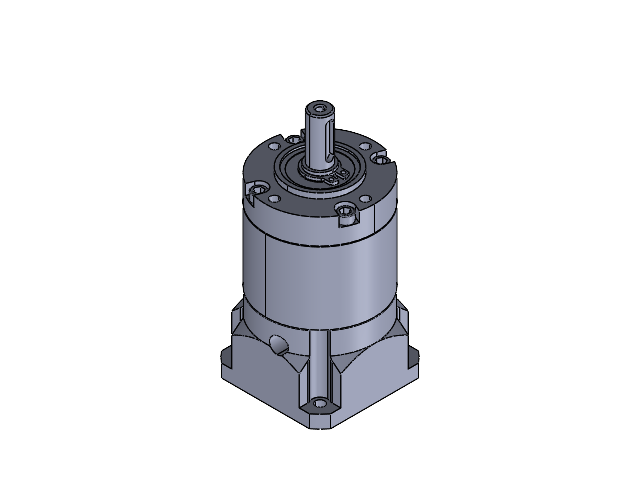
[picture p146: CAD file, 2025-07-31]
Solidworks/2nd Prototype/General/EG17-G20.SLDASM
EG17 shaft-2.STEP
nema17input flange_1.STEP
input shaft_1.STEP
__10circlip_1.STEP
M3hexagon socket head cap screw_1.STEP x 8
6801_1.STEP
