Vinomakon/6-Axis-Robotarm/Solidworks/Full Assemblies/Prototype_Robot_Assembly_v2.SLDASM

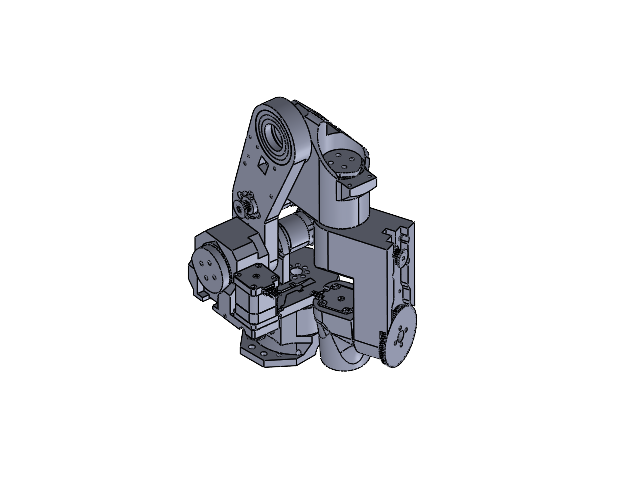
[picture p147: CAD file, 2025-08-18]
Solidworks/Full Assemblies/Prototype_Robot_Assembly_v2.SLDASM
Arm2PulleyHigh_v1
Arm2PulleyLow_v1
Arm2PulleyMid_v1
Arm3_v1
Arm3PulleyHigh_v1
Arm3PulleyLow_v1
Arm3PulleyMid_v1
Arm4_v1
EG17 shaft-2.STEP x 2
nema17input flange_1.STEP x 2
input shaft_1.STEP x 2
__10circlip_1.STEP x 2
M3hexagon socket head cap screw_1.STEP x 16
6801_1.STEP x 2
17HE19-2004S x 2
17HE24-2004S1(1)_1.STEP x 3
17HE24-2004S1_1.STEP x 3
Bearing_I35_O57_T9 x 4
Bearing_I35_O70_T10 x 2
EG17 shaft.STEP
nema17input flange.STEP
input shaft.STEP
__10circlip.STEP
M3hexagon socket head cap screw.STEP x 8
6801.STEP
HTD_3M_Pulley x 4
17HS10-0704S
MotorFlange_S8_D32_H24_
Arm0_v1
Arm0MotorHolder_v1
Bearing_I35_O62_T14 x 4
Arm0HolderHigh_v1
Arm0HolderMid_v1
Base_v1
BaseHolderCap_v1
BaseHolderMid_v1
Arm1_v3
Arm2_v2
Arm0SwitchActuator_v1
