Vinomakon/6-Axis-Robotarm/Solidworks/2nd Prototype/General/17HE24-2104S1.SLDASM

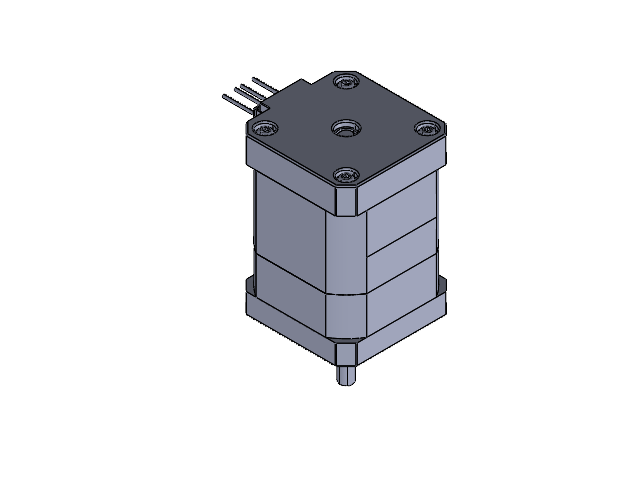
[picture p148: CAD file, 2025-07-31]
Solidworks/2nd Prototype/General/17HE24-2104S1.SLDASM
17HE24-2004S1(1)_1.STEP
17HE24-2004S1_1.STEP
