Vinomakon/6-Axis-Robotarm/(list of files, cad)

Other CAD files:
Solidworks/3rd Prototype/Arm3/Arm3Pulley_v3.SLDASM
Solidworks/Arm3/Arm3Pulley_v2.SLDASM
Solidworks/3rd Prototype/Arm4/Arm4_v3.SLDPRT
Solidworks/Arm2/Arm2PulleyAssembly_v2/Arm2PulleyLow_v2.SLDPRT
Solidworks/3rd Prototype/Arm2/Arm2PulleyAssembly/Arm2PulleyHigh_v3.SLDPRT
Solidworks/3rd Prototype/Arm2/Arm2PulleyAssembly/Arm2PulleyMid_v3.SLDPRT
Solidworks/3rd Prototype/General/HTD_3M_Pulley.SLDPRT
Solidworks/Arm2/Arm2PulleyAssembly_v2/Arm2PulleyHigh_v2.SLDPRT
Solidworks/Arm3/Arm3Pulley_v2/Arm3PulleyHigh_v2.SLDPRT
Solidworks/3rd Prototype/Arm2/Arm2PulleyAssembly/Arm2PulleyLow_v3.SLDPRT
Solidworks/Arm1/Arm1CableHolder_v3.SLDPRT
Solidworks/2nd Prototype/General/HTD_3M_Pulley.SLDPRT
Solidworks/3rd Prototype/General/LimitSwitchHolder.SLDPRT
Solidworks/Arm1/Arm1Pulley2_v1.SLDPRT
Solidworks/Arm1/Arm1Pulley2_v2.SLDPRT
Solidworks/Arm1/Arm1_v1.SLDPRT
Solidworks/Arm1/Arm1_v2.SLDPRT
Solidworks/Arm2/Arm2Pulley_v1.SLDASM
Solidworks/Arm2/Arm3ScrewSpacer.SLDPRT
Solidworks/Arm3/Arm3Pulley_v1.SLDASM
Solidworks/Arm4/Arm4_v1.SLDPRT
Solidworks/Base/BaseHolderMid_v1.SLDPRT
Solidworks/Base/Base_v1.SLDPRT
Solidworks/General/Fastener/M3CylinderScrew.SLDPRT
Solidworks/General/Fastener/M3_SquareNut.SLDPRT
