Vinomakon/6-Axis-Robotarm/Documents/Motor Wiring Schematic.xlsx

DIR1 | Motor 1 | Default Speed | Big Default Speed
STEP1 |  | 1000
EN1
CS1
DIR2 | Motor 2 (Big)
STEP2
EN2
CS2
DIR2 | Motor 3 (Big)
STEP2
EN2
CS2
DIR3 | Motor 4
STEP3
EN3
CS3
DIR3 | Motor 5
STEP3
EN3
CS3
DIR4 | Motor 6
STEP4
EN4
CS4
SW1 | Homing Switches
SW2
SW3
SW4
SW5
SW6
SDI | SPI Interface
SCK
SDO
