Vinomakon/6-Axis-Robotarm/Documents/Dokumentation/LaTeX Dokumentation/images/Solidworks/Arm_Aufbau.png

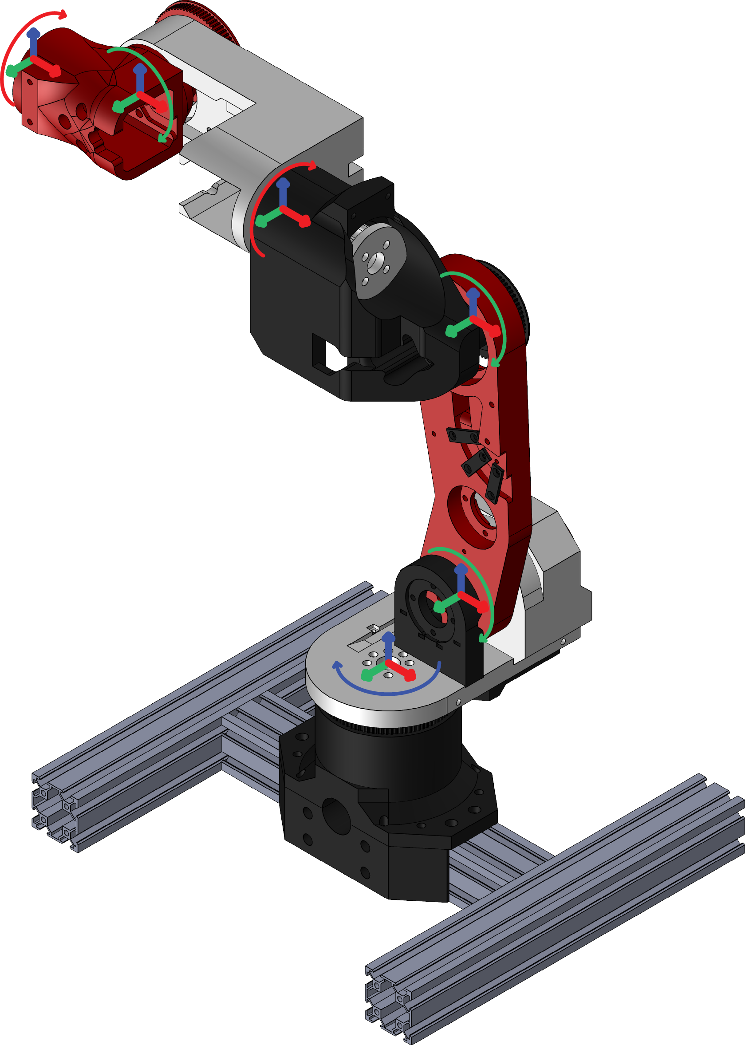
Documents/Dokumentation/LaTeX Dokumentation/images/Solidworks/Arm_Aufbau.png
