Vinomakon/6-Axis-Robotarm/Documents/Dokumentation/LaTeX Dokumentation/images/Solidworks/FullAssembly_wo_Fasteners.PNG

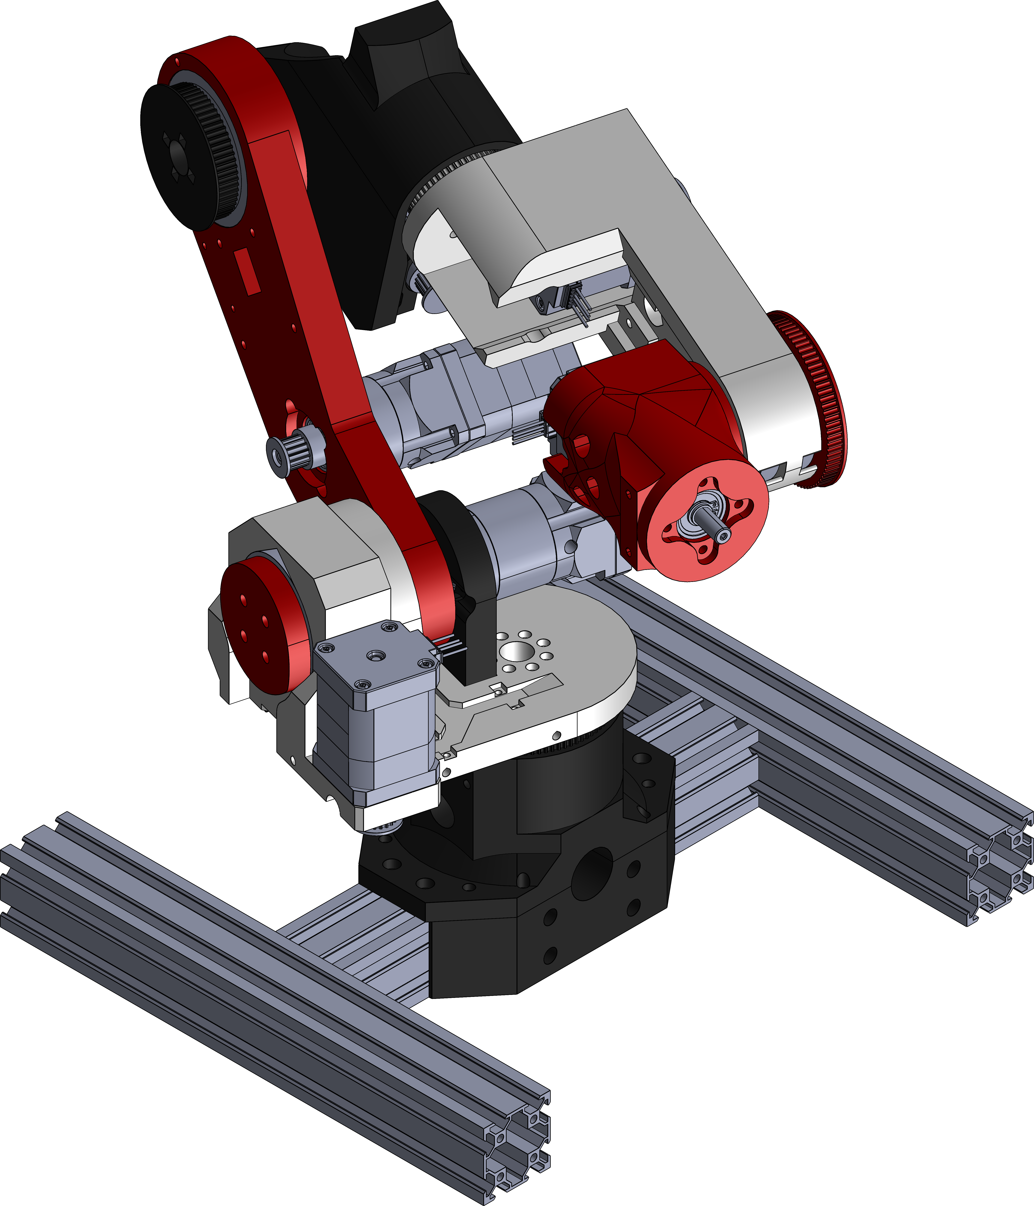
Documents/Dokumentation/LaTeX Dokumentation/images/Solidworks/FullAssembly_wo_Fasteners.PNG
