Vinomakon/6-Axis-Robotarm/Documents/Dokumentation/LaTeX Dokumentation/images/WholeConstruction.jpg

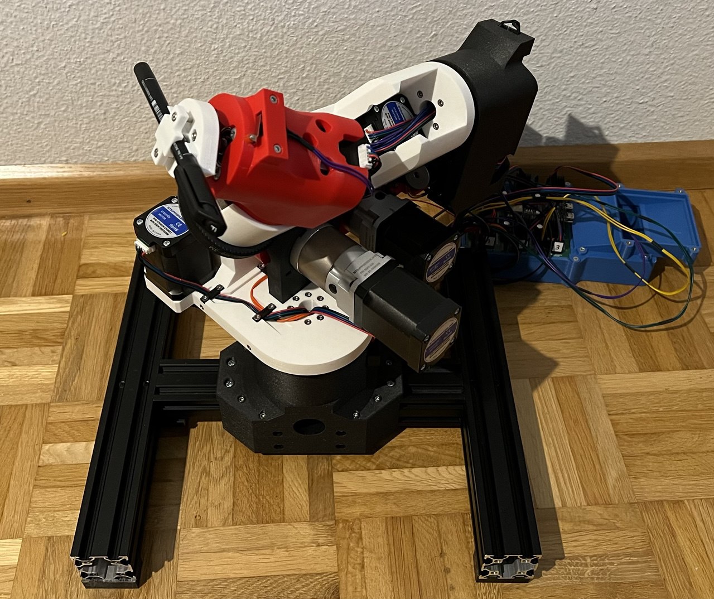
Documents/Dokumentation/LaTeX Dokumentation/images/WholeConstruction.jpg
