Vinomakon/6-Axis-Robotarm/Arduino Projects/MKS 42C Servo Test/reference_libraries/TMCStepper/extras/TMC5130_TMC2130_TMC2100_Calculations.xlsx

Sheet: Velocity Calculation
This spreadsheet allows the calculation of target velocity and acceleration values for the internal ramp generator of the TMC5130
Usage: | 1. First enter the highlighted values in Parameters and settings
 | 2. Now you can use one of the calculations (1. - 4.) by entering the known parameters (green)
Parameters and settings
 | 150 | RPM | Desired Velocity | t | = | 2^24/fCLK | = | 1.048576 | [sec]
 | 16 | µS/FS | µStepresolution (256) | VMAX | = | 0 … 2^23-512 |  | [µS/t]
 | 1.8 | ° | Fullstep angel | fCLK | = | 16000000 |  | Hz
 | 200 | FS/360° | Fullsteps per revolution
 | 3200 | µS/360° | µSteps per revolution
 | 1 | :1 | gear ratio
1. VMAX to real world units
 | 8388.608 | VMAX | [µS/t] | <--Entry desired VMAX setting here!
 | 2.50 | RPS | motor shaft
 | 900.00 | deg/sec | motor shaft
 | 900.00 | deg/sec | gear box out
 | 8000.00 | Hz | [µSteps/s]
 | 2.50 | RPS | gear box out
2. real world units to VMAX
 | 2.50 | RPS | motor shaft | <--Entry desired rotations per second here!
 | 900.00 | deg/sec | motor shaft
 | 8388.608 | VMAX | [µS/t]
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
