Vinomakon/6-Axis-Robotarm/Documents/Dokumentation/LaTeX Dokumentation/images/Screenshots/Cropped Results.jpg

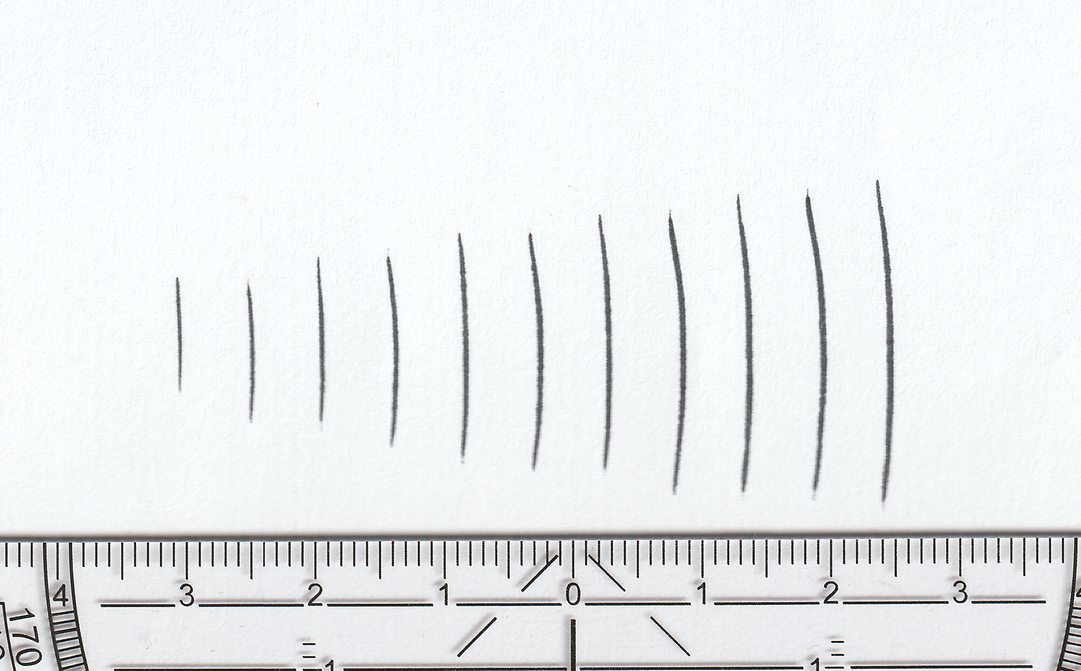
Documents/Dokumentation/LaTeX Dokumentation/images/Screenshots/Cropped Results.jpg
