Vinomakon/6-Axis-Robotarm/Documents/Dokumentation/LaTeX Dokumentation/images/KiCAD/Driver Carrier v1.pdf

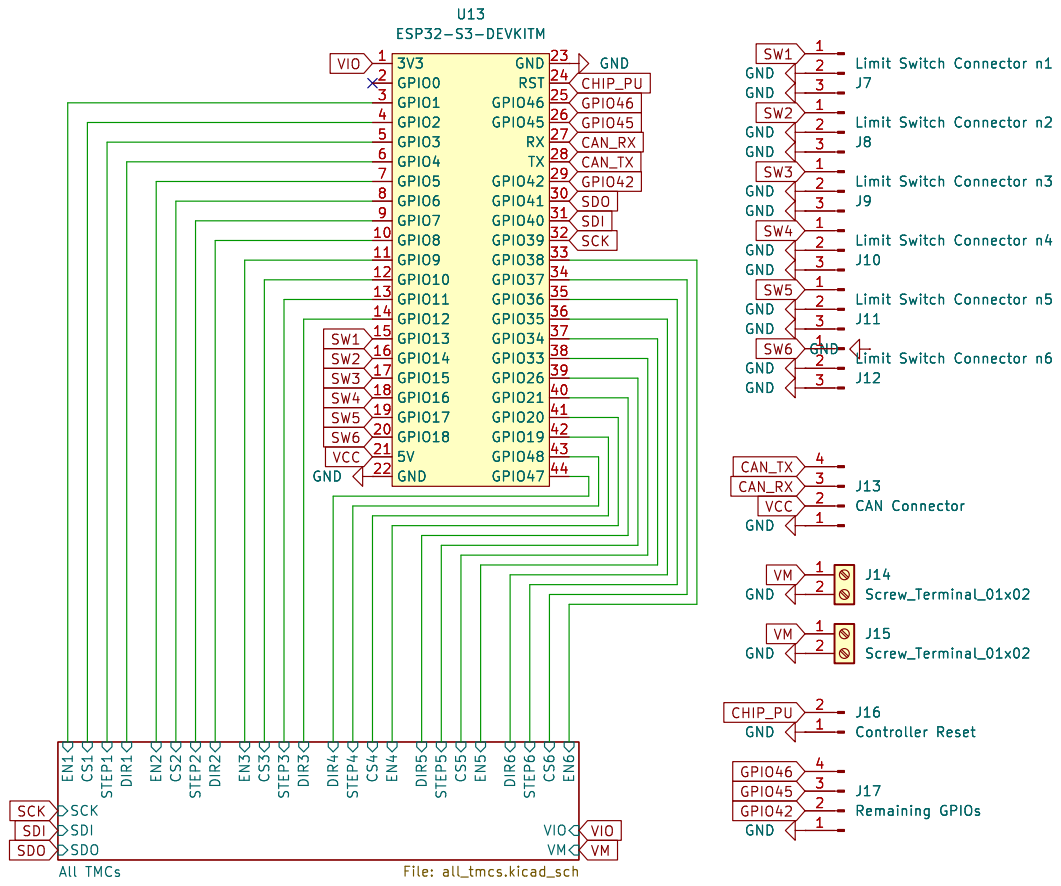
[picture p154: page 1]

Id: 1/8 Title: File: Driver Carrier v1.kicad_sch Sheet: / SCK
SDI SDO

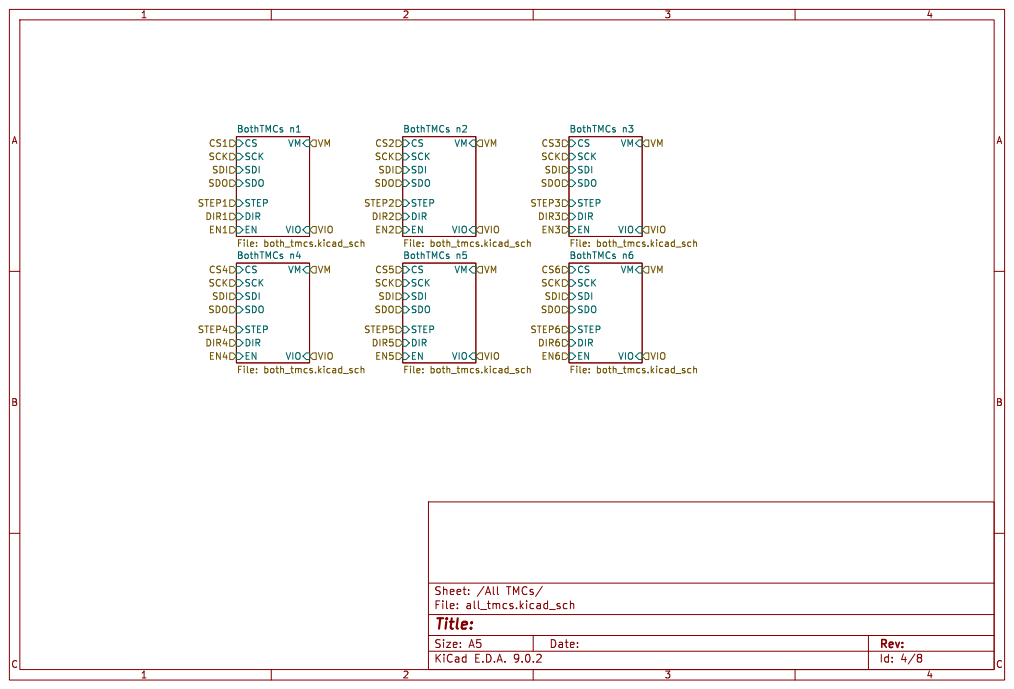
[picture p155: page 2]

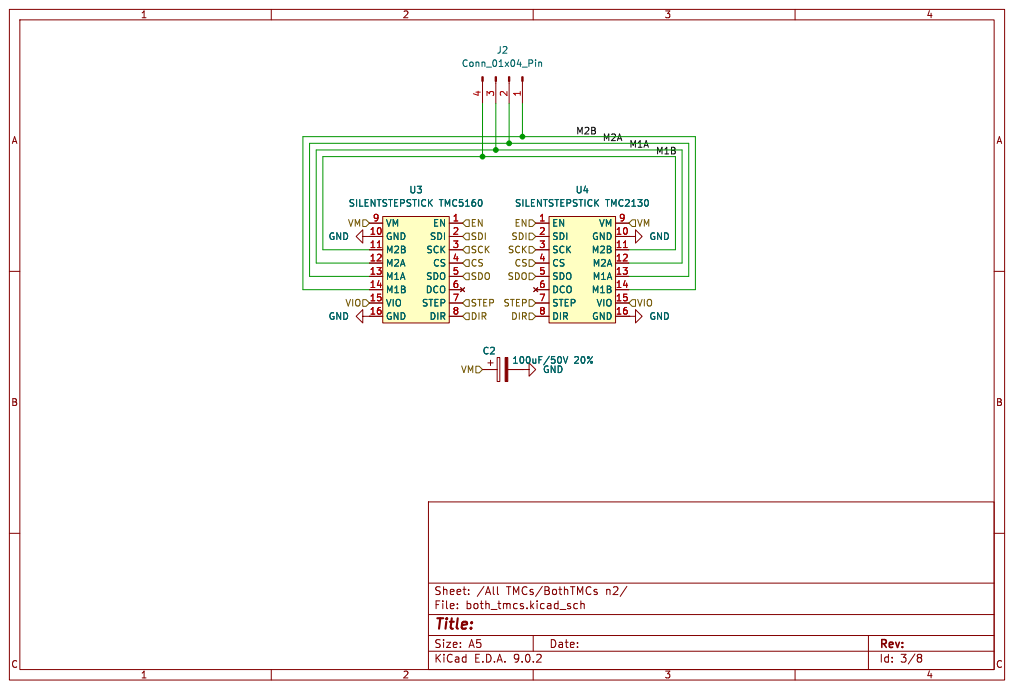
[picture p156: page 3]

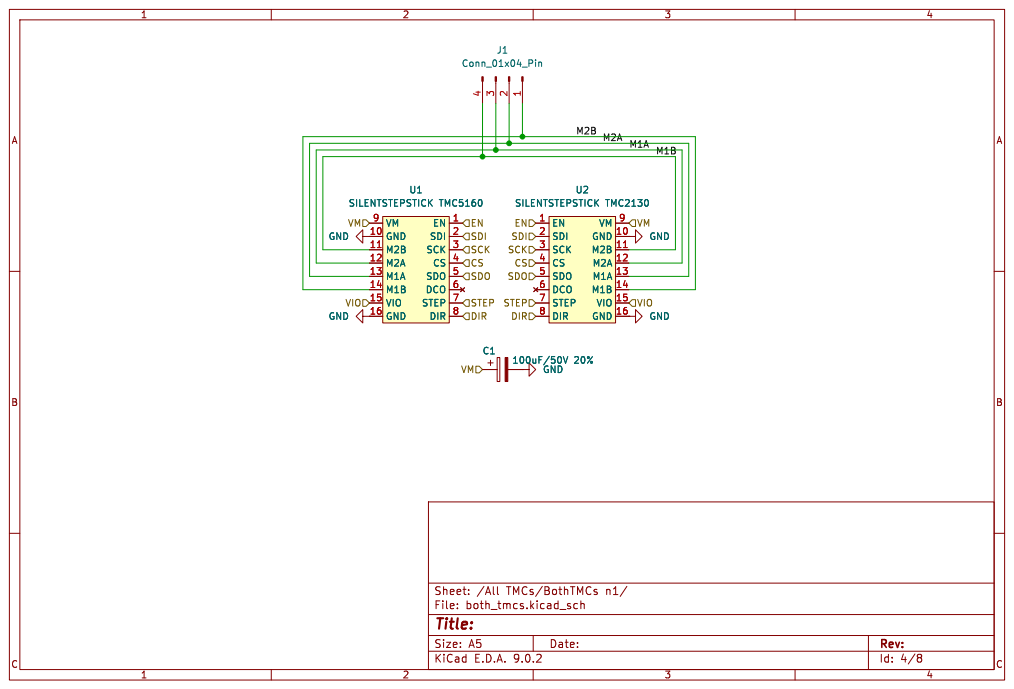
[picture p157: page 4]

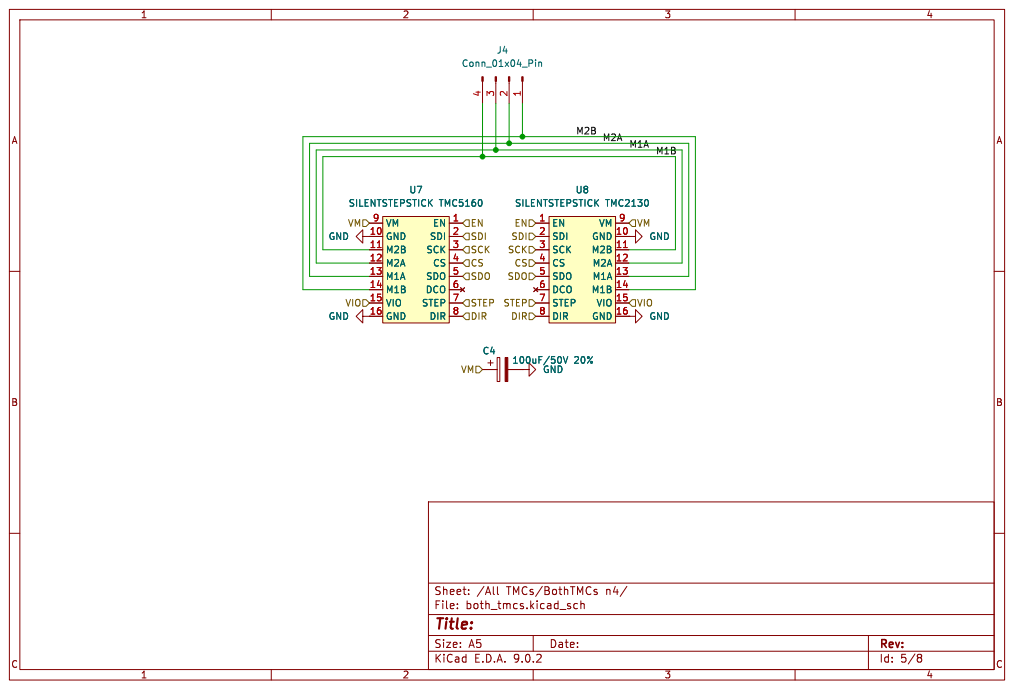
[picture p158: page 5]

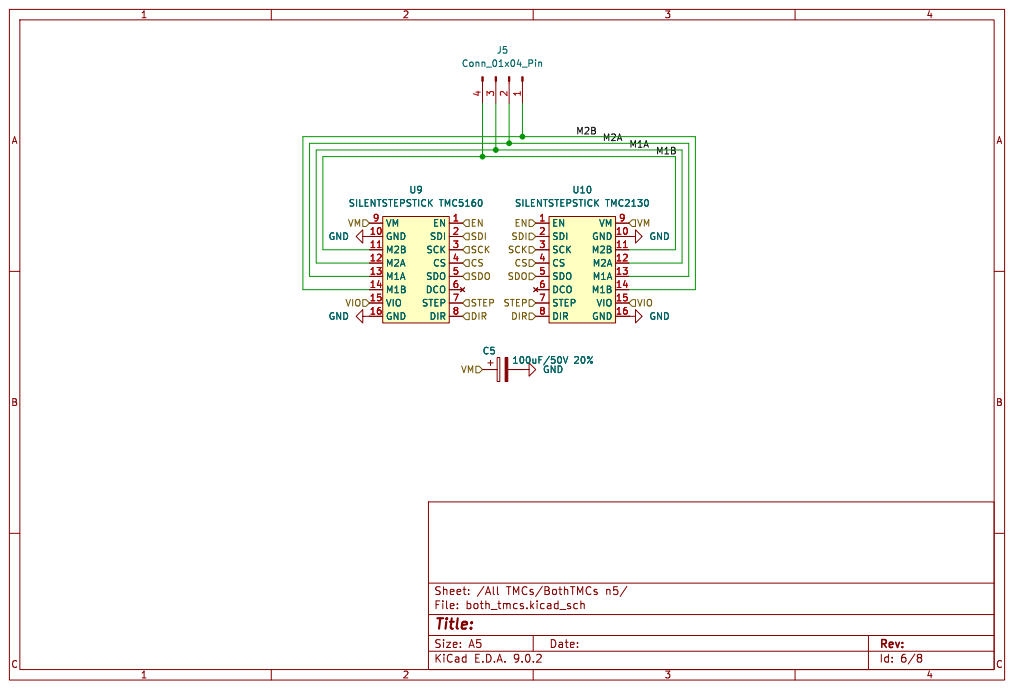
[picture p159: page 6]

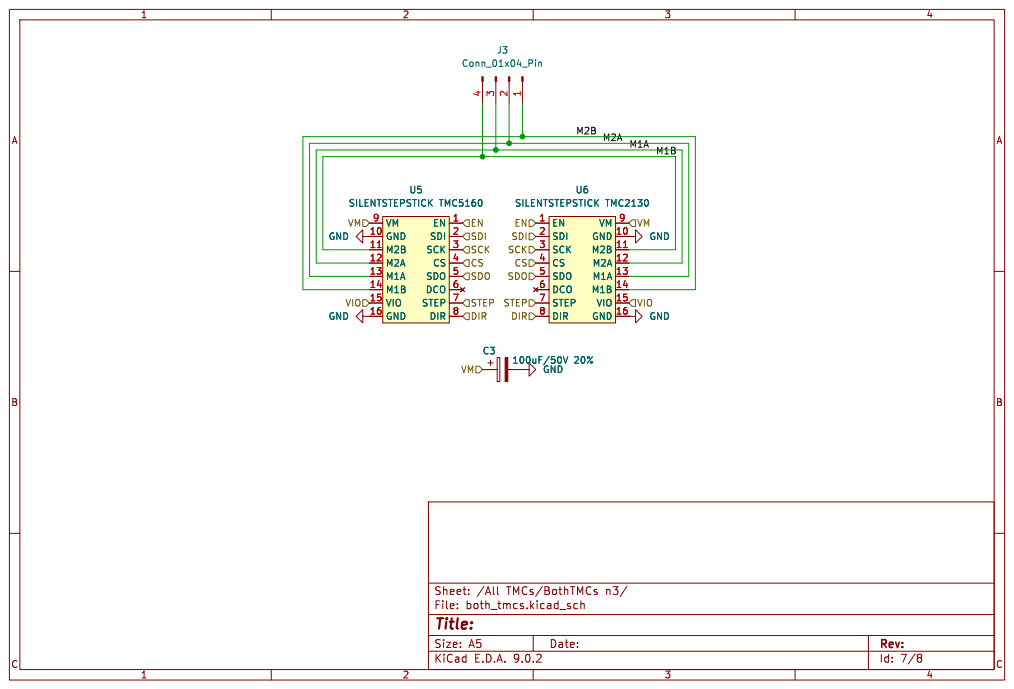
[picture p160: page 7]

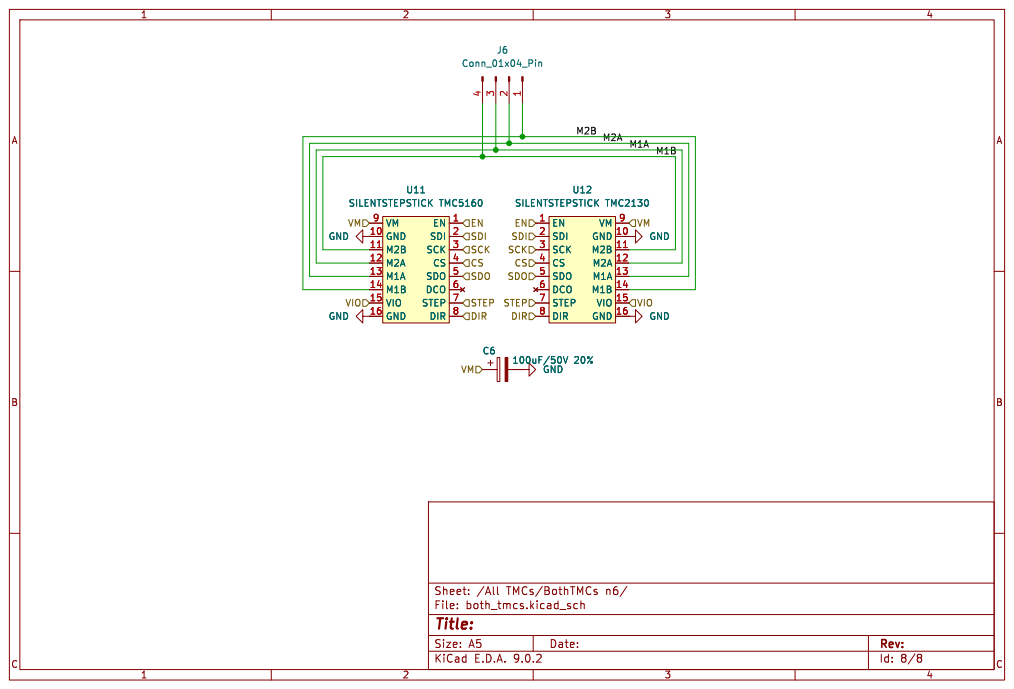
[picture p161: page 8]
