Vinomakon/6-Axis-Robotarm/Poster/Tex/main.pdf

x

y

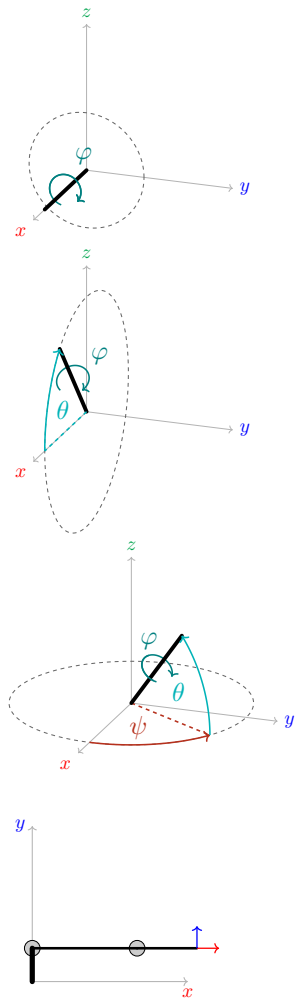
[picture p162: page 1]

x

y

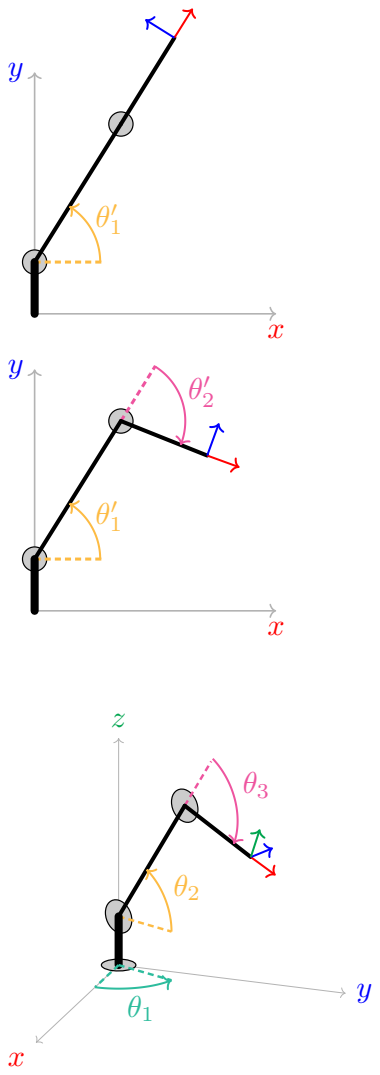
[picture p163: page 2]

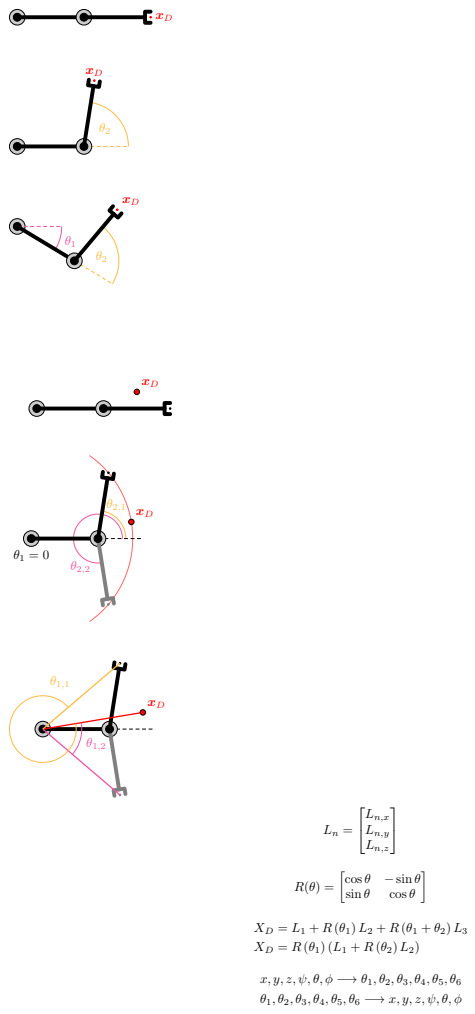
[picture p164: page 3]
cos θ − sin θ; sin θ; cos θ
