Vinomakon/6-Axis-Robotarm/PCBs/Driver Carrier v1/Driver Carrier v1.kicad_pcb

## KiCad design PCBs/Driver Carrier v1/Driver Carrier v1.kicad_pcb (2025-02-26, an earlier design)

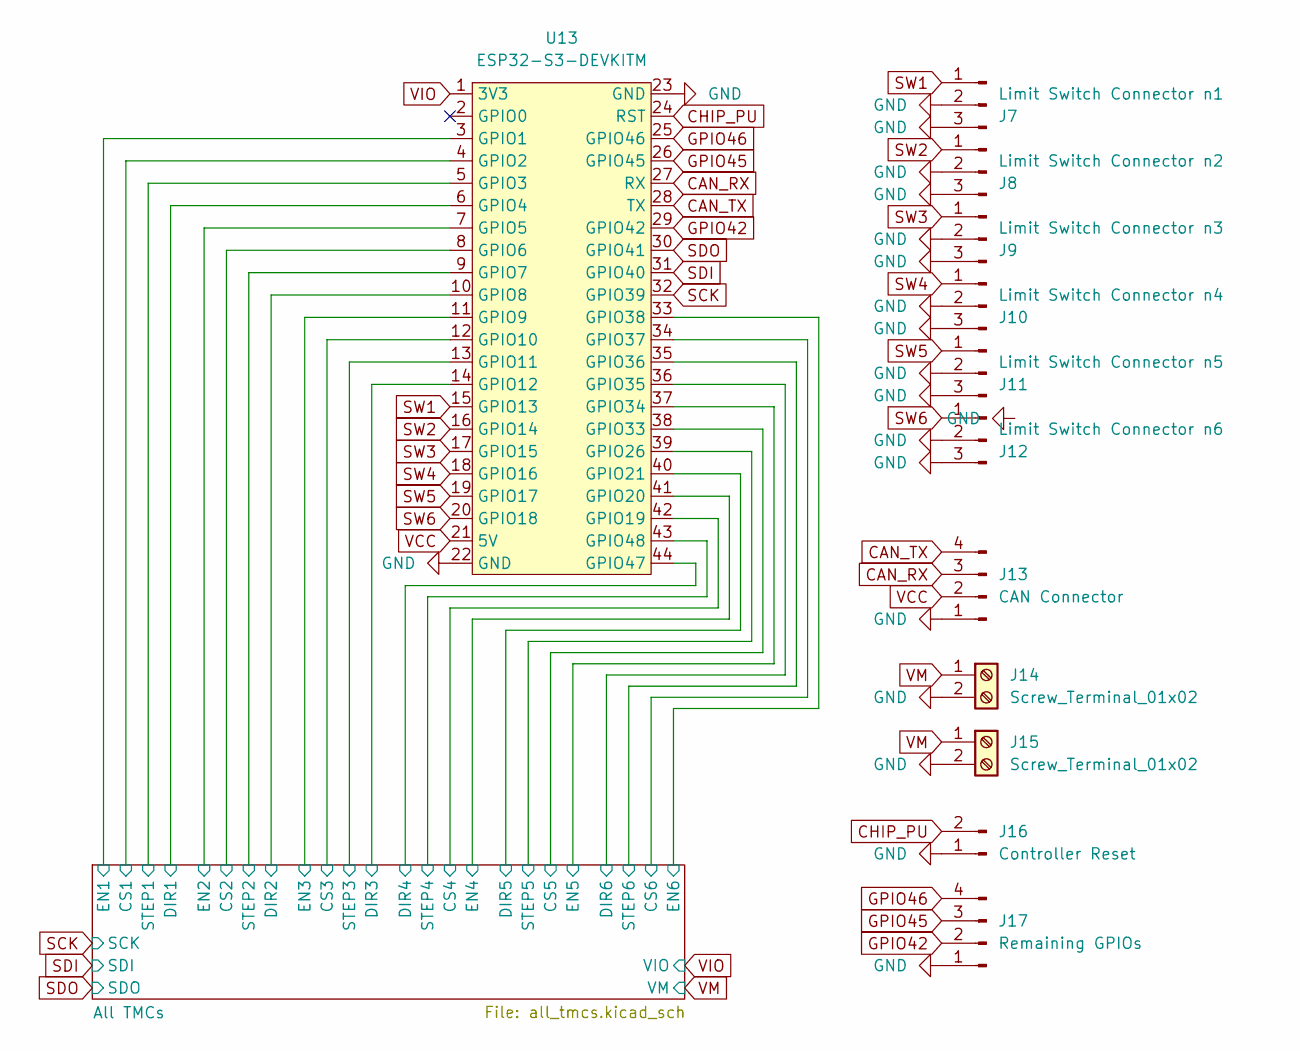
[picture p168: schematic Driver Carrier v1.kicad_sch]

Parts:
J7: Limit Switch Connector n1; PinHeader_1x03_P2.54mm_Vertical
J8: Limit Switch Connector n2; PinHeader_1x03_P2.54mm_Vertical
J9: Limit Switch Connector n3; PinHeader_1x03_P2.54mm_Vertical
J10: Limit Switch Connector n4; PinHeader_1x03_P2.54mm_Vertical
J11: Limit Switch Connector n5; PinHeader_1x03_P2.54mm_Vertical
J12: Limit Switch Connector n6; PinHeader_1x03_P2.54mm_Vertical
J13: CAN Connector; PinHeader_1x04_P2.54mm_Vertical
J14, J15: Screw_Terminal_01x02; Phoenix_TerminalBlock_1x02_3.5mm_1984617
J16: Controller Reset; PinHeader_1x02_P2.54mm_Vertical
J17: Remaining GPIOs; PinHeader_1x04_P2.54mm_Vertical
U13: ESP32-S3-DEVKITM; ESP32-S3-DEVKITM Female Headers

Connections:
/All TMCs/CS1: U13.4 (GPIO2); also elsewhere on the board
/All TMCs/CS2: U13.8 (GPIO6); also elsewhere on the board
/All TMCs/CS3: U13.12 (GPIO10); also elsewhere on the board
/All TMCs/CS4: U13.42 (GPIO19); also elsewhere on the board
/All TMCs/CS5: U13.38 (GPIO33); also elsewhere on the board
/All TMCs/CS6: U13.34 (GPIO37); also elsewhere on the board
/All TMCs/DIR1: U13.6 (GPIO4); also elsewhere on the board
/All TMCs/DIR2: U13.10 (GPIO8); also elsewhere on the board
/All TMCs/DIR3: U13.14 (GPIO12); also elsewhere on the board
/All TMCs/DIR4: U13.44 (GPIO47); also elsewhere on the board
/All TMCs/DIR5: U13.40 (GPIO21); also elsewhere on the board
/All TMCs/DIR6: U13.36 (GPIO35); also elsewhere on the board
/All TMCs/EN1: U13.3 (GPIO1); also elsewhere on the board
/All TMCs/EN2: U13.7 (GPIO5); also elsewhere on the board
/All TMCs/EN3: U13.11 (GPIO9); also elsewhere on the board
/All TMCs/EN4: U13.41 (GPIO20); also elsewhere on the board
/All TMCs/EN5: U13.37 (GPIO34); also elsewhere on the board
/All TMCs/EN6: U13.33 (GPIO38); also elsewhere on the board
/All TMCs/STEP1: U13.5 (GPIO3); also elsewhere on the board
/All TMCs/STEP2: U13.9 (GPIO7); also elsewhere on the board
/All TMCs/STEP3: U13.13 (GPIO11); also elsewhere on the board
/All TMCs/STEP4: U13.43 (GPIO48); also elsewhere on the board
/All TMCs/STEP5: U13.39 (GPIO26); also elsewhere on the board
/All TMCs/STEP6: U13.35 (GPIO36); also elsewhere on the board
CAN_RX: J13.3, U13.27 (RX)
CAN_TX: J13.4, U13.28 (TX)
CHIP_PU: J16.2, U13.24 (RST)
GND: J7.2, J7.3, J8.2, J8.3, J9.2, J9.3, J10.2, J10.3, J11.2, J11.3, J12.2, J12.3, J13.1, J14.2, J15.2, J16.1, J17.1, U13.22 (GND), U13.23 (GND); also elsewhere on the board
GPIO42: J17.2, U13.29 (GPIO42)
GPIO45: J17.3, U13.26 (GPIO45)
GPIO46: J17.4, U13.25 (GPIO46)
SCK: U13.32 (GPIO39); also elsewhere on the board
SDI: U13.31 (GPIO40); also elsewhere on the board
SDO: U13.30 (GPIO41); also elsewhere on the board
SW1: J7.1, U13.15 (GPIO13)
SW2: J8.1, U13.16 (GPIO14)
SW3: J9.1, U13.17 (GPIO15)
SW4: J10.1, U13.18 (GPIO16)
SW5: J11.1, U13.19 (GPIO17)
SW6: J12.1, U13.20 (GPIO18)
VCC: J13.2, U13.21 (5V)
VIO: U13.1 (3V3); also elsewhere on the board
VM: J14.1, J15.1; also elsewhere on the board

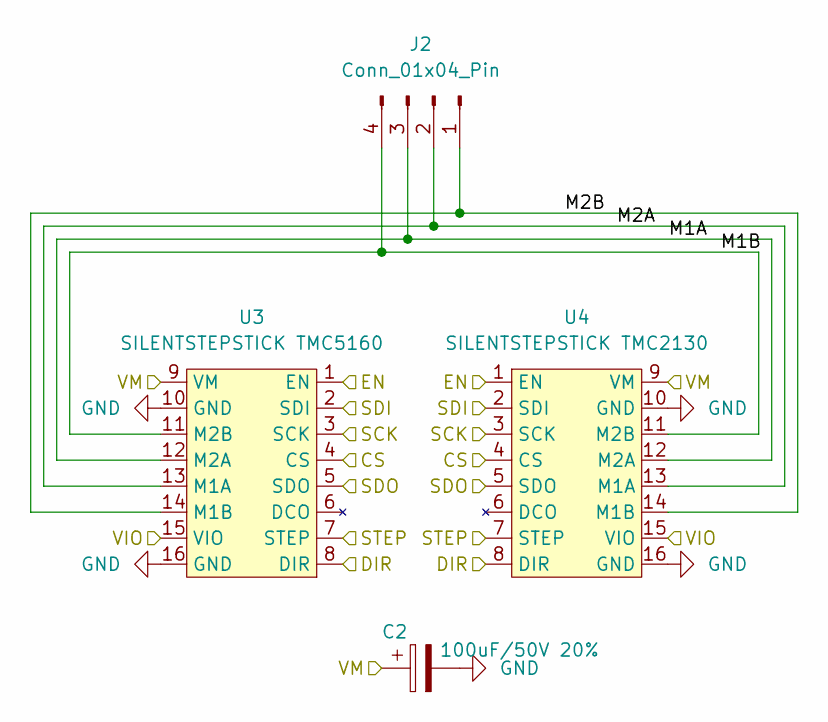
[picture p169: schematic both_tmcs.kicad_sch]

Parts:
C2: 100uF/50V 20%; CP_Radial_D8.0mm_P3.50mm
J2: Conn_01x04_Pin; PinHeader_1x04_P2.54mm_Vertical
U3: SILENTSTEPSTICK TMC5160; Digikey PartN TMC5160SILENTSTEPSTICK
U4: SILENTSTEPSTICK TMC2130; Digikey PartN TMCSILENTSTEPSTICK SPI

Connections:
/All TMCs/BothTMCs n2/M1A: J2.3, U3.12 (M2A), U4.12 (M2A)
/All TMCs/BothTMCs n2/M1B: J2.4, U3.11 (M2B), U4.11 (M2B)
/All TMCs/BothTMCs n2/M2A: J2.2, U3.13 (M1A), U4.13 (M1A)
/All TMCs/BothTMCs n2/M2B: J2.1, U3.14 (M1B), U4.14 (M1B)
/All TMCs/CS2: U3.4 (CS), U4.4 (CS); also elsewhere on the board
/All TMCs/DIR2: U3.8 (DIR), U4.8 (DIR); also elsewhere on the board
/All TMCs/EN2: U3.1 (EN), U4.1 (EN); also elsewhere on the board
/All TMCs/STEP2: U3.7 (STEP), U4.7 (STEP); also elsewhere on the board
GND: C2.2, U3.10 (GND), U3.16 (GND), U4.10 (GND), U4.16 (GND); also elsewhere on the board
SCK: U3.3 (SCK), U4.3 (SCK); also elsewhere on the board
SDI: U3.2 (SDI), U4.2 (SDI); also elsewhere on the board
SDO: U3.5 (SDO), U4.5 (SDO); also elsewhere on the board
VIO: U3.15 (VIO), U4.15 (VIO); also elsewhere on the board
VM: C2.1, U3.9 (VM), U4.9 (VM); also elsewhere on the board

Parts of its further copies:
C1, C3, C4, C5, C6: 100uF/50V 20%; CP_Radial_D8.0mm_P3.50mm
J1, J3, J4, J5, J6: Conn_01x04_Pin; PinHeader_1x04_P2.54mm_Vertical
U1, U5, U7, U9, U11: SILENTSTEPSTICK TMC5160; Digikey PartN TMC5160SILENTSTEPSTICK
U2, U6, U8, U10, U12: SILENTSTEPSTICK TMC2130; Digikey PartN TMCSILENTSTEPSTICK SPI

Connections of its further copies:
/All TMCs/BothTMCs n1/M1A: J1.3, U1.12 (M2A), U2.12 (M2A)
/All TMCs/BothTMCs n1/M1B: J1.4, U1.11 (M2B), U2.11 (M2B)
/All TMCs/BothTMCs n1/M2A: J1.2, U1.13 (M1A), U2.13 (M1A)
/All TMCs/BothTMCs n1/M2B: J1.1, U1.14 (M1B), U2.14 (M1B)
/All TMCs/BothTMCs n3/M1A: J3.3, U5.12 (M2A), U6.12 (M2A)
/All TMCs/BothTMCs n3/M1B: J3.4, U5.11 (M2B), U6.11 (M2B)
/All TMCs/BothTMCs n3/M2A: J3.2, U5.13 (M1A), U6.13 (M1A)
/All TMCs/BothTMCs n3/M2B: J3.1, U5.14 (M1B), U6.14 (M1B)
/All TMCs/BothTMCs n4/M1A: J4.3, U7.12 (M2A), U8.12 (M2A)
/All TMCs/BothTMCs n4/M1B: J4.4, U7.11 (M2B), U8.11 (M2B)
/All TMCs/BothTMCs n4/M2A: J4.2, U7.13 (M1A), U8.13 (M1A)
/All TMCs/BothTMCs n4/M2B: J4.1, U7.14 (M1B), U8.14 (M1B)
/All TMCs/BothTMCs n5/M1A: J5.3, U9.12 (M2A), U10.12 (M2A)
/All TMCs/BothTMCs n5/M1B: J5.4, U9.11 (M2B), U10.11 (M2B)
/All TMCs/BothTMCs n5/M2A: J5.2, U9.13 (M1A), U10.13 (M1A)
/All TMCs/BothTMCs n5/M2B: J5.1, U9.14 (M1B), U10.14 (M1B)
/All TMCs/BothTMCs n6/M1A: J6.3, U11.12 (M2A), U12.12 (M2A)
/All TMCs/BothTMCs n6/M1B: J6.4, U11.11 (M2B), U12.11 (M2B)
/All TMCs/BothTMCs n6/M2A: J6.2, U11.13 (M1A), U12.13 (M1A)
/All TMCs/BothTMCs n6/M2B: J6.1, U11.14 (M1B), U12.14 (M1B)
/All TMCs/CS1: U1.4 (CS), U2.4 (CS); also elsewhere on the board
/All TMCs/CS3: U5.4 (CS), U6.4 (CS); also elsewhere on the board
/All TMCs/CS4: U7.4 (CS), U8.4 (CS); also elsewhere on the board
/All TMCs/CS5: U9.4 (CS), U10.4 (CS); also elsewhere on the board
/All TMCs/CS6: U11.4 (CS), U12.4 (CS); also elsewhere on the board
/All TMCs/DIR1: U1.8 (DIR), U2.8 (DIR); also elsewhere on the board
/All TMCs/DIR3: U5.8 (DIR), U6.8 (DIR); also elsewhere on the board
/All TMCs/DIR4: U7.8 (DIR), U8.8 (DIR); also elsewhere on the board
/All TMCs/DIR5: U9.8 (DIR), U10.8 (DIR); also elsewhere on the board
/All TMCs/DIR6: U11.8 (DIR), U12.8 (DIR); also elsewhere on the board
/All TMCs/EN1: U1.1 (EN), U2.1 (EN); also elsewhere on the board
/All TMCs/EN3: U5.1 (EN), U6.1 (EN); also elsewhere on the board
/All TMCs/EN4: U7.1 (EN), U8.1 (EN); also elsewhere on the board
/All TMCs/EN5: U9.1 (EN), U10.1 (EN); also elsewhere on the board
/All TMCs/EN6: U11.1 (EN), U12.1 (EN); also elsewhere on the board
/All TMCs/STEP1: U1.7 (STEP), U2.7 (STEP); also elsewhere on the board
/All TMCs/STEP3: U5.7 (STEP), U6.7 (STEP); also elsewhere on the board
/All TMCs/STEP4: U7.7 (STEP), U8.7 (STEP); also elsewhere on the board
/All TMCs/STEP5: U9.7 (STEP), U10.7 (STEP); also elsewhere on the board
/All TMCs/STEP6: U11.7 (STEP), U12.7 (STEP); also elsewhere on the board
GND: C1.2, C3.2, C4.2, C5.2, C6.2, U1.10 (GND), U1.16 (GND), U2.10 (GND), U2.16 (GND), U5.10 (GND), U5.16 (GND), U6.10 (GND), U6.16 (GND), U7.10 (GND), U7.16 (GND), U8.10 (GND), U8.16 (GND), U9.10 (GND), U9.16 (GND), U10.10 (GND), U10.16 (GND), U11.10 (GND), U11.16 (GND), U12.10 (GND), U12.16 (GND); also elsewhere on the board
SCK: U1.3 (SCK), U2.3 (SCK), U5.3 (SCK), U6.3 (SCK), U7.3 (SCK), U8.3 (SCK), U9.3 (SCK), U10.3 (SCK), U11.3 (SCK), U12.3 (SCK); also elsewhere on the board
SDI: U1.2 (SDI), U2.2 (SDI), U5.2 (SDI), U6.2 (SDI), U7.2 (SDI), U8.2 (SDI), U9.2 (SDI), U10.2 (SDI), U11.2 (SDI), U12.2 (SDI); also elsewhere on the board
SDO: U1.5 (SDO), U2.5 (SDO), U5.5 (SDO), U6.5 (SDO), U7.5 (SDO), U8.5 (SDO), U9.5 (SDO), U10.5 (SDO), U11.5 (SDO), U12.5 (SDO); also elsewhere on the board
VIO: U1.15 (VIO), U2.15 (VIO), U5.15 (VIO), U6.15 (VIO), U7.15 (VIO), U8.15 (VIO), U9.15 (VIO), U10.15 (VIO), U11.15 (VIO), U12.15 (VIO); also elsewhere on the board
VM: C1.1, C3.1, C4.1, C5.1, C6.1, U1.9 (VM), U2.9 (VM), U5.9 (VM), U6.9 (VM), U7.9 (VM), U8.9 (VM), U9.9 (VM), U10.9 (VM), U11.9 (VM), U12.9 (VM); also elsewhere on the board

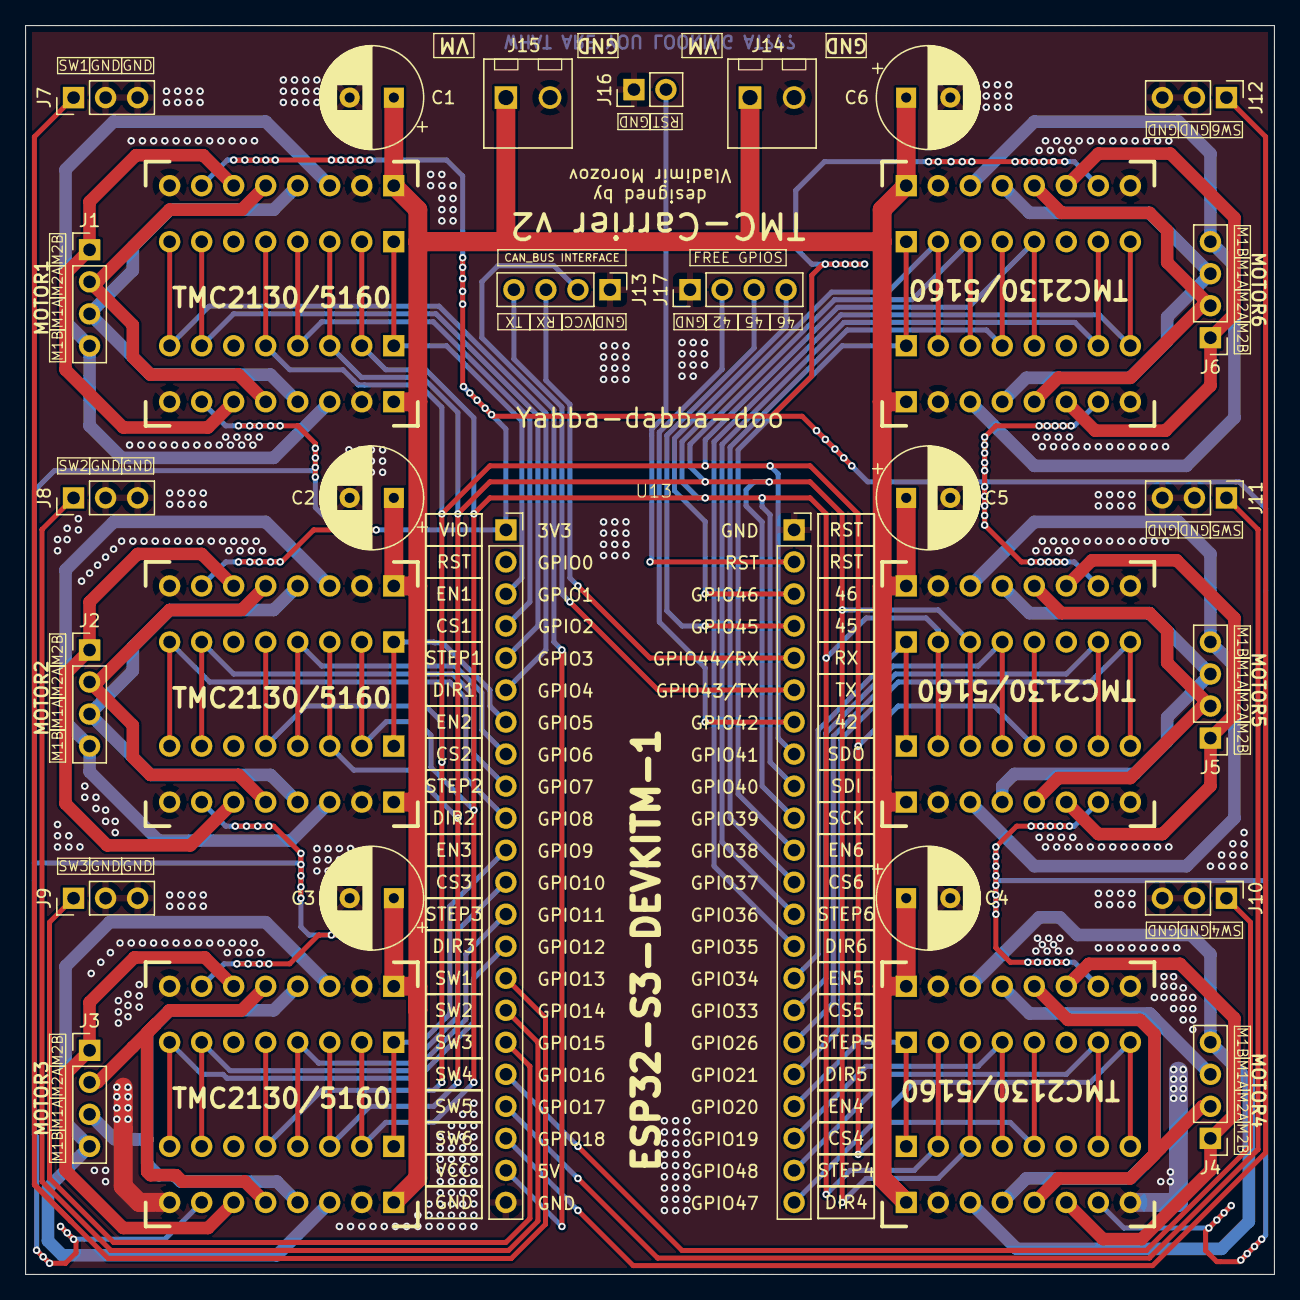
[picture p170: board Driver Carrier v1.kicad_pcb from above]

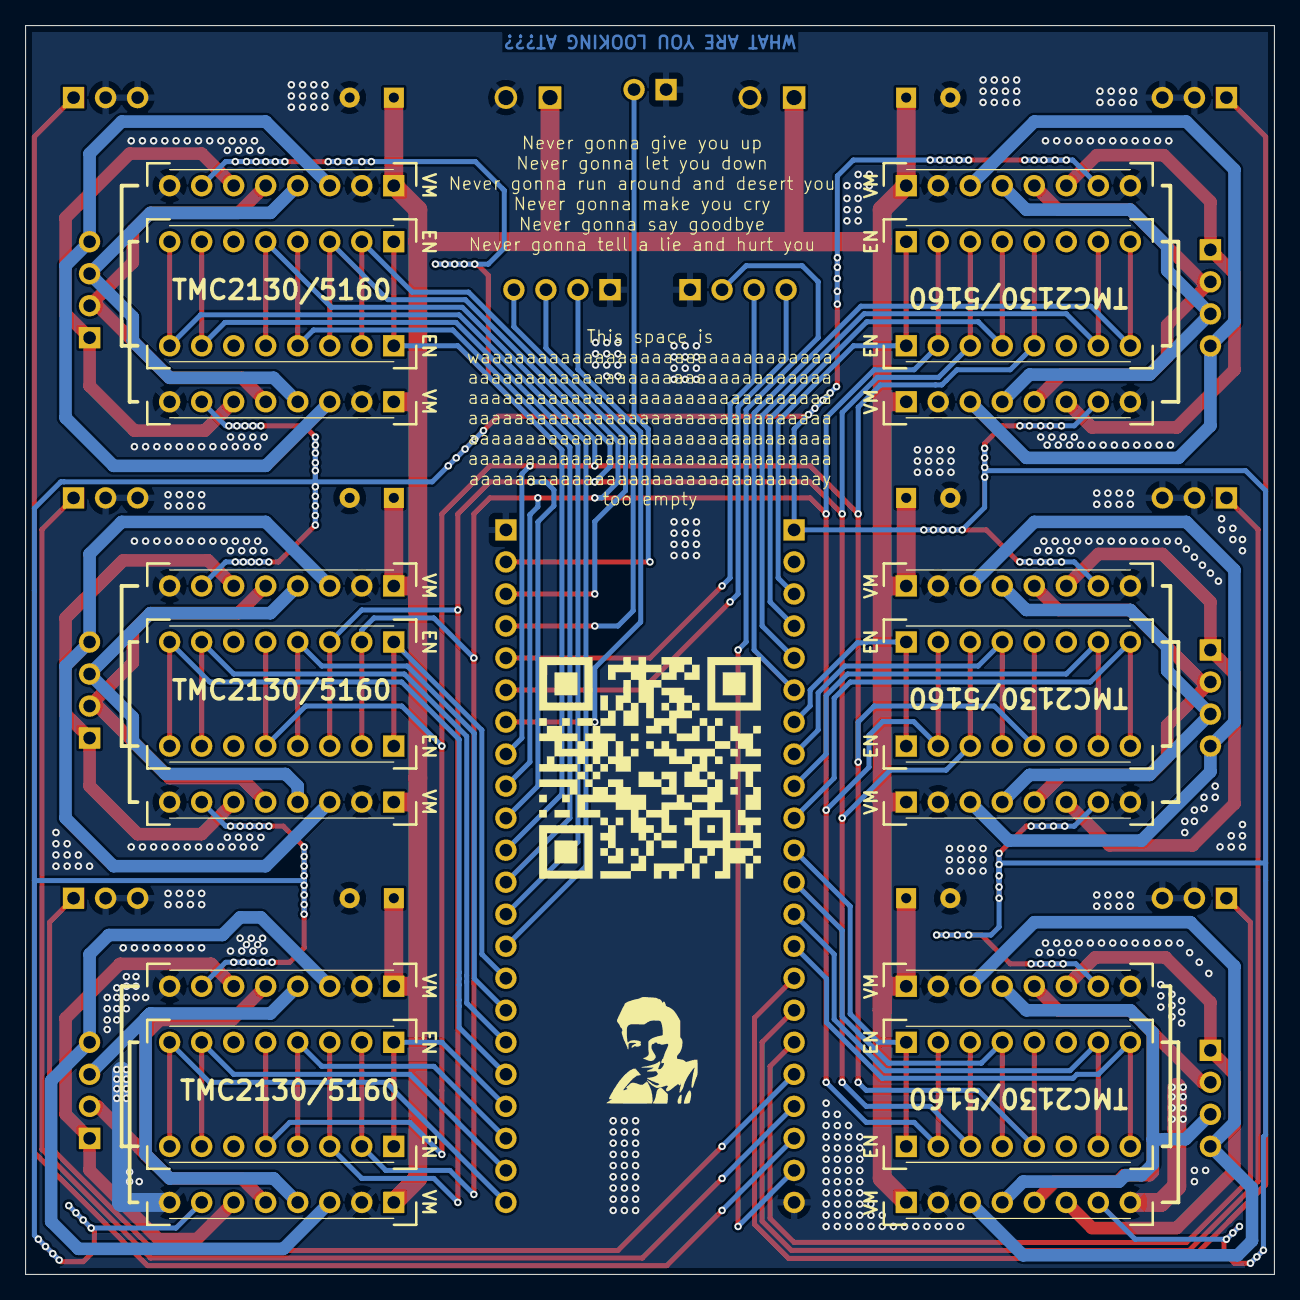
[picture p171: board Driver Carrier v1.kicad_pcb from below]

Board: 2 copper layers, 99.1 x 99.1 mm, 36 parts (12 on the bottom side), 67 nets.
