Vinomakon/6-Axis-Robotarm/Python Projects/VEPR-Control v2/constants.py

# First Adresses
# 0-5 are occupied by the motors
igener = '6' # General Parameters
istart = '900' # Starting all the motors


# Second Motor Addresses
ienmot = '00' # Enable motor
iangle = '01' # Set angle to move to
ispeed = '02' # Set speed
iaccel = '03' # Set acceleration
ireduc = '04' # Set reduction
ihomst = '10' # Start homing
ihomsp = '11' # Set homing speed
ihomin = '12' # Set inverse homing
ihomac = '13' # Set homing acceleration
ishmof = '14' # Set homing offset
ihommu = '15' # Set homing speed multiplier
ihomof = '16' # Set homing offset
itmcen = '20' # Initiate TMC
imrstp = '21' # Set microstep resolution
i_irun = '22' # Set peak RMS
i_hold = '23' # Set Hold Current Multiplier
icrpos = '80' # Get current Position
istpos = '81' # Set current Position (Emergency)

# General Addresses ('6' or 'igener')
idefst = '00' # Set default steps
