Vinomakon/6-Axis-Robotarm/Arduino Projects/MKS 42C Servo Test/figure/constants.h

// PINS FOR TMC-SPI
extern int SDO_PIN;
extern int SCK_PIN;
extern int SDI_PIN;

// PINS FOR MOTOR 1
extern int DIR1_PIN;
extern int STEP1_PIN;
extern int EN1_PIN;
extern int CS1_PIN;
extern int SW1_PIN;

// PINS FOR MOTOR 1
extern int DIR2_PIN;
extern int STEP2_PIN;
extern int EN2_PIN;
extern int CS2_PIN;
extern int SW2_PIN;

// VALUES FOR ESP
extern int ONE_ROTATION;
extern int HOME_OFFSET;
extern int DEFAULT_SPEED;
extern int HOMING_SPEED;
extern int SHOMING_SPEED;

// VALUES FOR TMC
extern int STALL_VALUE;
extern int R_SENSE;
extern int MSTEP;

// WRITE ADDRESS
extern int WRITE_ADDR;
