Vinomakon/6-Axis-Robotarm/(commit log)

2025-02-12 Added Homing Functionality
2025-02-12 Organization of Files
    [MaA-Bewertungstool ProduktKreation.xlsx, Register_summary.xlsx, Shopping List 12.02.2025 .xlsx, Shopping List Template.xlsx, TMC-Carrier-Board 3.02.2025 .xlsx, TMC5130_TMC2130_TMC2100_Calculations.xlsx]
2025-02-13 Rewrote Main Code
    Instead of using my own code, I used the libraries "AccelStepper", "TMCStepper" and the built-in SPI function.
    [Shopping List 12.02.2025 .xlsx]
2025-02-20 Added Big Motors
2025-02-21 Integration of 3 more motors
    Still need to implement the synchrounous movement
    [Motor Wiring_Calculations.xlsx]
2025-02-24 Started work on the next Carrier Board
    [Driver Carrier Shopping List 24.02.2025.xlsx, Driver Carrier v1.kicad_pcb, Driver Carrier v1.kicad_sch, TMC-Carrier-Board 3.02.2025 .xlsx, sss_insert.kicad_sch]
2025-02-25 Continued working on the PCB
    [Driver Carrier v1.kicad_pcb, Driver Carrier v1.kicad_sch, all_tmcs.kicad_sch, both_tmcs.kicad_sch, sss_tmc2130.kicad_sch, sss_tmc5160.kicad_sch]
2025-02-26 Finished Driver Carrier
    [Driver Carrier Shopping List 24.02.2025.xlsx, Driver Carrier Shopping List 26.02.2025.xlsx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]
2025-02-26 Update Arbeitsjournal
    [Driver Carrier v1-NPTH.drl, Driver Carrier v1-PTH.drl, Driver Carrier v1-job.gbrjob]
2025-02-27 Unknown Changes
    [Driver Carrier v1.kicad_pcb, Driver Carrier v1.kicad_sch]
2025-04-16 New PCB and testing belt drive
2025-07-15 Progress 15.07
    A LOOOT of new things
    [Arm1.SLDPRT, Arm1Pulley1.SLDPRT, Arm1Pulley2.SLDPRT, Arm2.SLDPRT, Arm2Pulley.SLDASM, Arm2PulleyHigh.SLDPRT, Arm2PulleyLow.SLDPRT, Arm2PulleyMid.SLDPRT]
2025-07-22 6th Motor Addition
    Python and Arduino
2025-07-22 6th Arm finished
    [1mmRing.SLDPRT, Arm2.SLDPRT, Arm2Pulley.SLDASM, Arm2PulleyHigh.SLDPRT, Arm2PulleyLow.SLDPRT, Arm2PulleyMid.SLDPRT, Arm3.SLDPRT, Arm3Pulley.SLDASM]
2025-07-23 UI Redesign v1
    [Arm2Pulley.SLDASM, RobotAssembly.SLDASM]
2025-07-25 Current Limiting fix
2025-07-31 Preparing for 3rd prototype
    Preparing for 3rd prototype and starting work on Arm0
    [17HE19-2004S.SLDPRT, 17HE24-2104S1.SLDASM, 17HS10-0704S.SLDPRT, 1mmRing.SLDPRT, Arm0.SLDPRT, Arm0MotorHolder.SLDPRT, Arm0Pulley.SLDPRT, Arm1.SLDPRT]
2025-08-08 MILESTONE Working Prototype
    [Arm0HolderHigh_v1.SLDPRT, Arm0HolderMid_v1.SLDPRT, Arm0MotorHolder_v1.SLDPRT, Arm0_v1.SLDPRT, Arm1_v3.SLDPRT, Arm2PulleyHigh_v1.SLDPRT, Arm2PulleyLow_v1.SLDPRT, Arm2PulleyMid_v1.SLDPRT]
2025-08-10 Started testing with implementation of IK
    Currently on figuring out, how to calculate the needed position
2025-08-17 Better Cable Management
    [Arm1CableHolder_v3.SLDPRT, Arm2Pulley.SLDASM, Arm2PulleyHigh.SLDPRT, Arm2PulleyLow.SLDPRT, Arm2PulleyMid.SLDPRT, Arm3.SLDPRT, Arm3PulleyHigh_v1.SLDPRT, Arm3PulleyLow_v1.SLDPRT]
2025-08-18 Changed Pin-Out
2025-08-18 Added Arm0 Limit Switch Actuator
    [Arm0HolderHigh_v1.SLDPRT, Arm0SwitchActuator_v1.SLDPRT, Arm0_v1.SLDPRT, Base_v1.SLDPRT, Prototype_Robot_Assembly_v2.SLDASM]
2025-08-21 Implemented IK into UI
    Have not tested it out yet, because of a broken variable power supply
    [constants.py, main.cpp, main.py]
2025-09-03 First Iteration of Report
    [AluminiumExtrusion.SLDPRT, Arm1Pulley2.SLDPRT, Arm1Pulley2_v3.SLDPRT, Arm3PulleyLow_v1.SLDPRT, Arm3Pulley_v1.SLDASM, Arm4_v1.SLDPRT, BaseHolderMid_v1.SLDPRT, BaseSideHolder.SLDPRT]
2025-09-12 New LaTeX graphics
    [Arm1_v3.SLDPRT, Arm2Pulley_v1.SLDASM, Base_v1.SLDPRT]
2025-09-21 Renewed some Solidworks Models
    [Arm0HolderHigh_v1.SLDPRT, Arm1Pulley2_v3.SLDPRT, Arm2PulleyHigh.STEP, Arm2Pulley_v1.SLDASM, Arm3PulleyHigh_v1.SLDPRT, Arm3Pulley_v1.SLDASM, Arm3_v1.SLDPRT]
2025-10-08 A lot has changed :(
    [1mmSpacer_fv1.SLDPRT, Arm0CableCrimp.SLDPRT, Arm0HolderHigh_v1.SLDPRT, Arm0MotorHolder_v1.SLDPRT, Arm0Pulley.SLDPRT, Arm0SwitchActuator_v1.SLDPRT, Arm0_v1.SLDPRT, Arm1.SLDPRT]
2025-10-10 On the way
    [Arm1_v3.SLDPRT, Arm2Pulley_v2.SLDASM, Base.SLDPRT, Cap.SLDPRT, parameters.cpp.txt]
2025-12-26 Software version 2.0
    [Arm1_v3.SLDPRT, BOM.xlsx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]
2026-01-07 theoretical automations
    [Arm1_v3.SLDPRT, FullAssembly_wo_Fasteners.SLDASM]
